xiaokaizip/foc/circuit/candence/DESIGN1.png

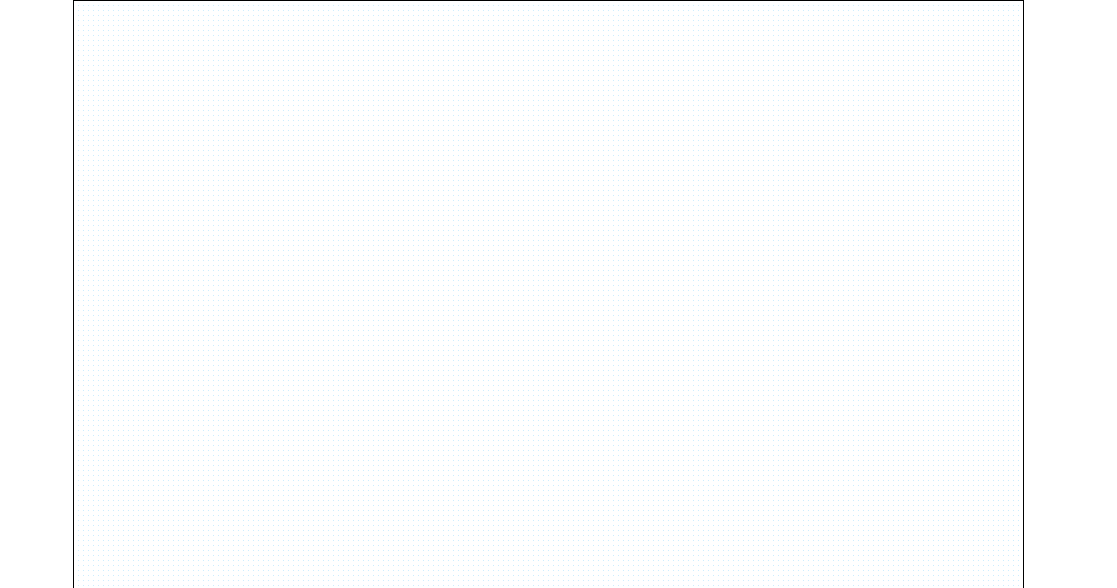
circuit/candence/DESIGN1.png
