xiaokaizip/foc/circuit/candence/hpm/HPM_ECAT_FOC.png

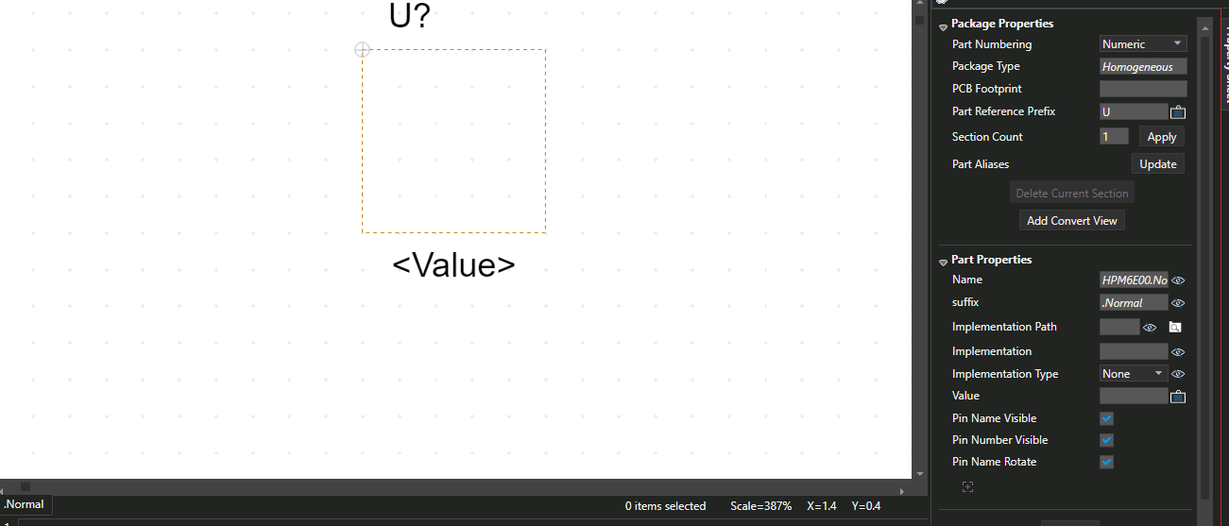
circuit/candence/hpm/HPM_ECAT_FOC.png
