xiaokaizip/foc/circuit/candence/POWER.png

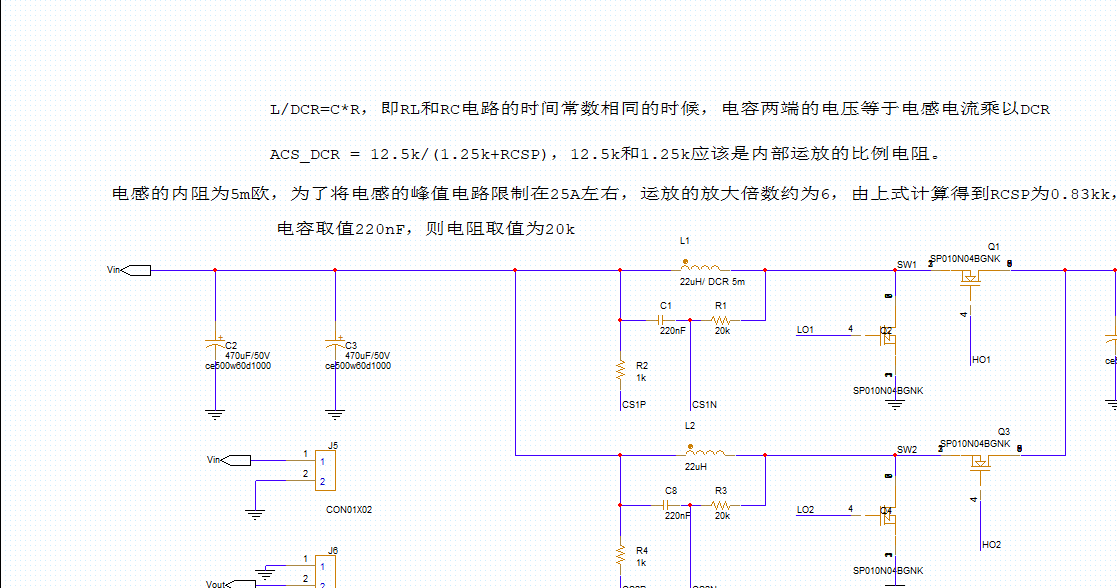
circuit/candence/POWER.png
