xiaokaizip/foc/circuit/candence/stm32/STSPIN32G4_FOC.png

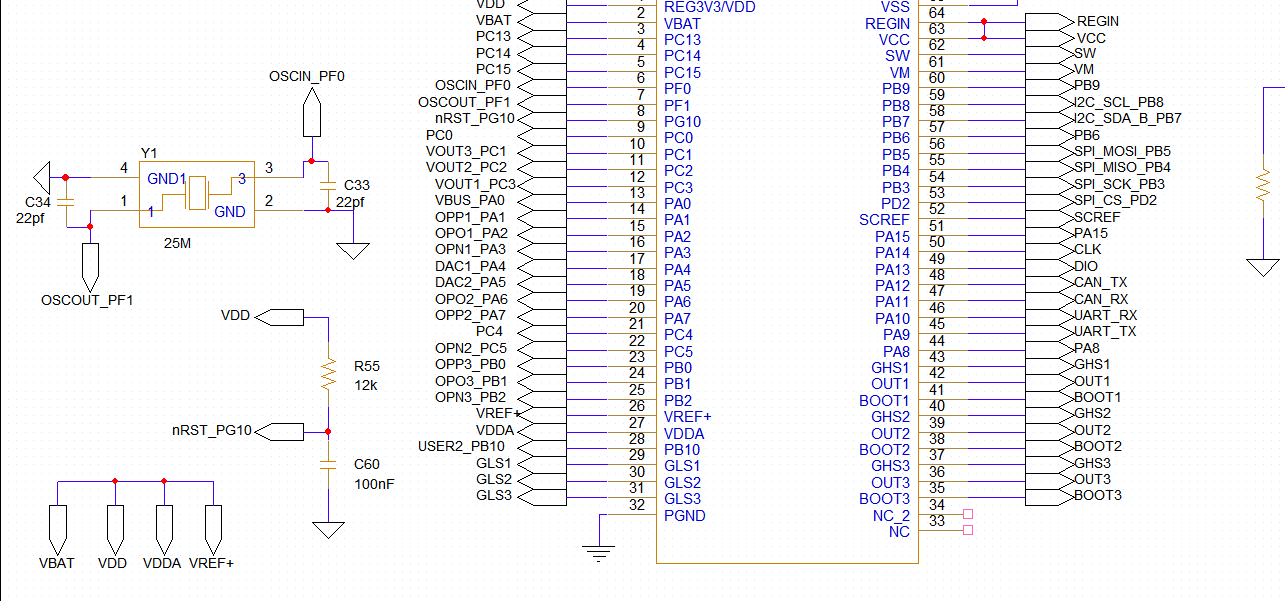
circuit/candence/stm32/STSPIN32G4_FOC.png
