xiaokaizip/foc/circuit/candence/stm32/STSPIN32G4.xlsx

Revised: Thursday, November 20, 2025
Revision:
Bill Of Materials November 20,2025 11:11:35 | Page1
Item | Quantity | Reference | Part | footprint | JLC
______________________________________________
1 | 4 | C1,C2,C3,C4 | 22nF | c0402
2 | 2 | C5,C6 | 22nF | r0402
3 | 14 | C7,C8,C11,C23,C24,C25,C26,C27,C28,C35,C37,C39,C41,C42 | 100nF | c0402
4 | 1 | C13 | 10u | c0805 | C440198
5 | 21 | C14,C15,C16,C17,C18,C19,C20,C21,C22,C48,C49,C50,C51,C52,C53,C54,C55,C56,C57,C58,C59 | 10u | c0805
6 | 1 | C29 | 220nF | c0402
7 | 2 | C30,C31 | 22uF | c1206
8 | 1 | C32 | 22uF | c0805
9 | 2 | C33,C34 | 22pf | c0402
10 | 3 | C36,C38,C40 | 1uF | c0603
11 | 5 | C43,C44,C45,C46,C47 | 10u | c0603
12 | 2 | D1,D2 | LED | led0402
13 | 1 | D7 | B5819WSL | sod_323
14 | 1 | D8 | SMBJ36CA | sod_214
15 | 1 | D9 | JLC | sod123 | C353271
16 | 1 | F1 | fulse | r1206
17 | 1 | J1 | SH_01x03 | SH1_0_3p
18 | 1 | J2 | SH_01x08 | SH1_0_8p
19 | 1 | J3 | hole_01x04 | 4_hole
20 | 3 | J4,J5,J6 | CON_01x01 | SMD50_50
21 | 1 | L1 | DLW21HN900SQ2L | SMD-4P
22 | 1 | L2 | 10uH | R1210
23 | 2 | NTC1,NTC2 | 10k | r0603
24 | 8 | R1,R5,R6,R9,R10,R15,R16,R17 | 24k | r0402
25 | 13 | R2,R7,R8,R11,R12,R18,R19,R20,R44,R46,R47,R48,R49 | 2k | R0402
26 | 2 | R3,R4 | 4.7k | r0402
27 | 8 | R13,R14,R24,R25,R26,R33,R34,R35 | 12k | r0402
28 | 6 | R21,R22,R23,R30,R31,R32 | 10R | r0402
29 | 3 | R39,R40,R41 | 50m | r0805
30 | 2 | R42,R43 | 60 | R0402
31 | 1 | R45 | 2k | c0402
32 | 7 | U1,U2,U3,U4,U5,U6,U11 | CSD18543Q3ADNH | DNH0008A
33 | 1 | U7 | TCAN3403 | SOT-23-THIN-8_DDF_TEX
34 | 1 | U8 | ESD2CAN | sot23-3
35 | 1 | U9 | MT6825 | PW0016A_L
36 | 1 | U10 | STSPIN32G4 | QFN_IN32G4_STM
37 | 1 | Y1 | 25M | x4-3225
