xiaokaizip/foc/circuit/candence/stm32/20251127 -便携式数据采集线材-林凯.xlsx

物品名称 | 用途 | 型号 | 数量 | 参考图片 | 参考链接 | 单价（元） | 总价（元） | 备注
12VPD诱骗线 | 便携式数据采集相机供电用 | Type-C转PD12V3A诱骗线 | 5 |  | https://detail.tmall.com/item.htm?ali_trackid=1_b0a4eecbaa4b6b593b52d8781035511b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 | 19.32 | 96.6 | 深圳收货
扁平网线 | 便携式数据采集网线接口 | 超短体-纯铜七类万兆网线 黑色 0.5m | 5 |  | https://detail.tmall.com/item.htm?ali_trackid=1_3b86c21500981edd2e272d85cf04a002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 | 13.6 | 68
 |  |  |  |  |  | 林凯 2025.11.27
