xiaokaizip/foc/circuit/candence/stm32/STSPIN32G4_FOC.xlsx

Revised: Thursday, November 20, 2025
Revision:
Bill Of Materials November 20,2025 10:31:08 | Page1
Item | Quantity | Reference | Part | JLC
______________________________________________
1 | 6 | C1,C2,C3,C4,C5,C6 | 22nF
2 | 14 | C7,C8,C11,C23,C24,C25,C26,C27,C28,C35,C37,C39,C41,C42 | 100nF
3 | 1 | C13 | 10u | C440198
4 | 26 | C14,C15,C16,C17,C18,C19,C20,C21,C22,C43,C44,C45,C46,C47,C48,C49,C50,C51,C52,C53,C54,C55,C56,C57,C58,C59 | 10u
5 | 1 | C29 | 220nF
6 | 3 | C30,C31,C32 | 22uF
7 | 2 | C33,C34 | 22pf
8 | 3 | C36,C38,C40 | 1uF
9 | 2 | D1,D2 | LED
10 | 1 | D7 | B5819WSL
11 | 1 | D8 | SMBJ36CA
12 | 1 | D9 | JLC | C353271
13 | 1 | F1 | fulse
14 | 1 | J1 | SH_01x03
15 | 1 | J2 | SH_01x08
16 | 1 | J3 | hole_01x04
17 | 3 | J4,J5,J6 | CON_01x01
18 | 1 | L1 | DLW21HN900SQ2L
19 | 1 | L2 | 10uH
20 | 2 | NTC1,NTC2 | 10k
21 | 8 | R1,R5,R6,R9,R10,R15,R16,R17 | 24k
22 | 14 | R2,R7,R8,R11,R12,R18,R19,R20,R44,R45,R46,R47,R48,R49 | 2k
23 | 2 | R3,R4 | 4.7k
24 | 8 | R13,R14,R24,R25,R26,R33,R34,R35 | 12k
25 | 6 | R21,R22,R23,R30,R31,R32 | 10R
26 | 3 | R39,R40,R41 | 50m
27 | 2 | R42,R43 | 60
28 | 7 | U1,U2,U3,U4,U5,U6,U11 | CSD18543Q3ADNH
29 | 1 | U7 | TCAN3403
30 | 1 | U8 | ESD2CAN
31 | 1 | U9 | MT6825
32 | 1 | U10 | STSPIN32G4
33 | 1 | Y1 | 25M
