xiaokaizip/foc/circuit/candence/stm32/DM3510.dxf

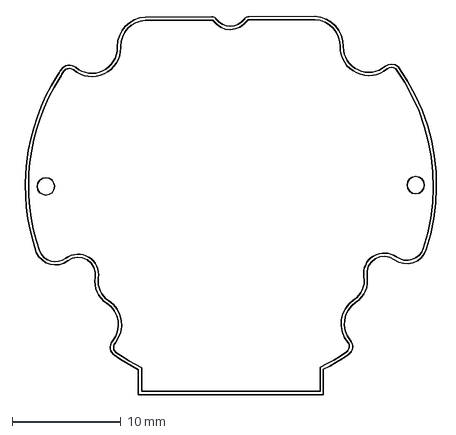
[picture p7: CAD file, 2026-01-14]
circuit/candence/stm32/DM3510.dxf
39.0 x 34.8 mm
