xiaokaizip/foc/circuit/candence/stm32/FILM_SETUP.txt

axlFilmCreate( "all" ?negative nil ?undefineLineWidth 0.1524 ?sequence 1 
	?rotation 0 ?xOffset 0.0000 ?yOffset 0.0000 ?shapeBoundingBox 0.0000 ?mirrored nil ?fullContact nil 
	?suppressUnconnectPads nil ?drawMissingPadApertures nil ?useApertureRotation nil 
	?suppressShapeFill nil ?vectorBasedPad t ?drawHolesOnly nil 
	?domains '(ipc2581 pdf artwork visibility ) ?ipc2581 '() 
	?layers '("PIN/TOP" "PIN/BOTTOM" "PACKAGE GEOMETRY/SILKSCREEN_TOP" "BOARD GEOMETRY/SILKSCREEN_TOP" "PACKAGE GEOMETRY/SILKSCREEN_BOTTOM" "BOARD GEOMETRY/SILKSCREEN_BOTTOM" "BOARD GEOMETRY/OUTLINE" ))
axlFilmCreate( "adt" ?negative nil ?undefineLineWidth 0.1524 ?sequence 2 
	?rotation 0 ?xOffset 0.0000 ?yOffset 0.0000 ?shapeBoundingBox 0.0000 ?mirrored nil ?fullContact nil 
	?suppressUnconnectPads nil ?drawMissingPadApertures nil ?useApertureRotation nil 
	?suppressShapeFill nil ?vectorBasedPad t ?drawHolesOnly nil 
	?domains '(ipc2581 pdf artwork visibility ) ?ipc2581 '() 
	?layers '("BOARD GEOMETRY/SILKSCREEN_TOP" "REF DES/SILKSCREEN_TOP" "PIN/TOP" "BOARD GEOMETRY/OUTLINE" ))
axlFilmCreate( "adb" ?negative nil ?undefineLineWidth 0.1524 ?sequence 3 
	?rotation 0 ?xOffset 0.0000 ?yOffset 0.0000 ?shapeBoundingBox 0.0000 ?mirrored nil ?fullContact nil 
	?suppressUnconnectPads nil ?drawMissingPadApertures nil ?useApertureRotation nil 
	?suppressShapeFill nil ?vectorBasedPad t ?drawHolesOnly nil 
	?domains '(ipc2581 pdf artwork visibility ) ?ipc2581 '() 
	?layers '("REF DES/SILKSCREEN_BOTTOM" "PACKAGE GEOMETRY/SILKSCREEN_BOTTOM" "BOARD GEOMETRY/SILKSCREEN_BOTTOM" "PIN/BOTTOM" "BOARD GEOMETRY/OUTLINE" ))
axlFilmCreate( "top" ?negative nil ?undefineLineWidth 0.1524 ?sequence 4 
	?rotation 0 ?xOffset 0.0000 ?yOffset 0.0000 ?shapeBoundingBox 0.0000 ?mirrored nil ?fullContact nil 
	?suppressUnconnectPads nil ?drawMissingPadApertures nil ?useApertureRotation nil 
	?suppressShapeFill nil ?vectorBasedPad t ?drawHolesOnly nil 
	?domains '(ipc2581 pdf artwork visibility ) ?ipc2581 '() 
	?layers '("VIA CLASS/TOP" "PIN/TOP" "ETCH/TOP" ))
axlFilmCreate( "gnd2" ?negative nil ?undefineLineWidth 0.1524 ?sequence 5 
	?rotation 0 ?xOffset 0.0000 ?yOffset 0.0000 ?shapeBoundingBox 0.0000 ?mirrored nil ?fullContact nil 
	?suppressUnconnectPads nil ?drawMissingPadApertures nil ?useApertureRotation nil 
	?suppressShapeFill nil ?vectorBasedPad t ?drawHolesOnly nil 
	?domains '(ipc2581 pdf artwork visibility ) ?ipc2581 '() 
	?layers '("VIA CLASS/GND2" "PIN/GND2" "ETCH/GND2" ))
axlFilmCreate( "power3" ?negative nil ?undefineLineWidth 0.1524 ?sequence 6 
	?rotation 0 ?xOffset 0.0000 ?yOffset 0.0000 ?shapeBoundingBox 0.0000 ?mirrored nil ?fullContact nil 
	?suppressUnconnectPads nil ?drawMissingPadApertures nil ?useApertureRotation nil 
	?suppressShapeFill nil ?vectorBasedPad t ?drawHolesOnly nil 
	?domains '(ipc2581 pdf artwork visibility ) ?ipc2581 '() 
	?layers '("VIA CLASS/POWER3" "PIN/POWER3" "ETCH/POWER3" ))
axlFilmCreate( "bottom" ?negative nil ?undefineLineWidth 0.1524 ?sequence 7 
	?rotation 0 ?xOffset 0.0000 ?yOffset 0.0000 ?shapeBoundingBox 0.0000 ?mirrored nil ?fullContact nil 
	?suppressUnconnectPads nil ?drawMissingPadApertures nil ?useApertureRotation nil 
	?suppressShapeFill nil ?vectorBasedPad t ?drawHolesOnly nil 
	?domains '(ipc2581 pdf artwork visibility ) ?ipc2581 '() 
	?layers '("VIA CLASS/BOTTOM" "PIN/BOTTOM" "ETCH/BOTTOM" ))
axlFilmCreate( "silktop" ?negative nil ?undefineLineWidth 0.1524 ?sequence 8 
	?rotation 0 ?xOffset 0.0000 ?yOffset 0.0000 ?shapeBoundingBox 0.0000 ?mirrored nil ?fullContact nil 
	?suppressUnconnectPads nil ?drawMissingPadApertures nil ?useApertureRotation nil 
	?suppressShapeFill nil ?vectorBasedPad t ?drawHolesOnly nil 
	?domains '(ipc2581 pdf artwork visibility ) ?ipc2581 '() 
	?layers '("REF DES/SILKSCREEN_TOP" "PACKAGE GEOMETRY/SILKSCREEN_TOP" "BOARD GEOMETRY/SILKSCREEN_TOP" "BOARD GEOMETRY/OUTLINE" ))
axlFilmCreate( "silkbot" ?negative nil ?undefineLineWidth 0.1524 ?sequence 9 
	?rotation 0 ?xOffset 0.0000 ?yOffset 0.0000 ?shapeBoundingBox 0.0000 ?mirrored nil ?fullContact nil 
	?suppressUnconnectPads nil ?drawMissingPadApertures nil ?useApertureRotation nil 
	?suppressShapeFill nil ?vectorBasedPad t ?drawHolesOnly nil 
	?domains '(ipc2581 pdf artwork visibility ) ?ipc2581 '() 
	?layers '("REF DES/SILKSCREEN_BOTTOM" "PACKAGE GEOMETRY/SILKSCREEN_BOTTOM" "BOARD GEOMETRY/SILKSCREEN_BOTTOM" "BOARD GEOMETRY/OUTLINE" ))
axlFilmCreate( "soldtop" ?negative nil ?undefineLineWidth 0.1524 ?sequence 10 
	?rotation 0 ?xOffset 0.0000 ?yOffset 0.0000 ?shapeBoundingBox 0.0000 ?mirrored nil ?fullContact nil 
	?suppressUnconnectPads nil ?drawMissingPadApertures nil ?useApertureRotation nil 
	?suppressShapeFill nil ?vectorBasedPad t ?drawHolesOnly nil 
	?domains '(ipc2581 pdf artwork visibility ) ?ipc2581 '() 
	?layers '("PIN/SOLDERMASK_TOP" "PACKAGE GEOMETRY/SOLDERMASK_TOP" "BOARD GEOMETRY/SOLDERMASK_TOP" "BOARD GEOMETRY/OUTLINE" ))
axlFilmCreate( "soldbot" ?negative nil ?undefineLineWidth 0.1524 ?sequence 11 
	?rotation 0 ?xOffset 0.0000 ?yOffset 0.0000 ?shapeBoundingBox 0.0000 ?mirrored nil ?fullContact nil 
	?suppressUnconnectPads nil ?drawMissingPadApertures nil ?useApertureRotation nil 
	?suppressShapeFill nil ?vectorBasedPad t ?drawHolesOnly nil 
	?domains '(ipc2581 pdf artwork visibility ) ?ipc2581 '() 
	?layers '("PIN/SOLDERMASK_BOTTOM" "PACKAGE GEOMETRY/SOLDERMASK_BOTTOM" "BOARD GEOMETRY/SOLDERMASK_BOTTOM" "BOARD GEOMETRY/OUTLINE" ))
axlFilmCreate( "pasttop" ?negative nil ?undefineLineWidth 0.1524 ?sequence 12 
	?rotation 0 ?xOffset 0.0000 ?yOffset 0.0000 ?shapeBoundingBox 0.0000 ?mirrored nil ?fullContact nil 
	?suppressUnconnectPads nil ?drawMissingPadApertures nil ?useApertureRotation nil 
	?suppressShapeFill nil ?vectorBasedPad t ?drawHolesOnly nil 
	?domains '(ipc2581 pdf artwork visibility ) ?ipc2581 '() 
	?layers '("PIN/PASTEMASK_TOP" "PACKAGE GEOMETRY/PASTEMASK_TOP" "BOARD GEOMETRY/OUTLINE" ))
axlFilmCreate( "pastbot" ?negative nil ?undefineLineWidth 0.1524 ?sequence 13 
	?rotation 0 ?xOffset 0.0000 ?yOffset 0.0000 ?shapeBoundingBox 0.0000 ?mirrored nil ?fullContact nil 
	?suppressUnconnectPads nil ?drawMissingPadApertures nil ?useApertureRotation nil 
	?suppressShapeFill nil ?vectorBasedPad t ?drawHolesOnly nil 
	?domains '(ipc2581 pdf artwork visibility ) ?ipc2581 '() 
	?layers '("PIN/PASTEMASK_BOTTOM" "PACKAGE GEOMETRY/PASTEMASK_BOTTOM" "BOARD GEOMETRY/OUTLINE" ))
axlFilmCreate( "drill" ?negative nil ?undefineLineWidth 0.1524 ?sequence 14 
	?rotation 0 ?xOffset 0.0000 ?yOffset 0.0000 ?shapeBoundingBox 0.0000 ?mirrored nil ?fullContact nil 
	?suppressUnconnectPads nil ?drawMissingPadApertures nil ?useApertureRotation nil 
	?suppressShapeFill t ?vectorBasedPad t ?drawHolesOnly nil 
	?domains '(ipc2581 pdf artwork visibility ) ?ipc2581 '() 
	?layers '("BOARD GEOMETRY/DIMENSION" "BOARD GEOMETRY/OUTLINE" "MANUFACTURING/NCDRILL_LEGEND" "MANUFACTURING/NCDRILL_FIGURE" ))
axlFilmCreate( "outline" ?negative nil ?undefineLineWidth 0.1524 ?sequence 15 
	?rotation 0 ?xOffset 0.0000 ?yOffset 0.0000 ?shapeBoundingBox 0.0000 ?mirrored nil ?fullContact nil 
	?suppressUnconnectPads nil ?drawMissingPadApertures nil ?useApertureRotation nil 
	?suppressShapeFill t ?vectorBasedPad t ?drawHolesOnly nil 
	?domains '(ipc2581 pdf artwork visibility ) ?ipc2581 '() 
	?layers '("BOARD GEOMETRY/OUTLINE" ))
