xiaokaizip/foc/docs/mb1428-g474re-b01_schematic.pdf

Title: Project overview

Size:

Reference:
A4 | Sheet: | of

Revision:

Project: STM32G4 DPOW Discovery

B 01 | MB1428
28-JUNE-19

G474RE

Date:

Variant:

Table of contents | Legend

General comment such as function title, configuration, ...

Text to be added to silkscreen.

Sheet 1: Project overview (this page)

Sheet 2: MB1428_Top

# STM32G4 DPOW Discovery

MB1428

Sheet 3: STM32 microcontroller I/Os

Sheet 4: STM32 microcontroller power

Sheet 10: ST-Link/V3E

Sheet 12: License agreement

Sheet 9: Power

Sheet 8: Extension connectors

Sheet 11: Mechanical

Warning text.

# Open Platform License Agreement

The Open Platform License Agreement (“Agreement”) is a binding legal contract between you ("You")

and STMicroelectronics International N.V. (“ST”), a company incorporated under the laws of the

Netherlands acting for the purpose of this Agreement through its Swiss branch 39, Chemin du

Champ des Filles, 1228 Plan-les-Ouates, Geneva, Switzerland.

By using the enclosed reference designs, schematics, PC board layouts, and documentation, in hardcopy

or CAD tool file format (collectively, the “Reference Material”), You are agreeing to be bound by

the terms and conditions of this Agreement. Do not use the Reference Material until You have read

and agreed to this Agreement terms and conditions. The use of the Reference Material automatically

implies the acceptance of the Agreement terms and conditions.

The complete Open Platform License Agreement can be found on www.st.com/opla.

U_MB1428_Top
MB1428_Top.SchDoc

Sheet 7: Buck Boost Converter

Sheet 6: RGB LED Buck Converters

Sheet 5: USB PD & USB Type-C

Notes to generate the
board layout.

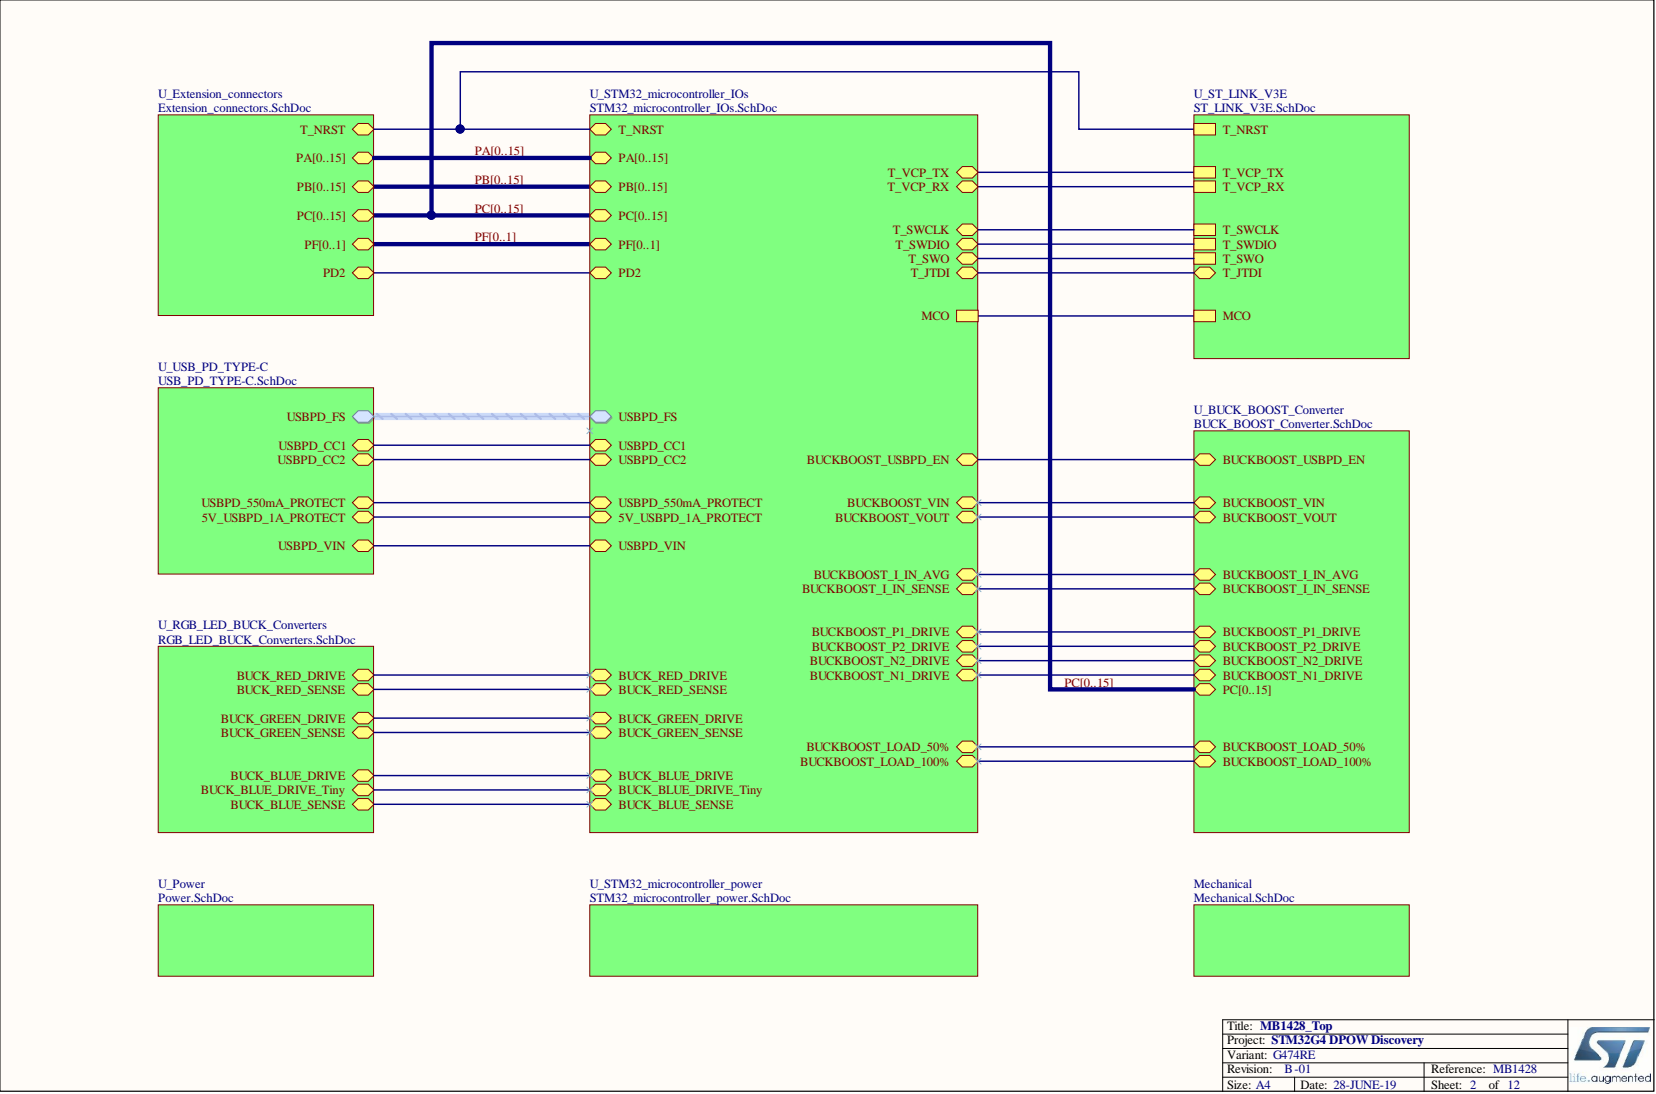
[picture p8: page 2]

Cuttable part on PCB

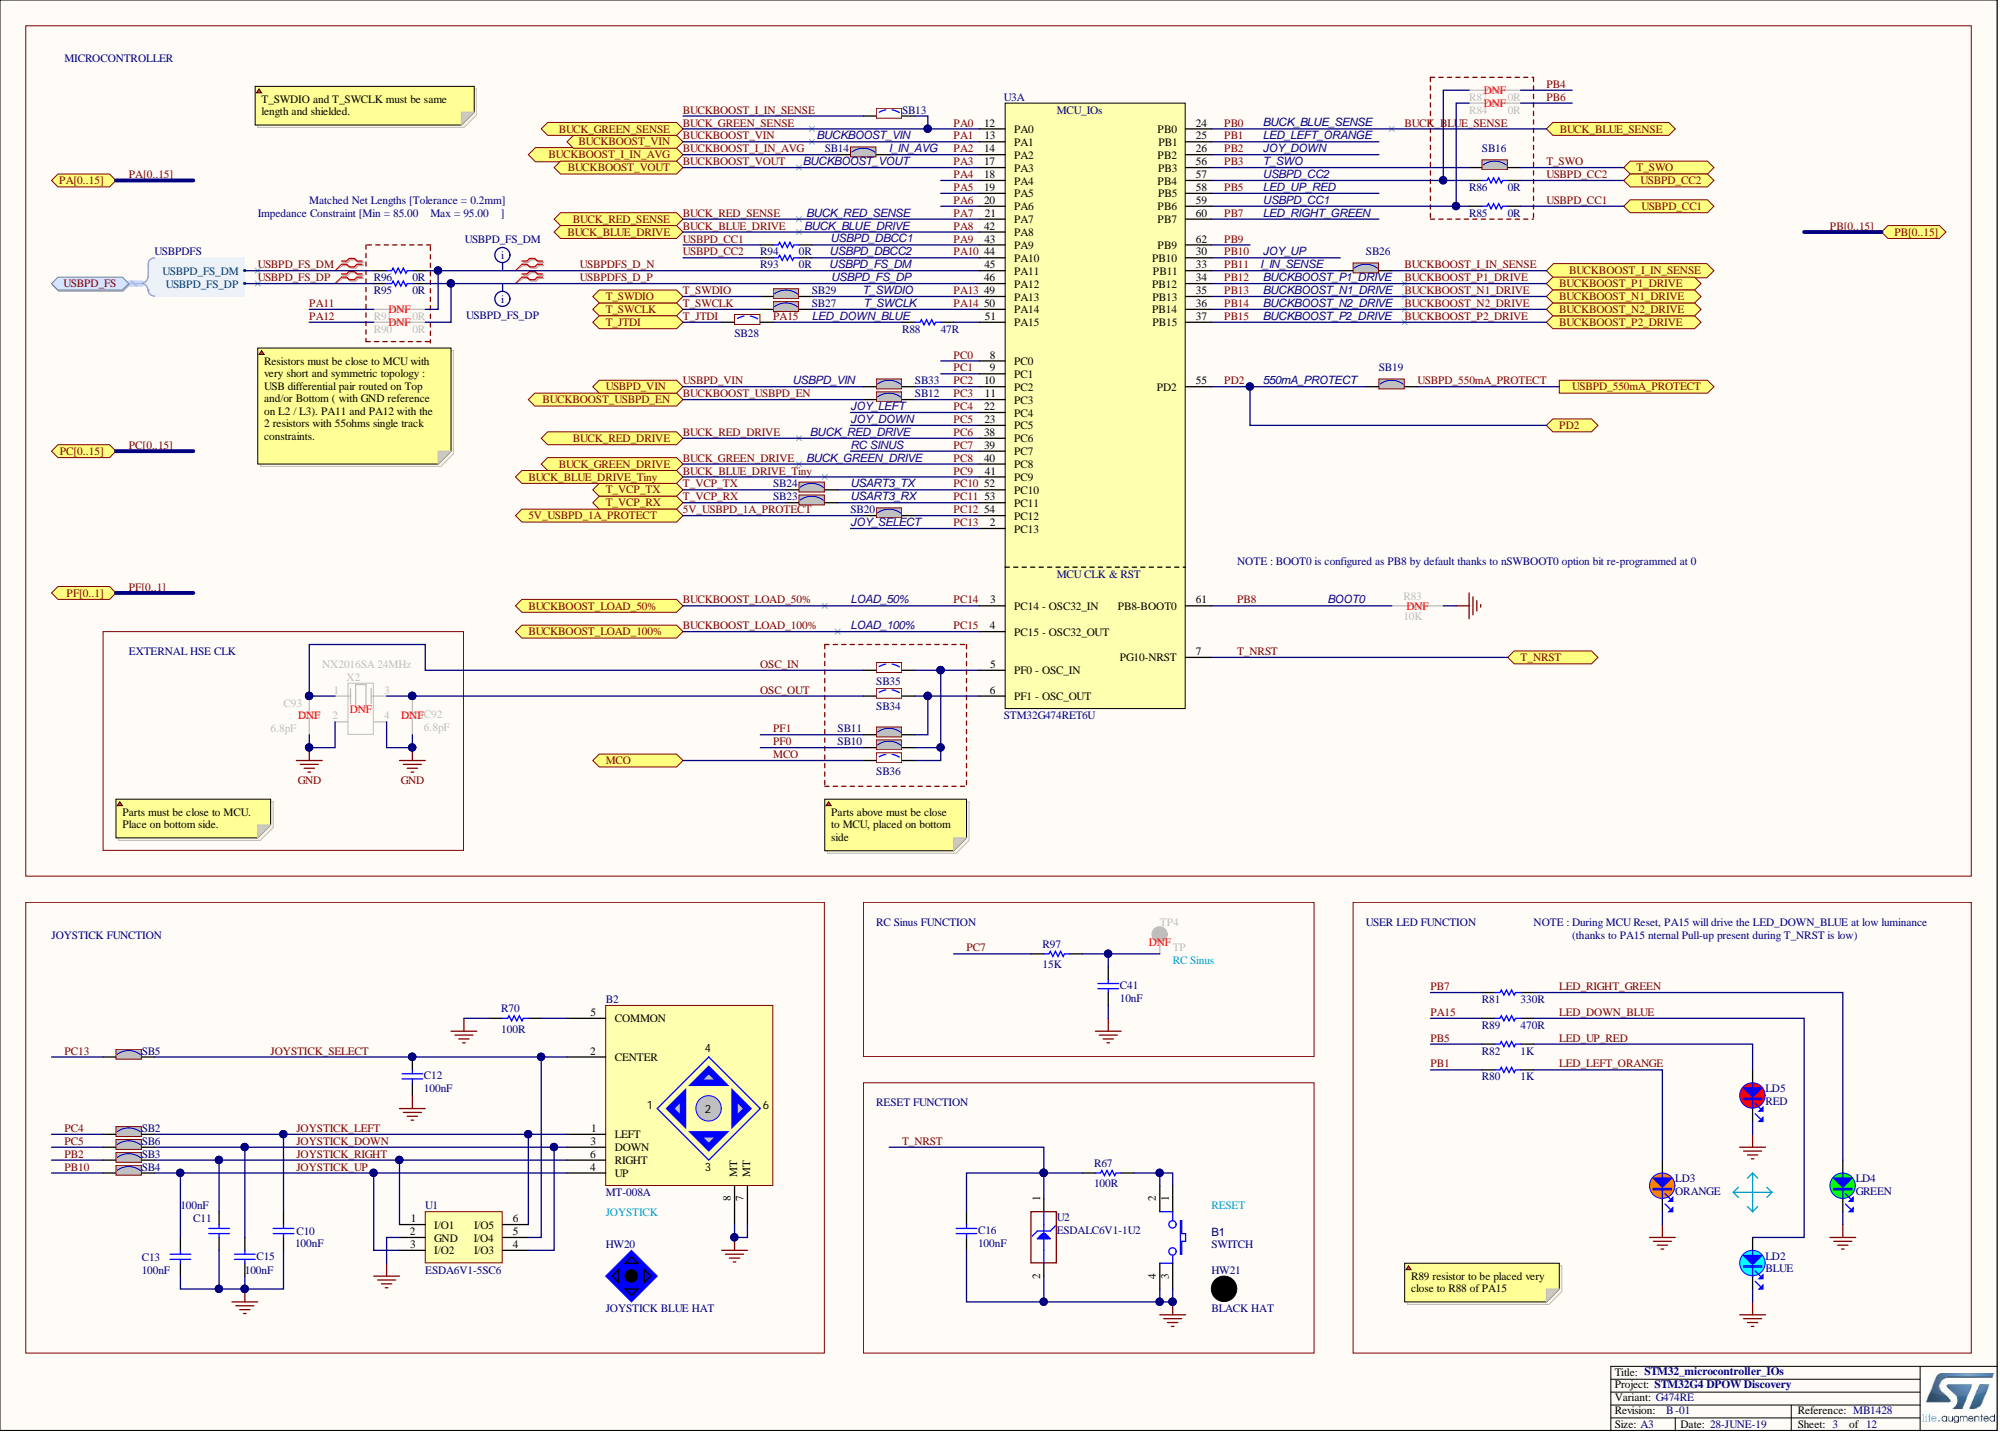
[picture p9: page 3]

T_SWDIO and T_SWCLK must be same
length and shielded.

Matched Net Lengths [Tolerance = 0.2mm]

Impedance Constraint [Min = 85.00 Max = 95.00 ]

Resistors must be close to MCU with
very short and symmetric topology :
USB differential pair routed on Top
and/or Bottom ( with GND reference
on L2 / L3). PA11 and PA12 with the
2 resistors with 55ohms single track
constraints.

NOTE : BOOT0 is configured as PB8 by default thanks to nSWBOOT0 option bit re-programmed at 0

Parts must be close to MCU.
Place on bottom side.

Parts above must be close
to MCU, placed on bottom
side

NOTE : During MCU Reset, PA15 will drive the LED_DOWN_BLUE at low luminance

(thanks to PA15 nternal Pull-up present during T_NRST is low)

CENTER 2

C12 | | | DOWN 3 LEFT 1

SB6 | JOYSTICK_DOWN
SB3 | | JOYSTICK_RIGHT | | RIGHT 6

R89 resistor to be placed very
close to R88 of PA15

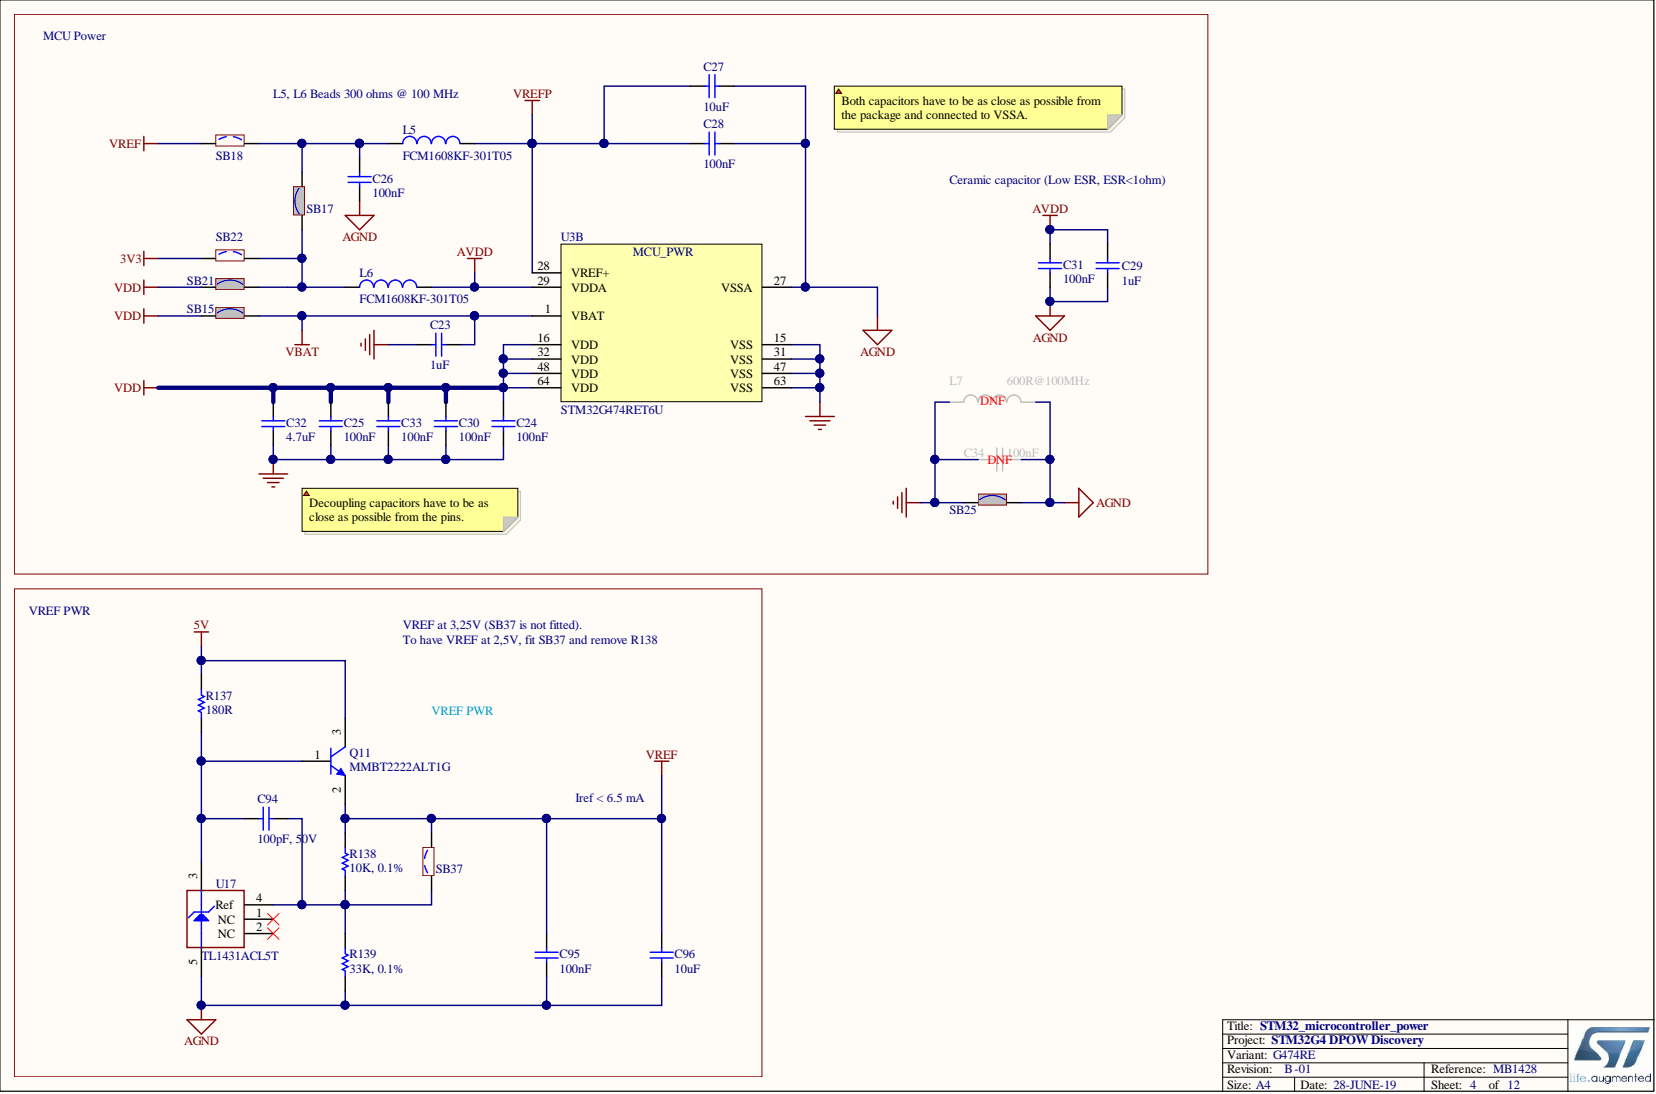
[picture p10: page 4]

Both capacitors have to be as close as possible from
the package and connected to VSSA.

Ceramic capacitor (Low ESR, ESR<1ohm)

Decoupling capacitors have to be as
close as possible from the pins.

To have VREF at 2,5V, fit SB37 and remove R138

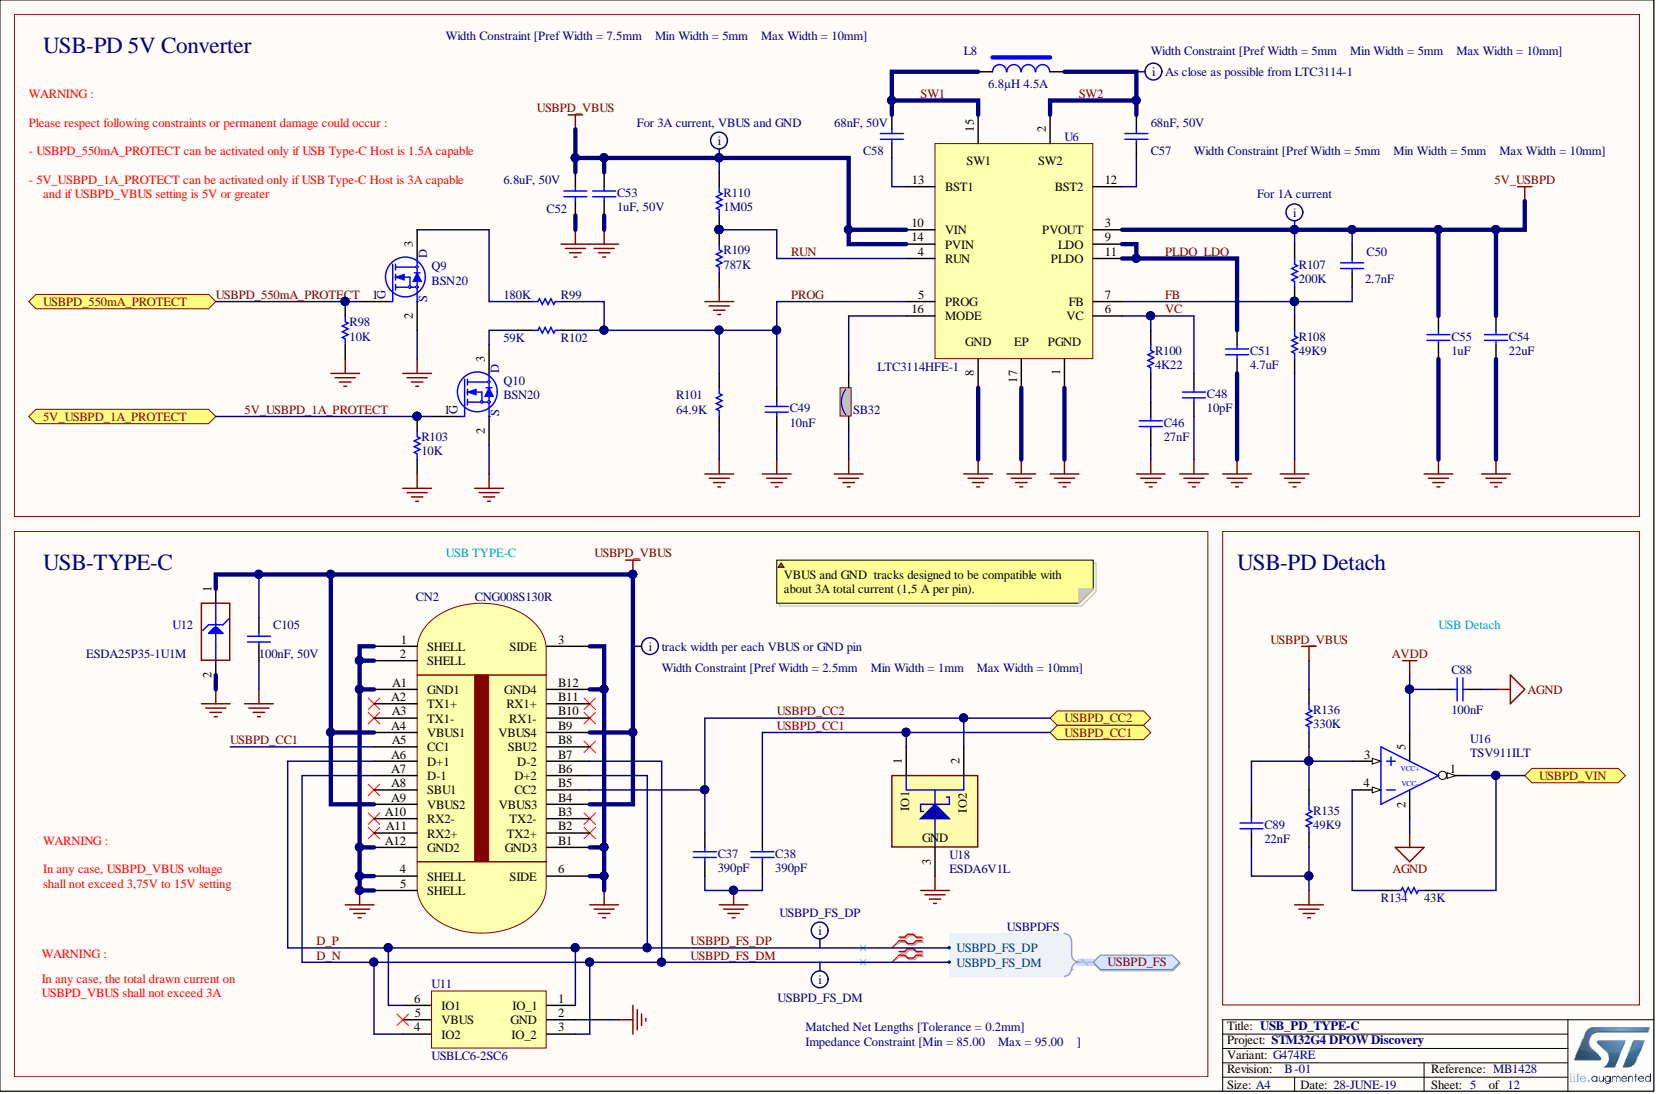
[picture p11: page 5]

Width Constraint [Pref Width = 7.5mm Min Width = 5mm Max Width = 10mm]

Width Constraint [Pref Width = 5mm Min Width = 5mm Max Width = 10mm]

i As close as possible from LTC3114-1

Please respect following constraints or permanent damage could occur :

For 3A current, VBUS and GND

- USBPD_550mA_PROTECT can be activated only if USB Type-C Host is 1.5A capable

Width Constraint [Pref Width = 5mm Min Width = 5mm Max Width = 10mm] i

- 5V_USBPD_1A_PROTECT can be activated only if USB Type-C Host is 3A capable
and if USBPD_VBUS setting is 5V or greater

VBUS and GND tracks designed to be compatible with
about 3A total current (1,5 A per pin).

i track width per each VBUS or GND pin

Width Constraint [Pref Width = 2.5mm Min Width = 1mm Max Width = 10mm]

SBU1 A8

In any case, USBPD_VBUS voltage
shall not exceed 3,75V to 15V setting

In any case, the total drawn current on
USBPD_VBUS shall not exceed 3A

Matched Net Lengths [Tolerance = 0.2mm]
Impedance Constraint [Min = 85.00 Max = 95.00 ]

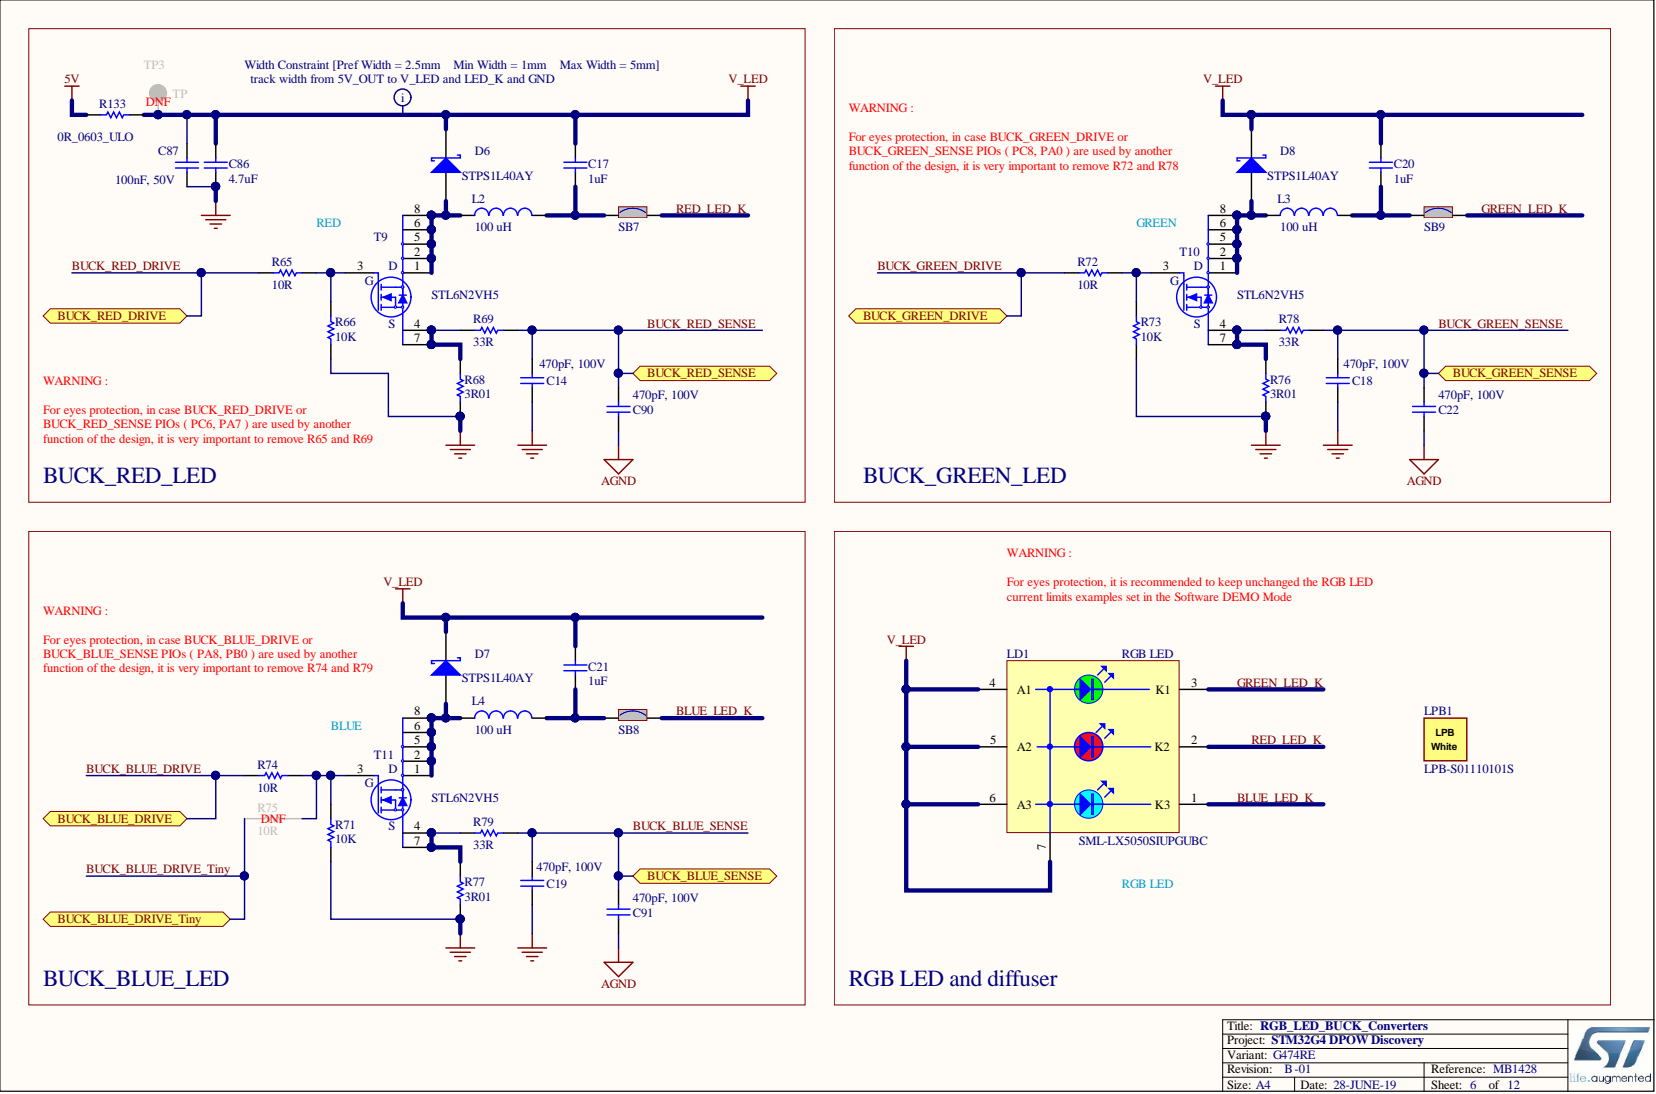
[picture p12: page 6]

Width Constraint [Pref Width = 2.5mm Min Width = 1mm Max Width = 5mm]
track width from 5V_OUT to V_LED and LED_K and GND

For eyes protection, in case BUCK_GREEN_DRIVE or
BUCK_GREEN_SENSE PIOs ( PC8, PA0 ) are used by another
function of the design, it is very important to remove R72 and R78

For eyes protection, in case BUCK_RED_DRIVE or
BUCK_RED_SENSE PIOs ( PC6, PA7 ) are used by another
function of the design, it is very important to remove R65 and R69

For eyes protection, it is recommended to keep unchanged the RGB LED
current limits examples set in the Software DEMO Mode

For eyes protection, in case BUCK_BLUE_DRIVE or
BUCK_BLUE_SENSE PIOs ( PA8, PB0 ) are used by another
function of the design, it is very important to remove R74 and R79

RGB LED and diffuser

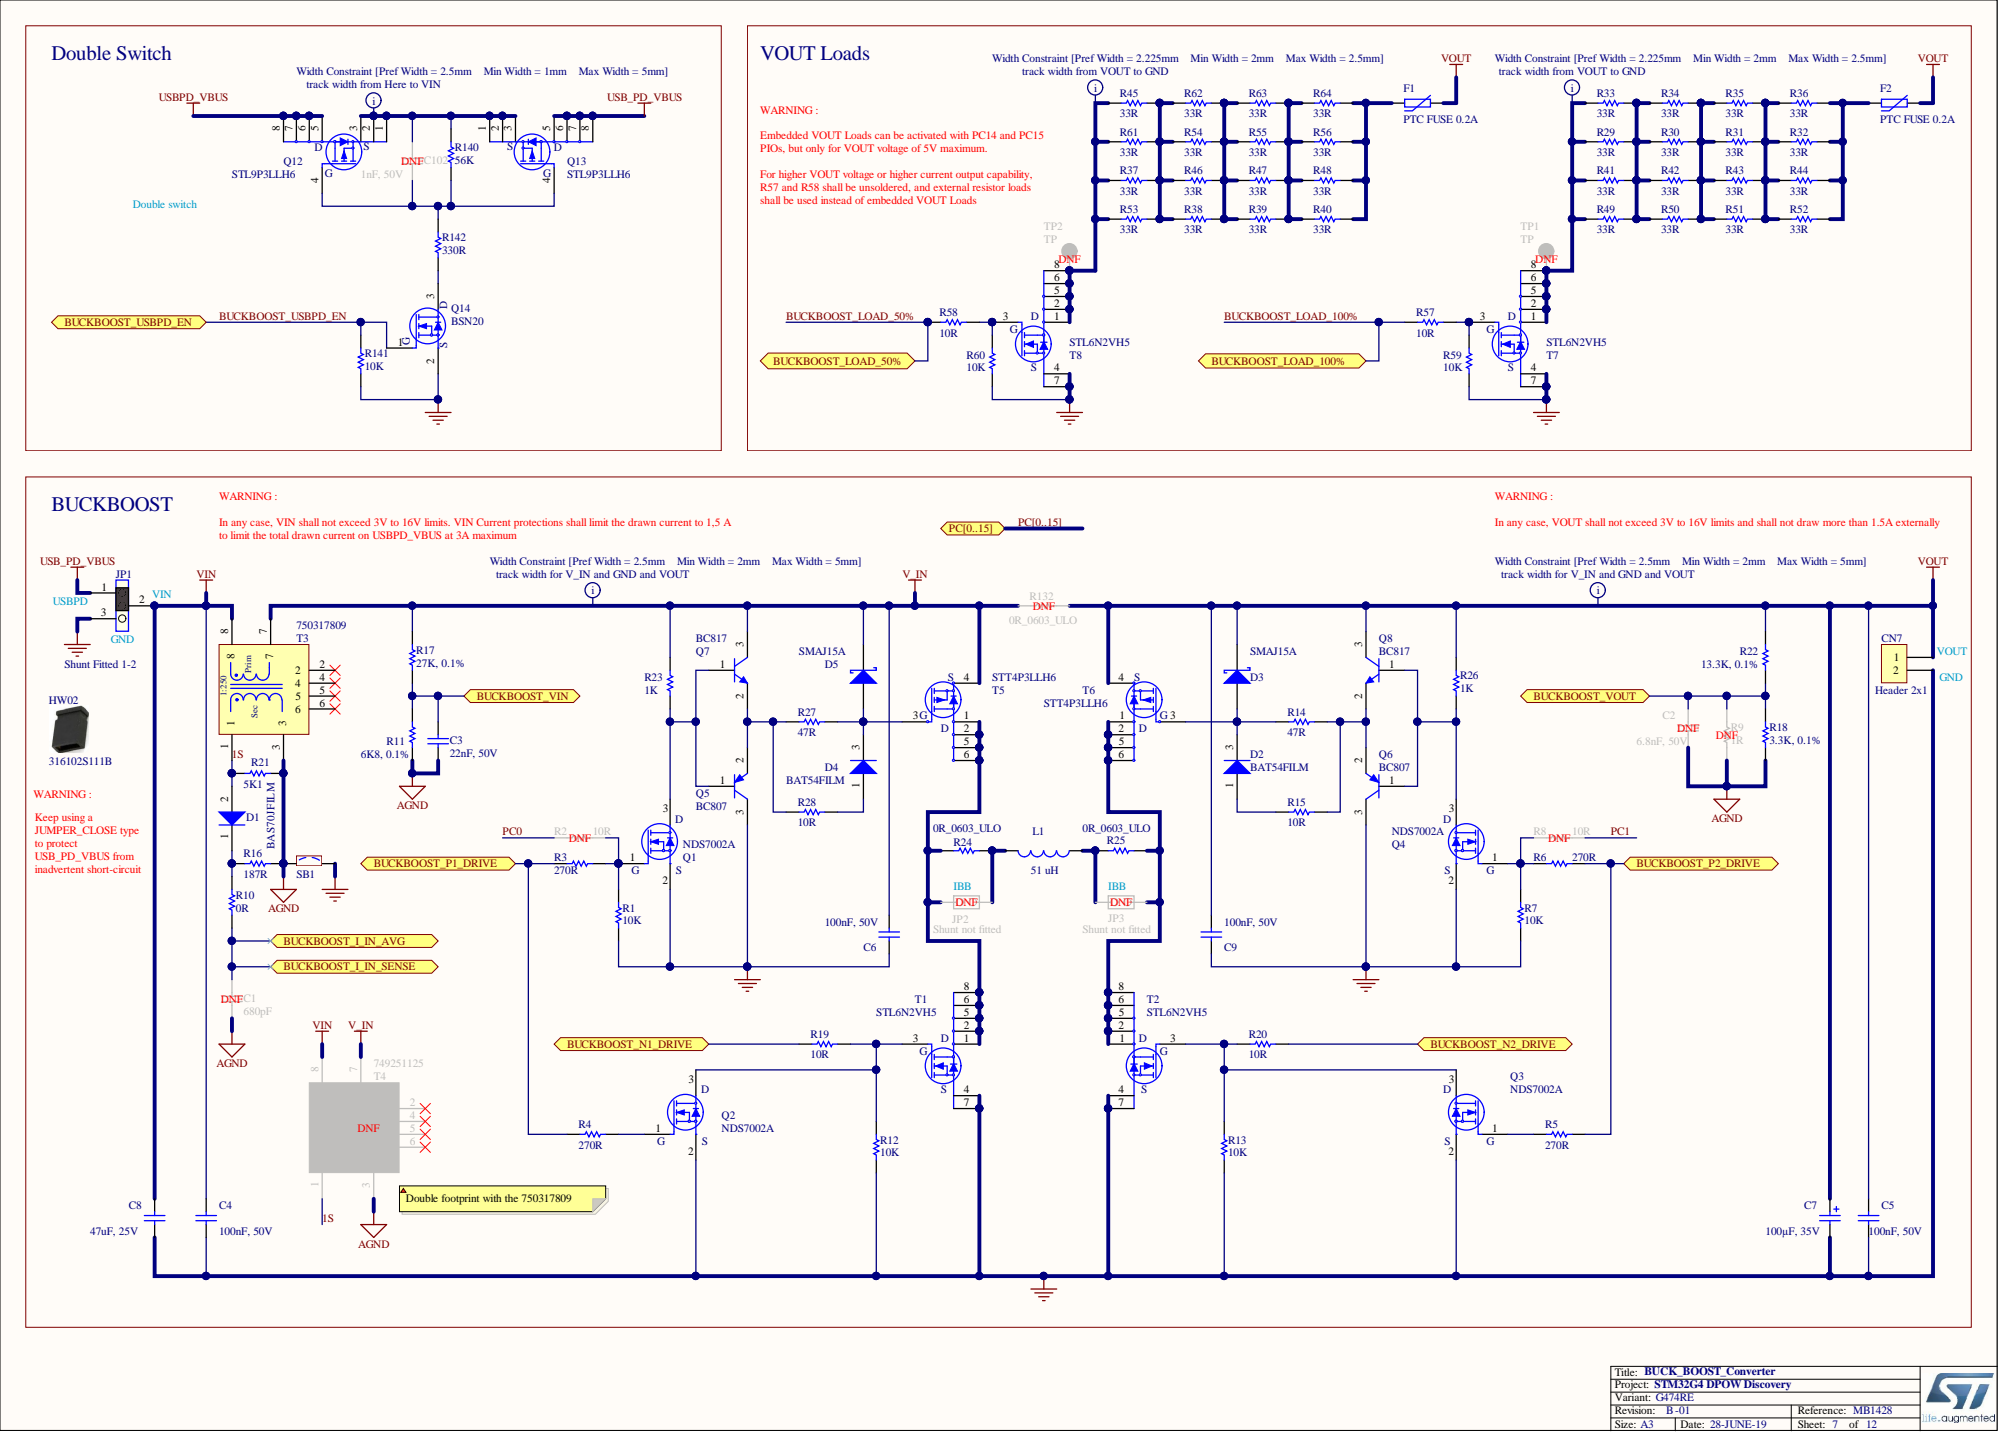
[picture p13: page 7]

Width Constraint [Pref Width = 2.225mm Min Width = 2mm Max Width = 2.5mm]
track width from VOUT to GND

Width Constraint [Pref Width = 2.5mm Min Width = 1mm Max Width = 5mm]
track width from Here to VIN

Embedded VOUT Loads can be activated with PC14 and PC15
PIOs, but only for VOUT voltage of 5V maximum.

For higher VOUT voltage or higher current output capability,
R57 and R58 shall be unsoldered, and external resistor loads
shall be used instead of embedded VOUT Loads

In any case, VIN shall not exceed 3V to 16V limits. VIN Current protections shall limit the drawn current to 1,5 A
to limit the total drawn current on USBPD_VBUS at 3A maximum

In any case, VOUT shall not exceed 3V to 16V limits and shall not draw more than 1.5A externally

Width Constraint [Pref Width = 2.5mm Min Width = 2mm Max Width = 5mm]
track width for V_IN and GND and VOUT

Double footprint with the 750317809

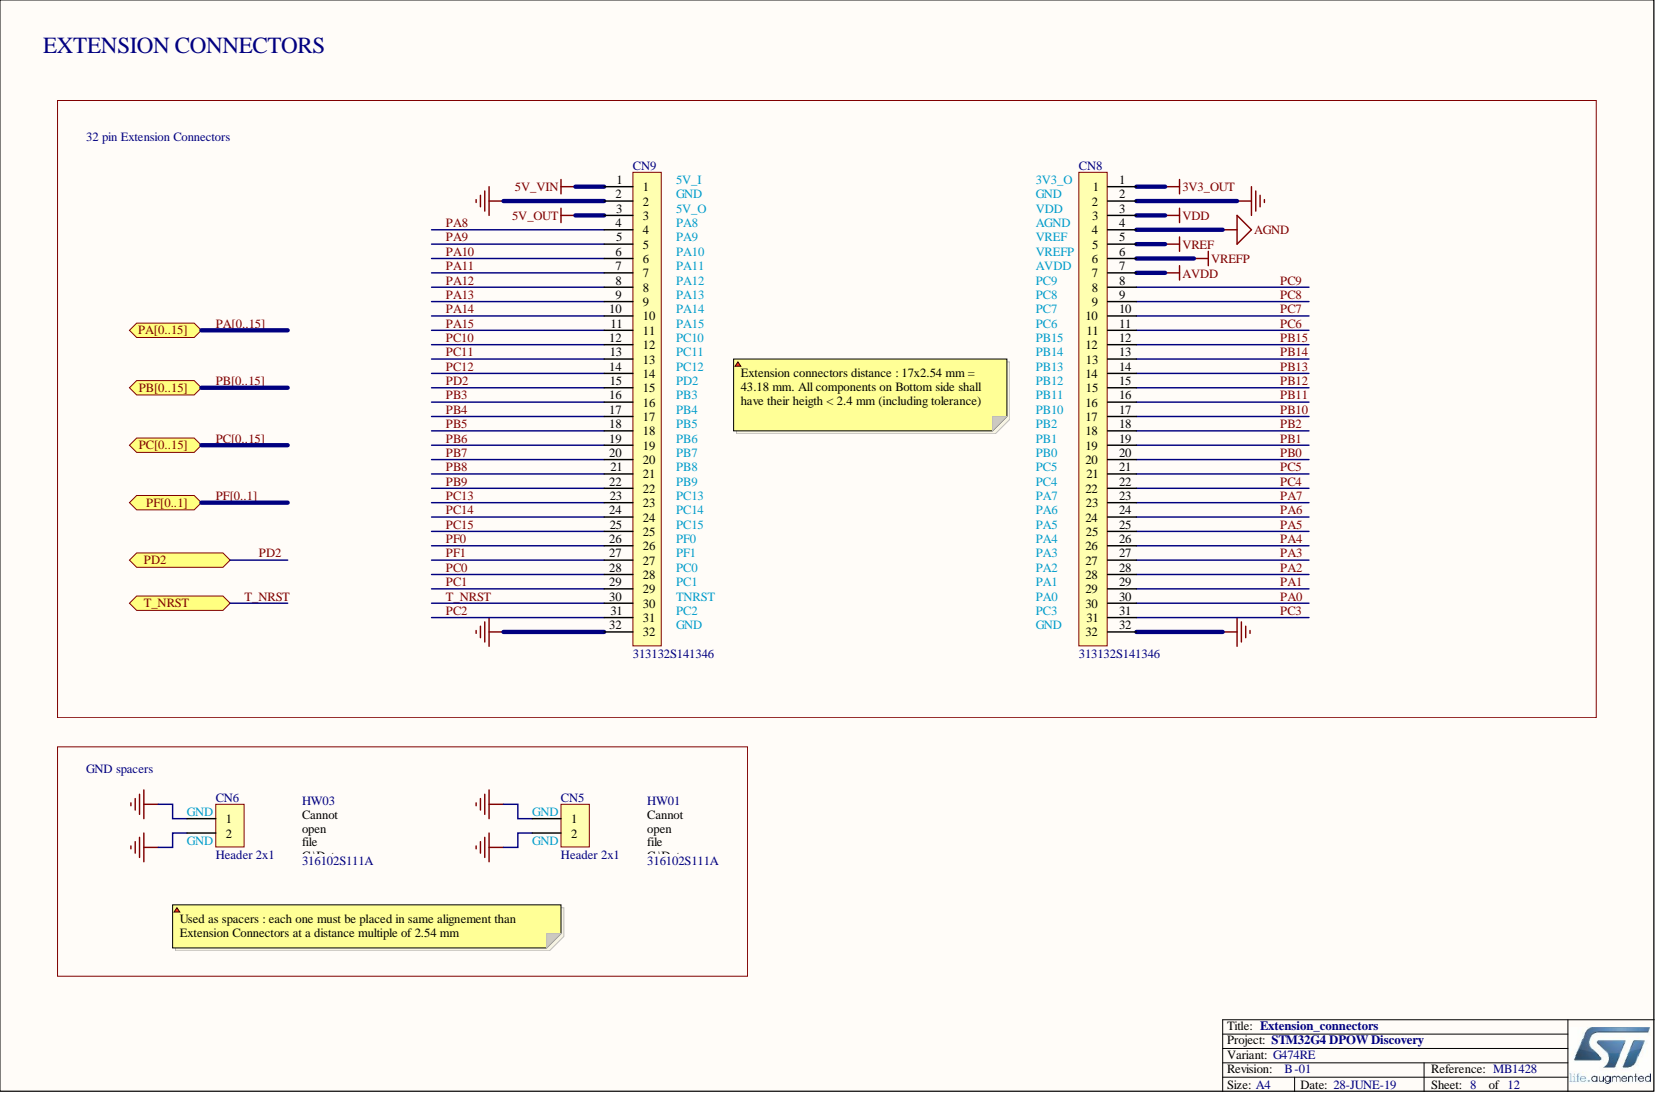
[picture p14: page 8]

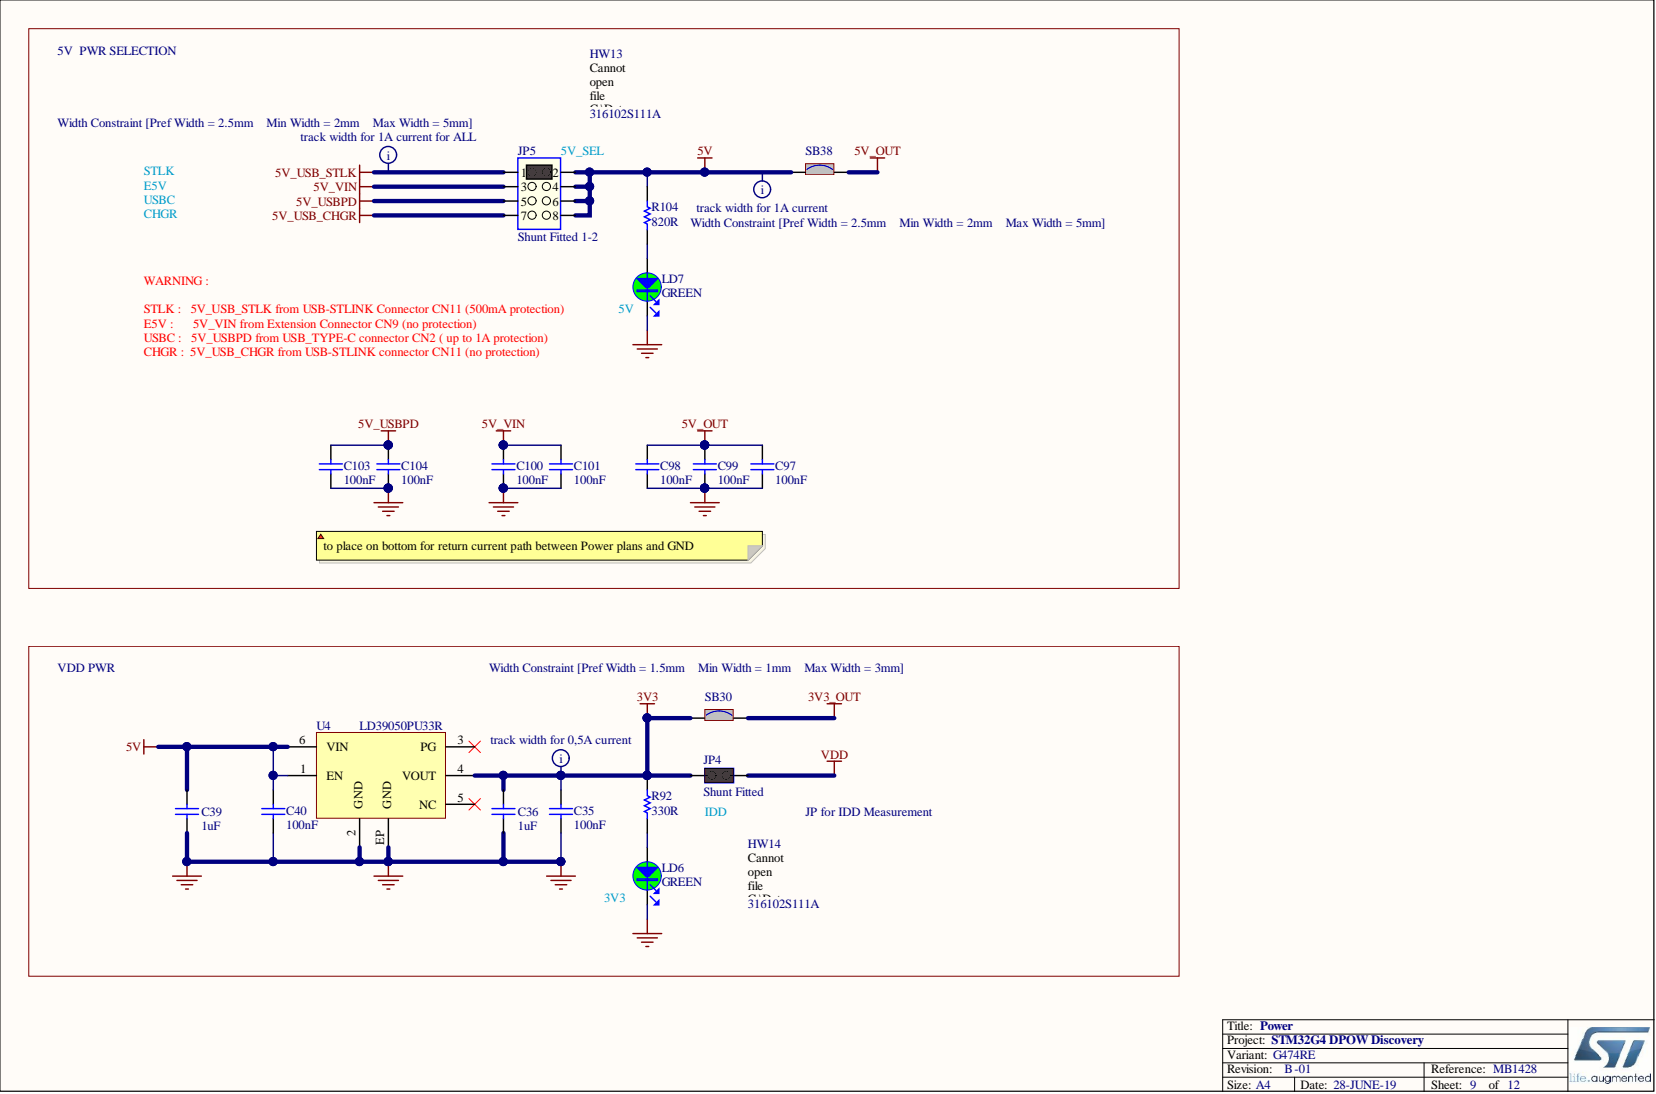
[picture p15: page 9]

Width Constraint [Pref Width = 2.5mm Min Width = 2mm Max Width = 5mm]

track width for 1A current for ALL

track width for 1A current

STLK : 5V_USB_STLK from USB-STLINK Connector CN11 (500mA protection)
USBC : 5V_USBPD from USB_TYPE-C connector CN2 ( up to 1A protection)
CHGR : 5V_USB_CHGR from USB-STLINK connector CN11 (no protection)

to place on bottom for return current path between Power plans and GND

Width Constraint [Pref Width = 1.5mm Min Width = 1mm Max Width = 3mm]

track width for 0,5A current

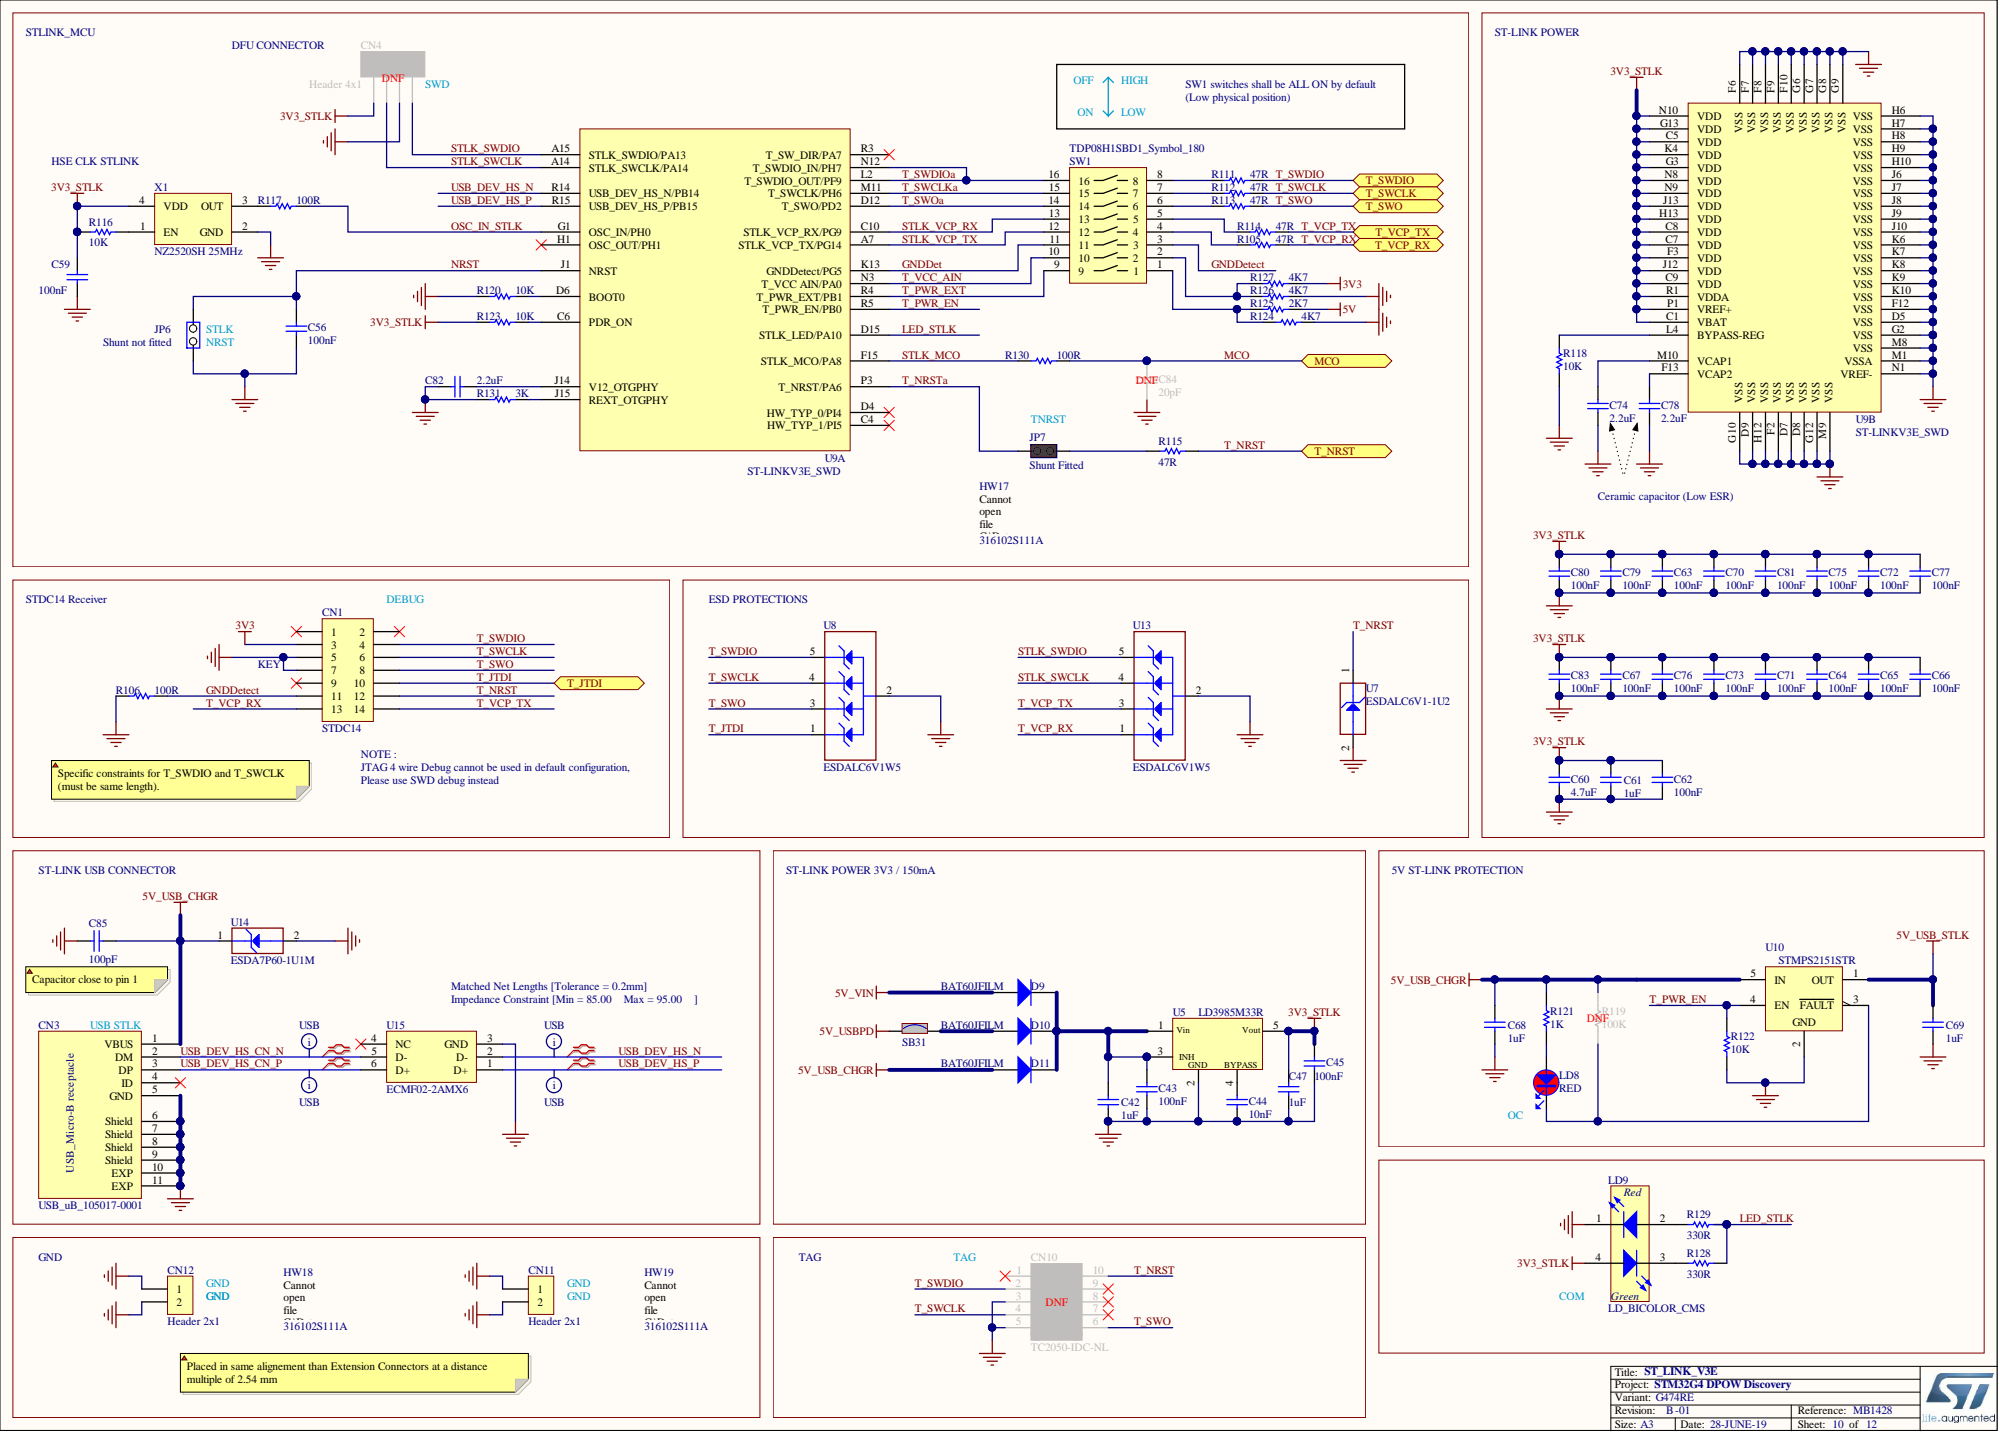
[picture p16: page 10]

VSS M9 VSS G12 VSS D8 VSS D7 VSS F2 VSS H12 VSS D9 VSS F6

Ceramic capacitor (Low ESR)

NOTE :
JTAG 4 wire Debug cannot be used in default configuration,
Please use SWD debug instead

Specific constraints for T_SWDIO and T_SWCLK
(must be same length).

Capacitor close to pin 1

Matched Net Lengths [Tolerance = 0.2mm]
Impedance Constraint [Min = 85.00 Max = 95.00 ]

1K | T_PWR_EN

GND

Placed in same alignement than Extension Connectors at a distance
multiple of 2.54 mm

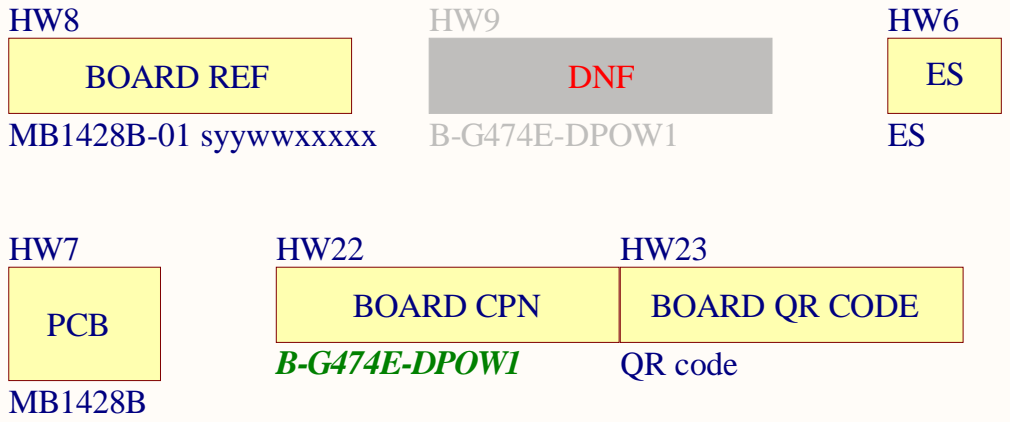
[picture p17: page 11]
