xiaokaizip/foc/circuit/odrive v3.6_56VÔ­ÀíÍ¼PCB.PDF

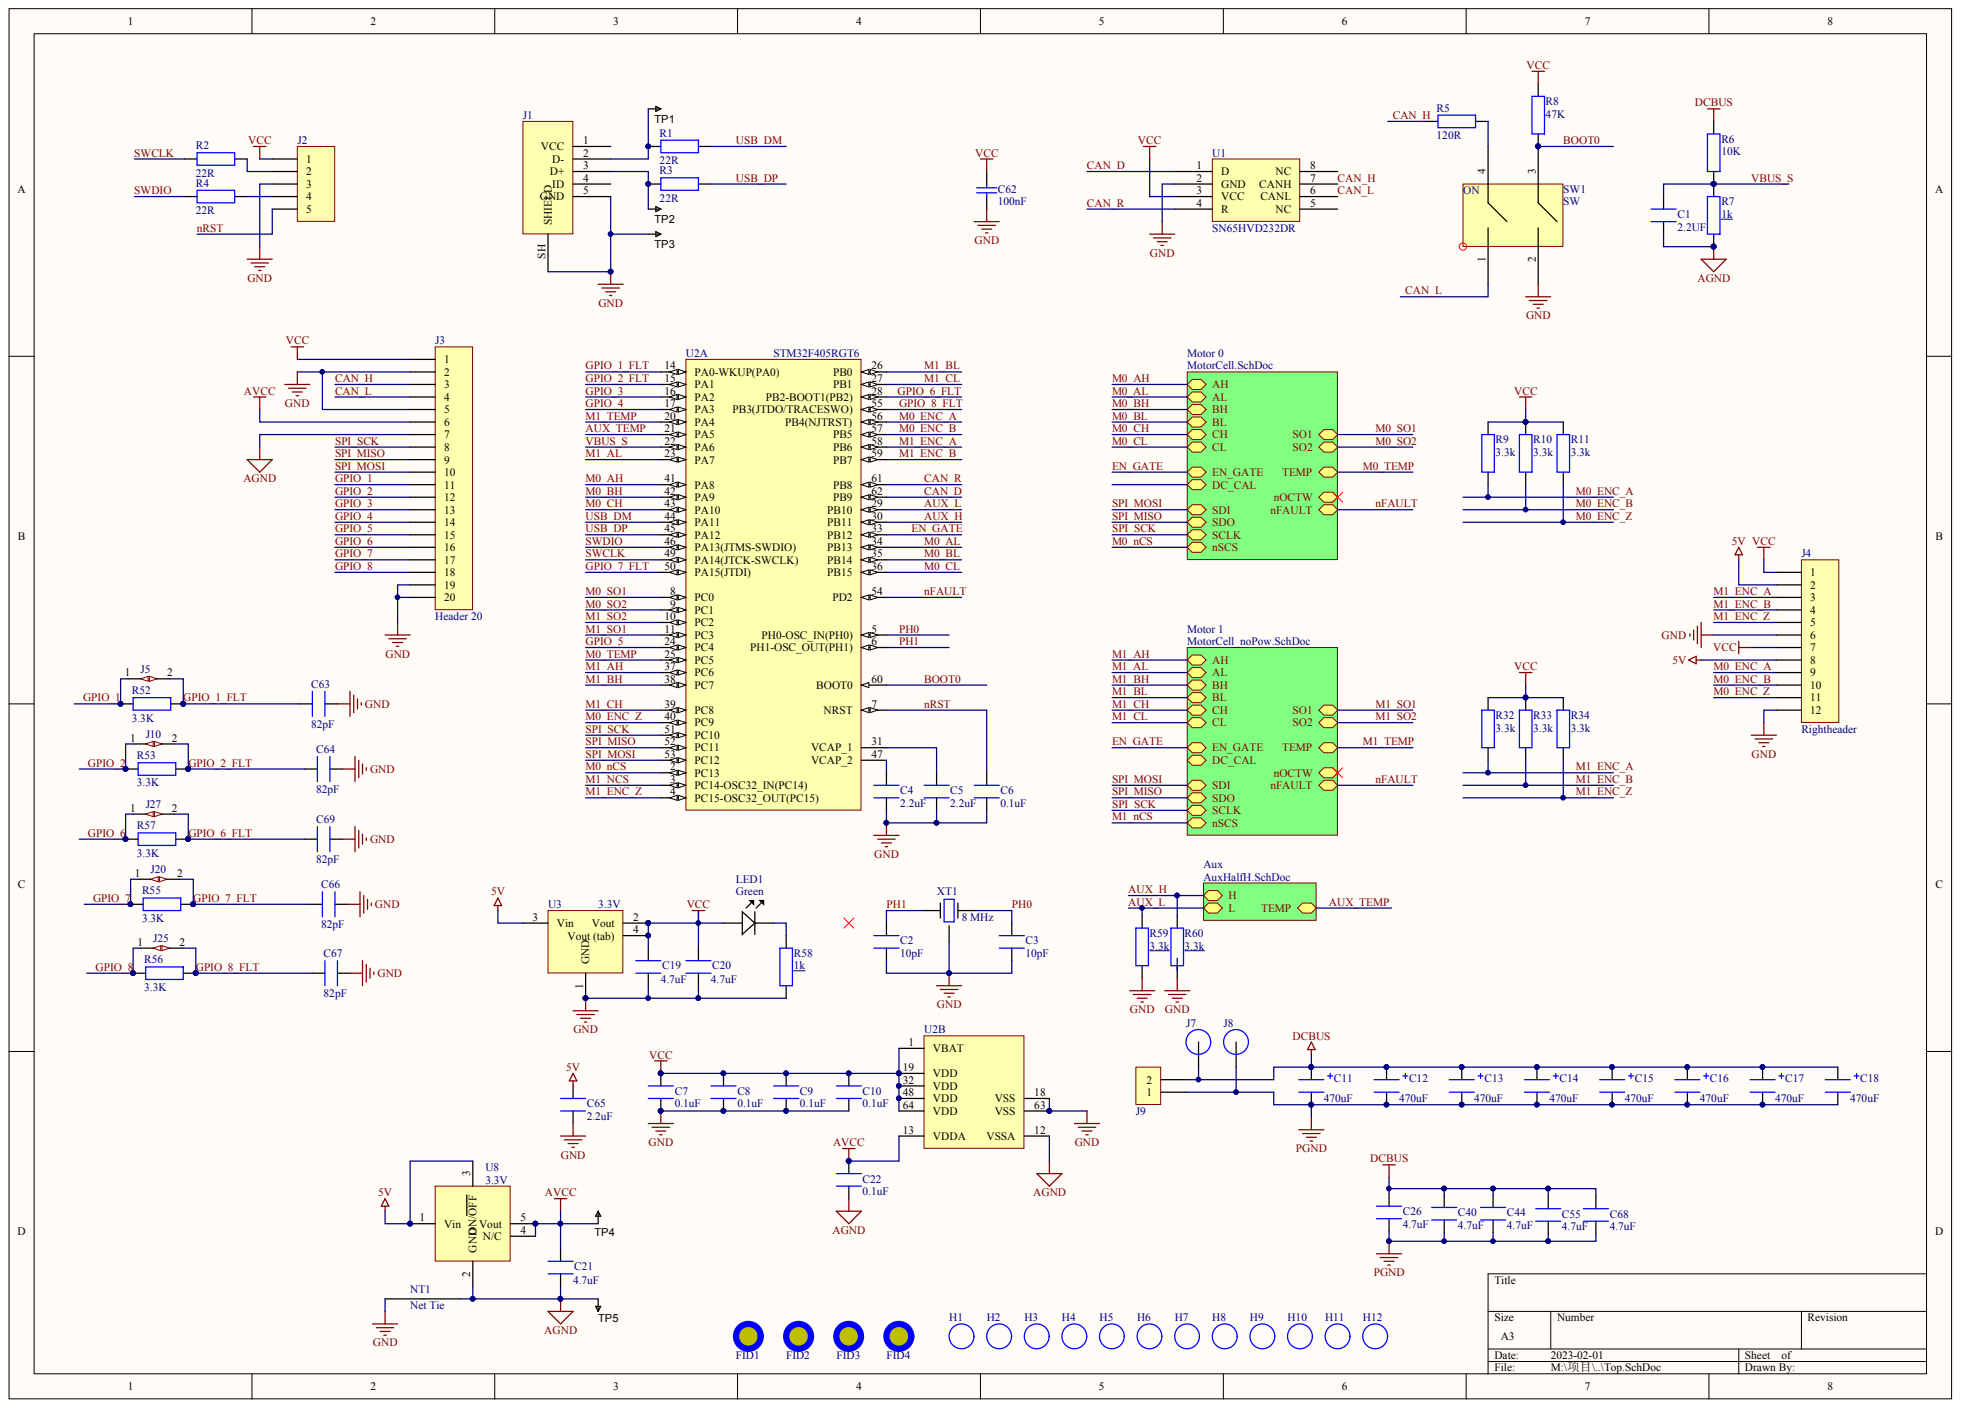
[picture p18: page 1]

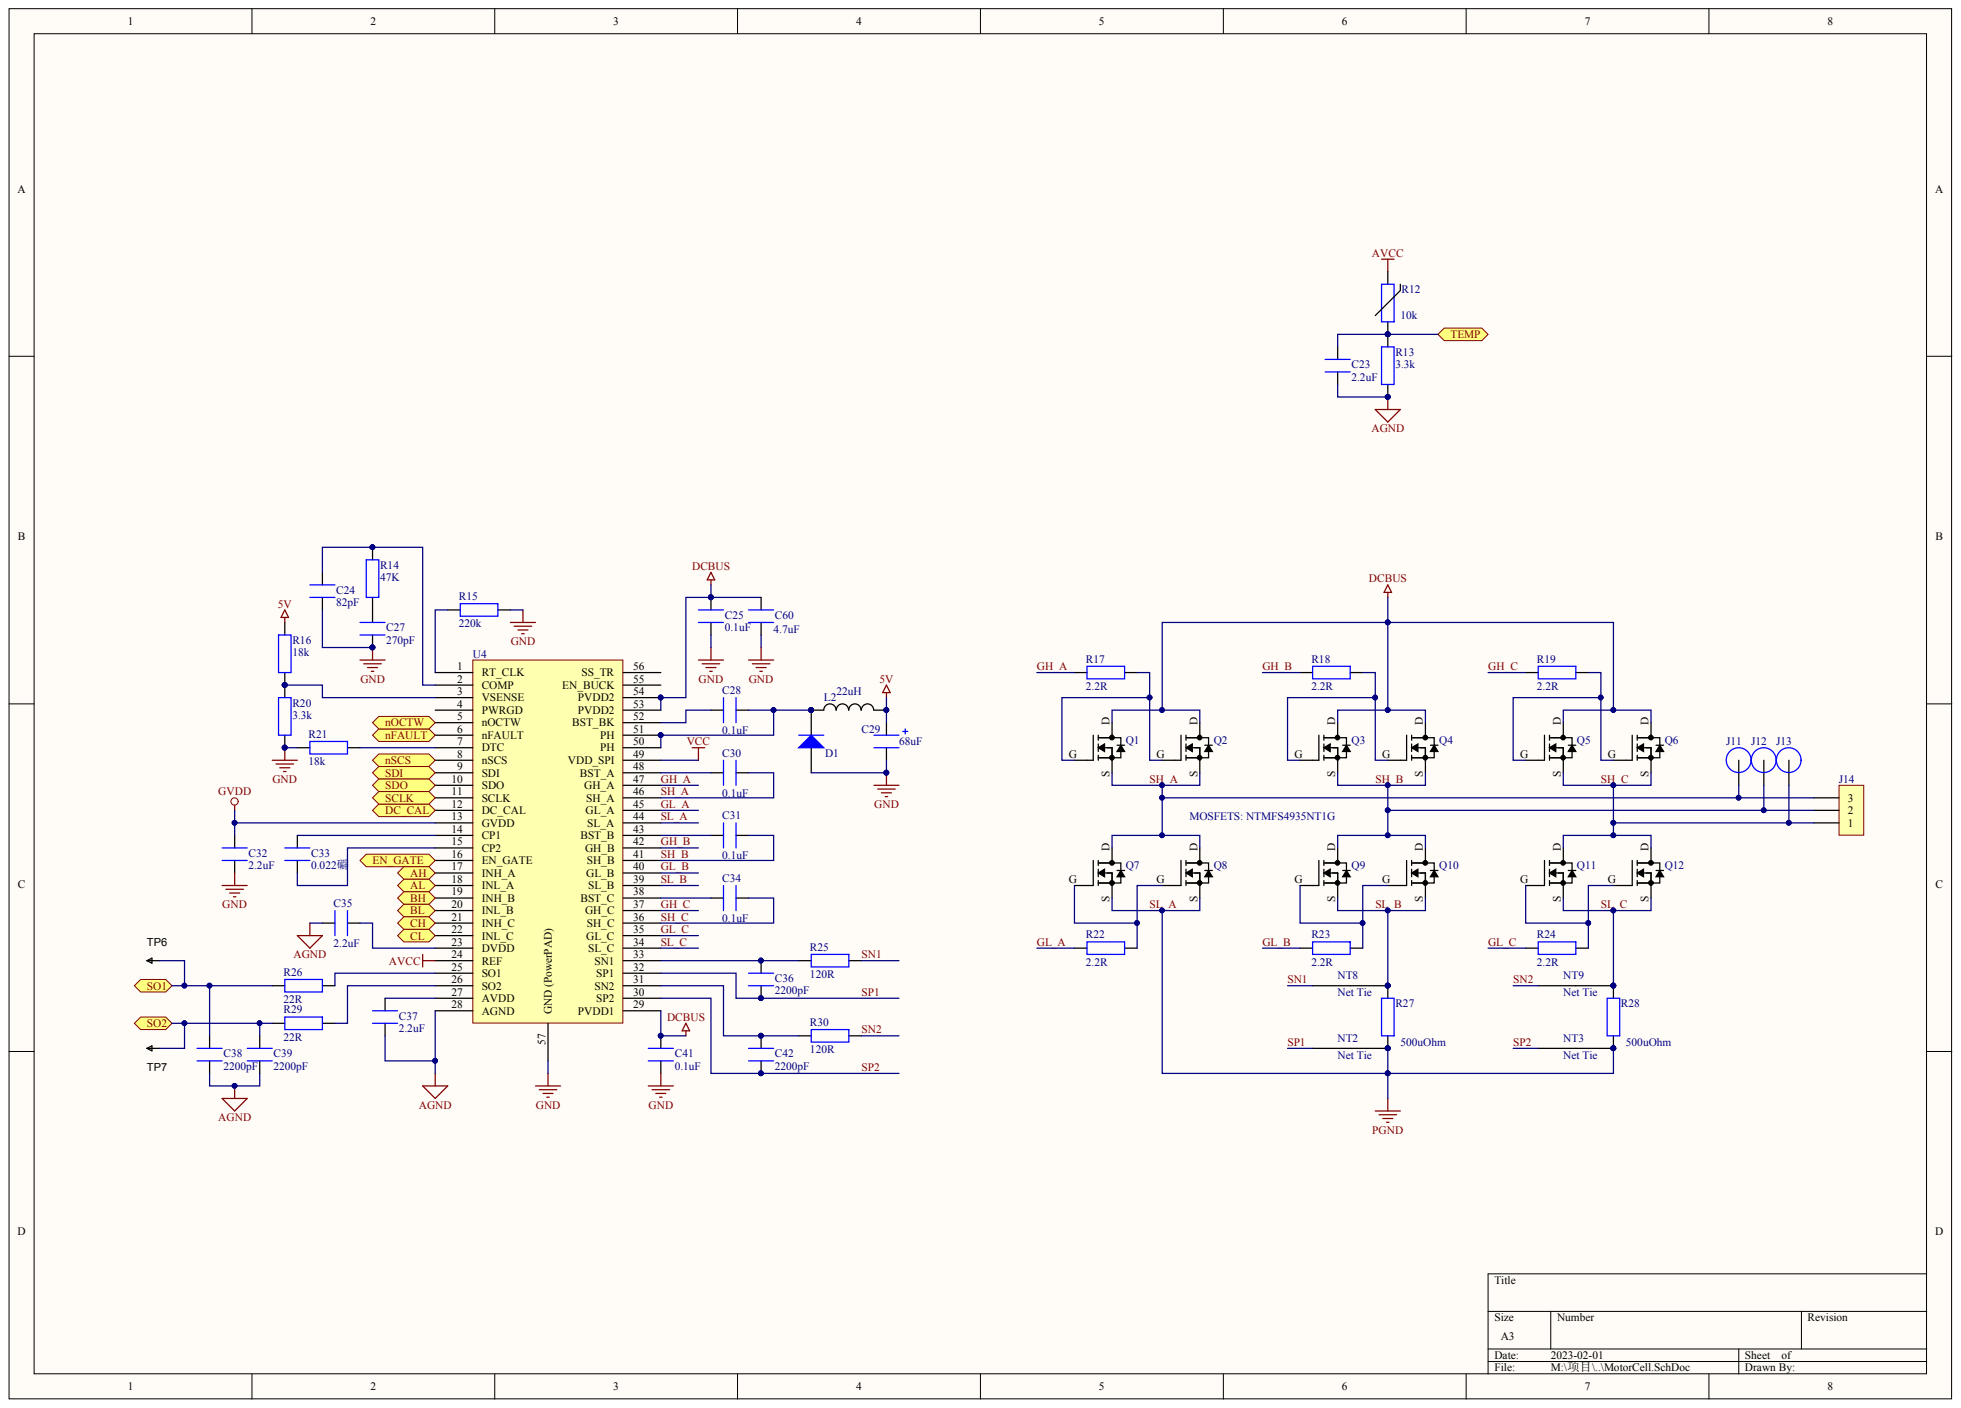
[picture p19: page 2]

C33 EN_GAT E 0.022 礔 AH | | | SH_B

INH_A 17 | GL_B
INL_A 18 | SL_B

C37 | | R30
2.2uF

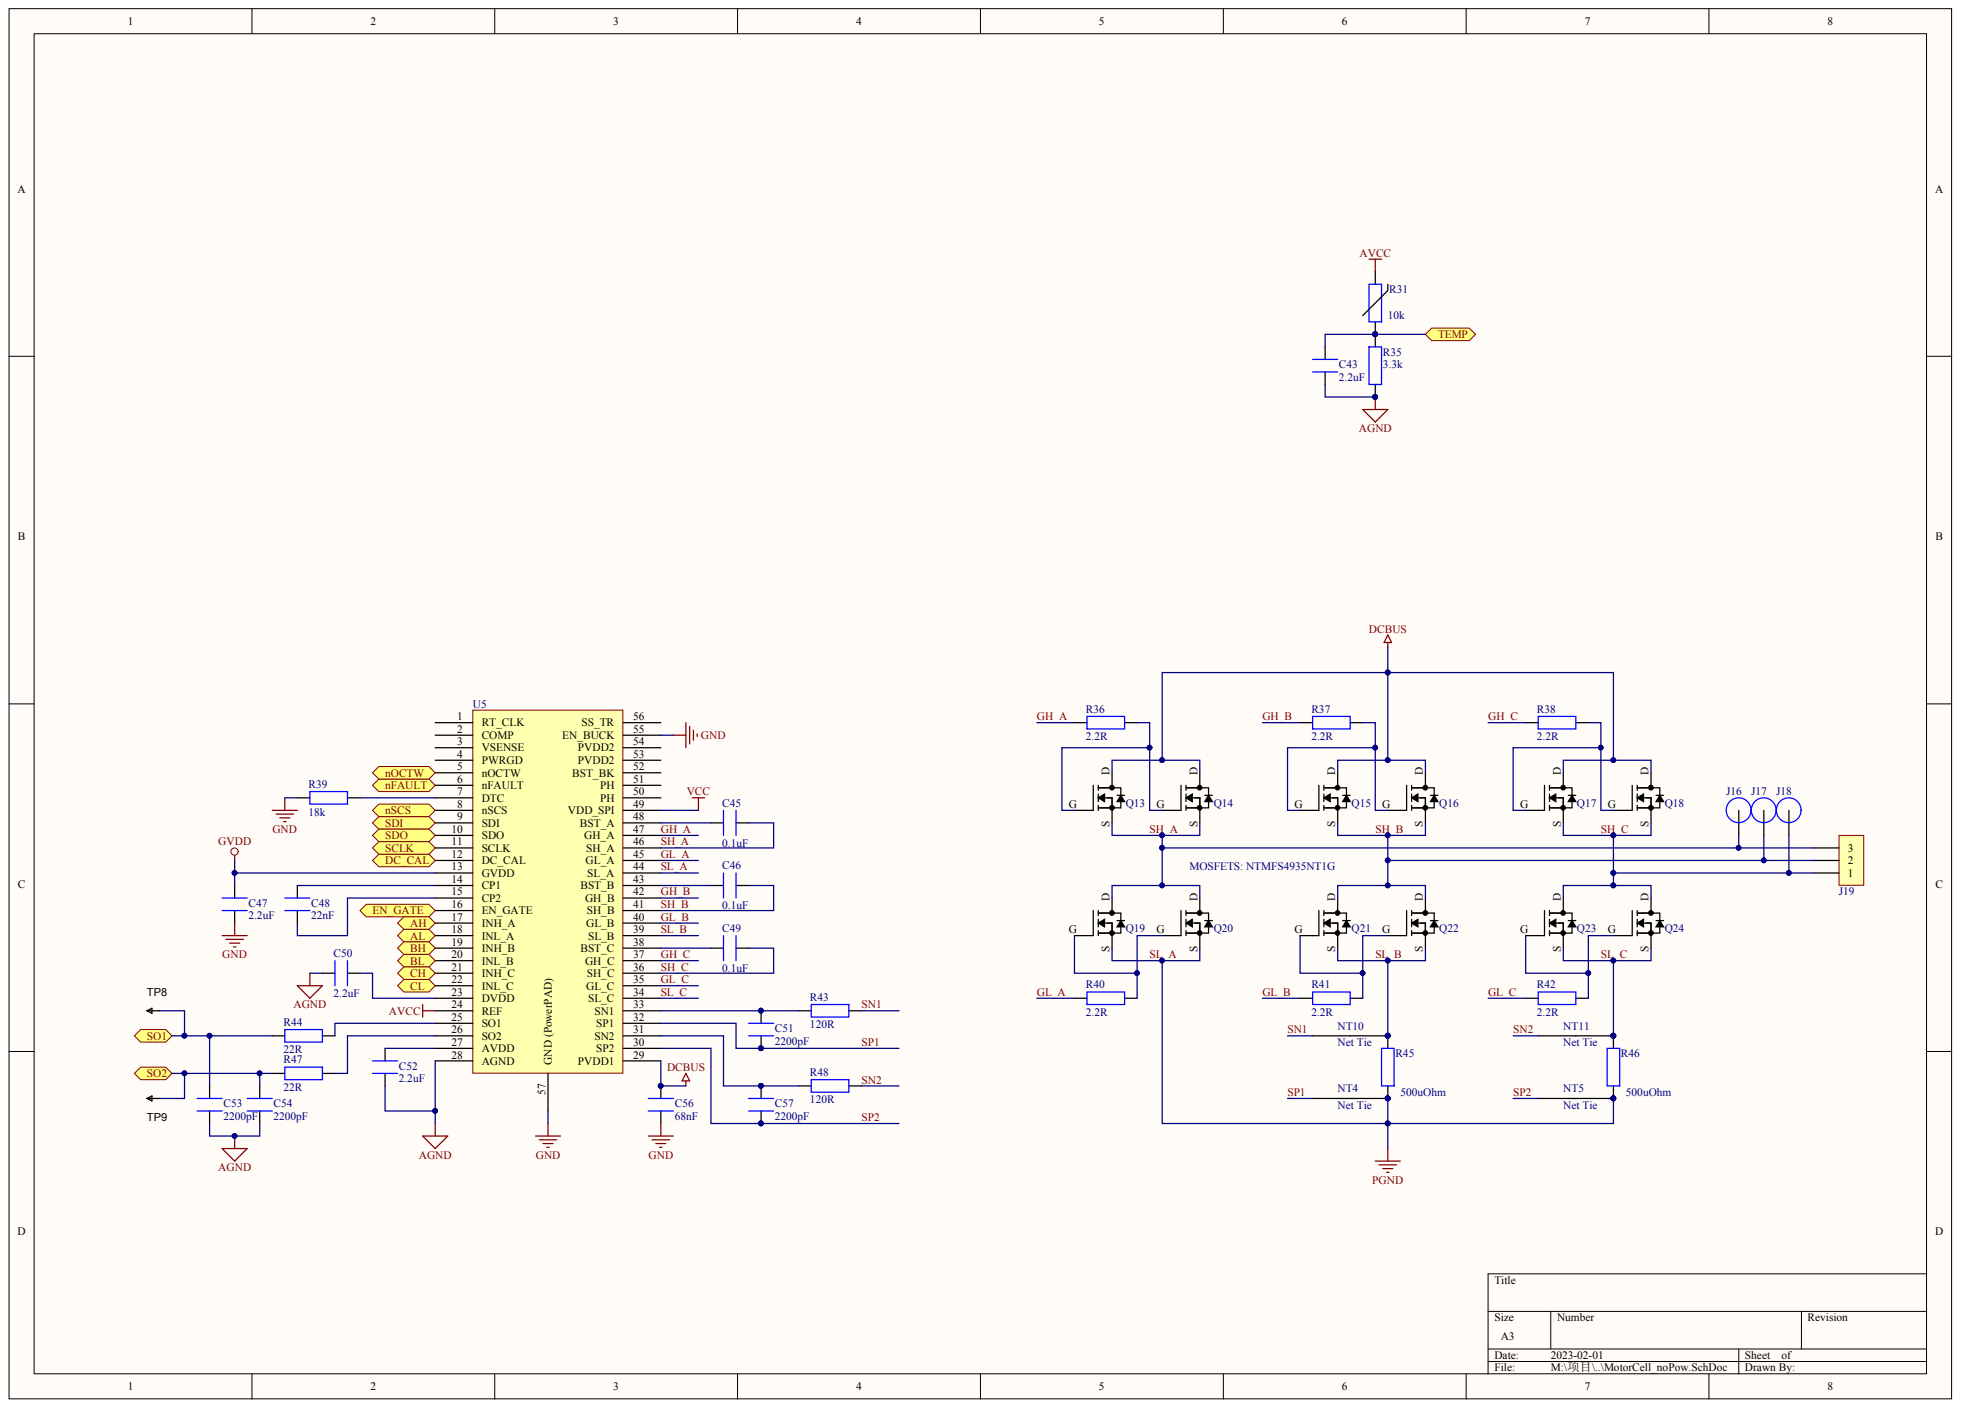
[picture p20: page 3]

GVDD 13 | SL_A
CP1 14
CP2 15 | | GH_B | 0.1uF

C48 EN_GATE 22nF AH | | EN_GATE 16 | | SH_B

INH_A 17 | GL_B
INL_A 18 | SL_B

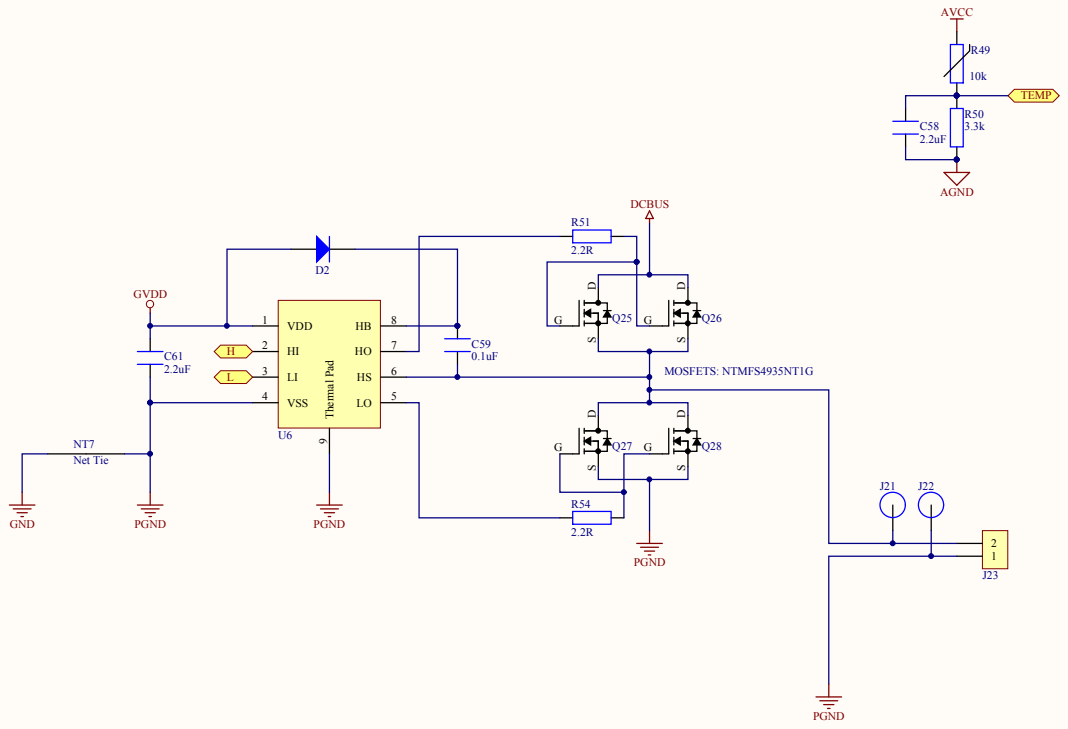
[picture p21: page 4]

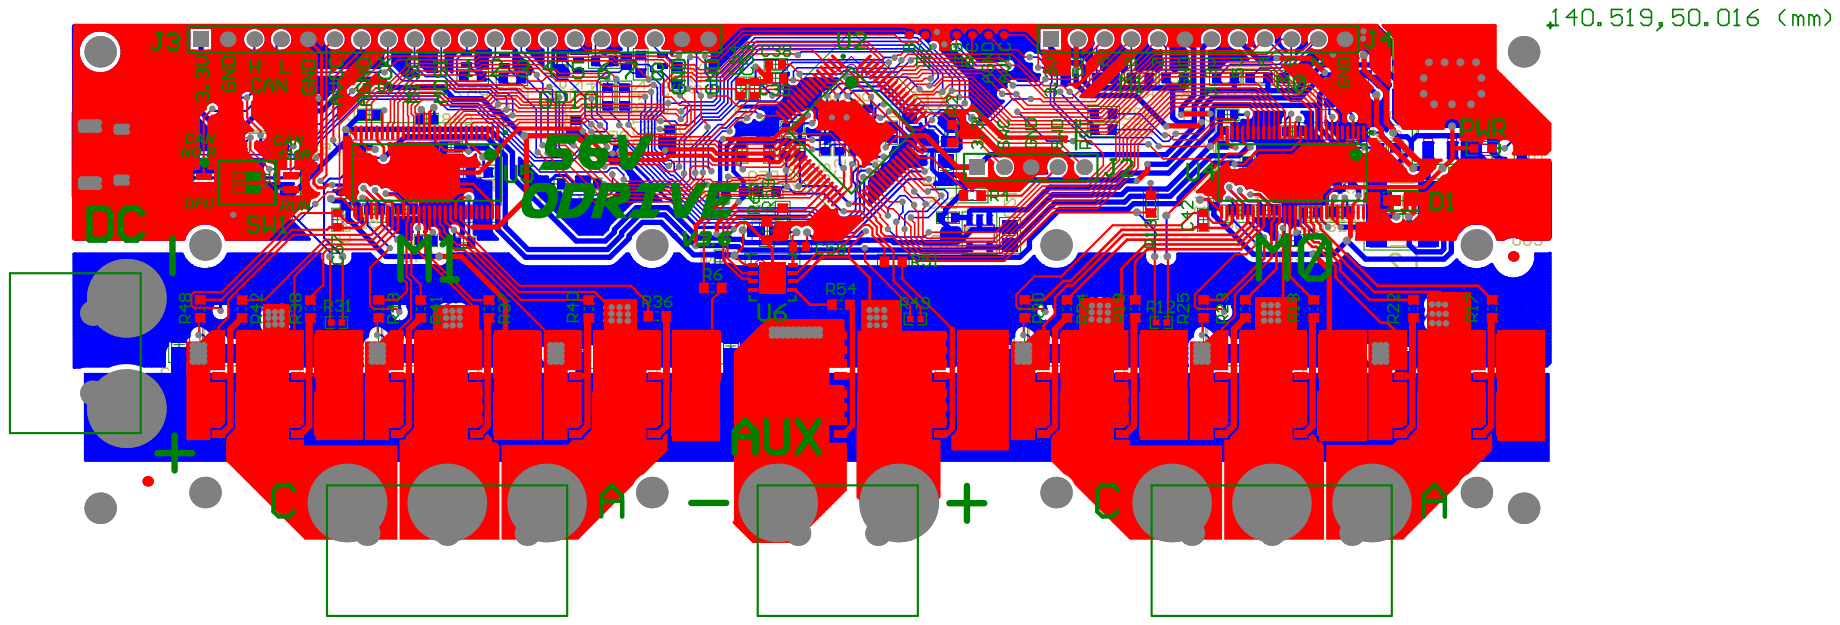
[picture p22: page 5]
