xiaokaizip/foc/(list of files, drawings)

Other design files:
circuit/candence/DESIGN1.DSN
circuit/candence/Design1.opj
circuit/candence/hpm/HPM_ECAT_FOC.DSN
circuit/candence/hpm/hpm_ecat_foc.opj
circuit/candence/POWER.DSN
circuit/candence/POWER.opj
circuit/candence/stm32/STSPIN32G4_FOC.DSN
circuit/candence/stm32/STSPIN32G4_foc.opj
