xiaokaizip/foc/circuit/kicad/ft2232/ft2232.kicad_sch

## KiCad design circuit/kicad/ft2232/ft2232.kicad_sch (2026-01-14)

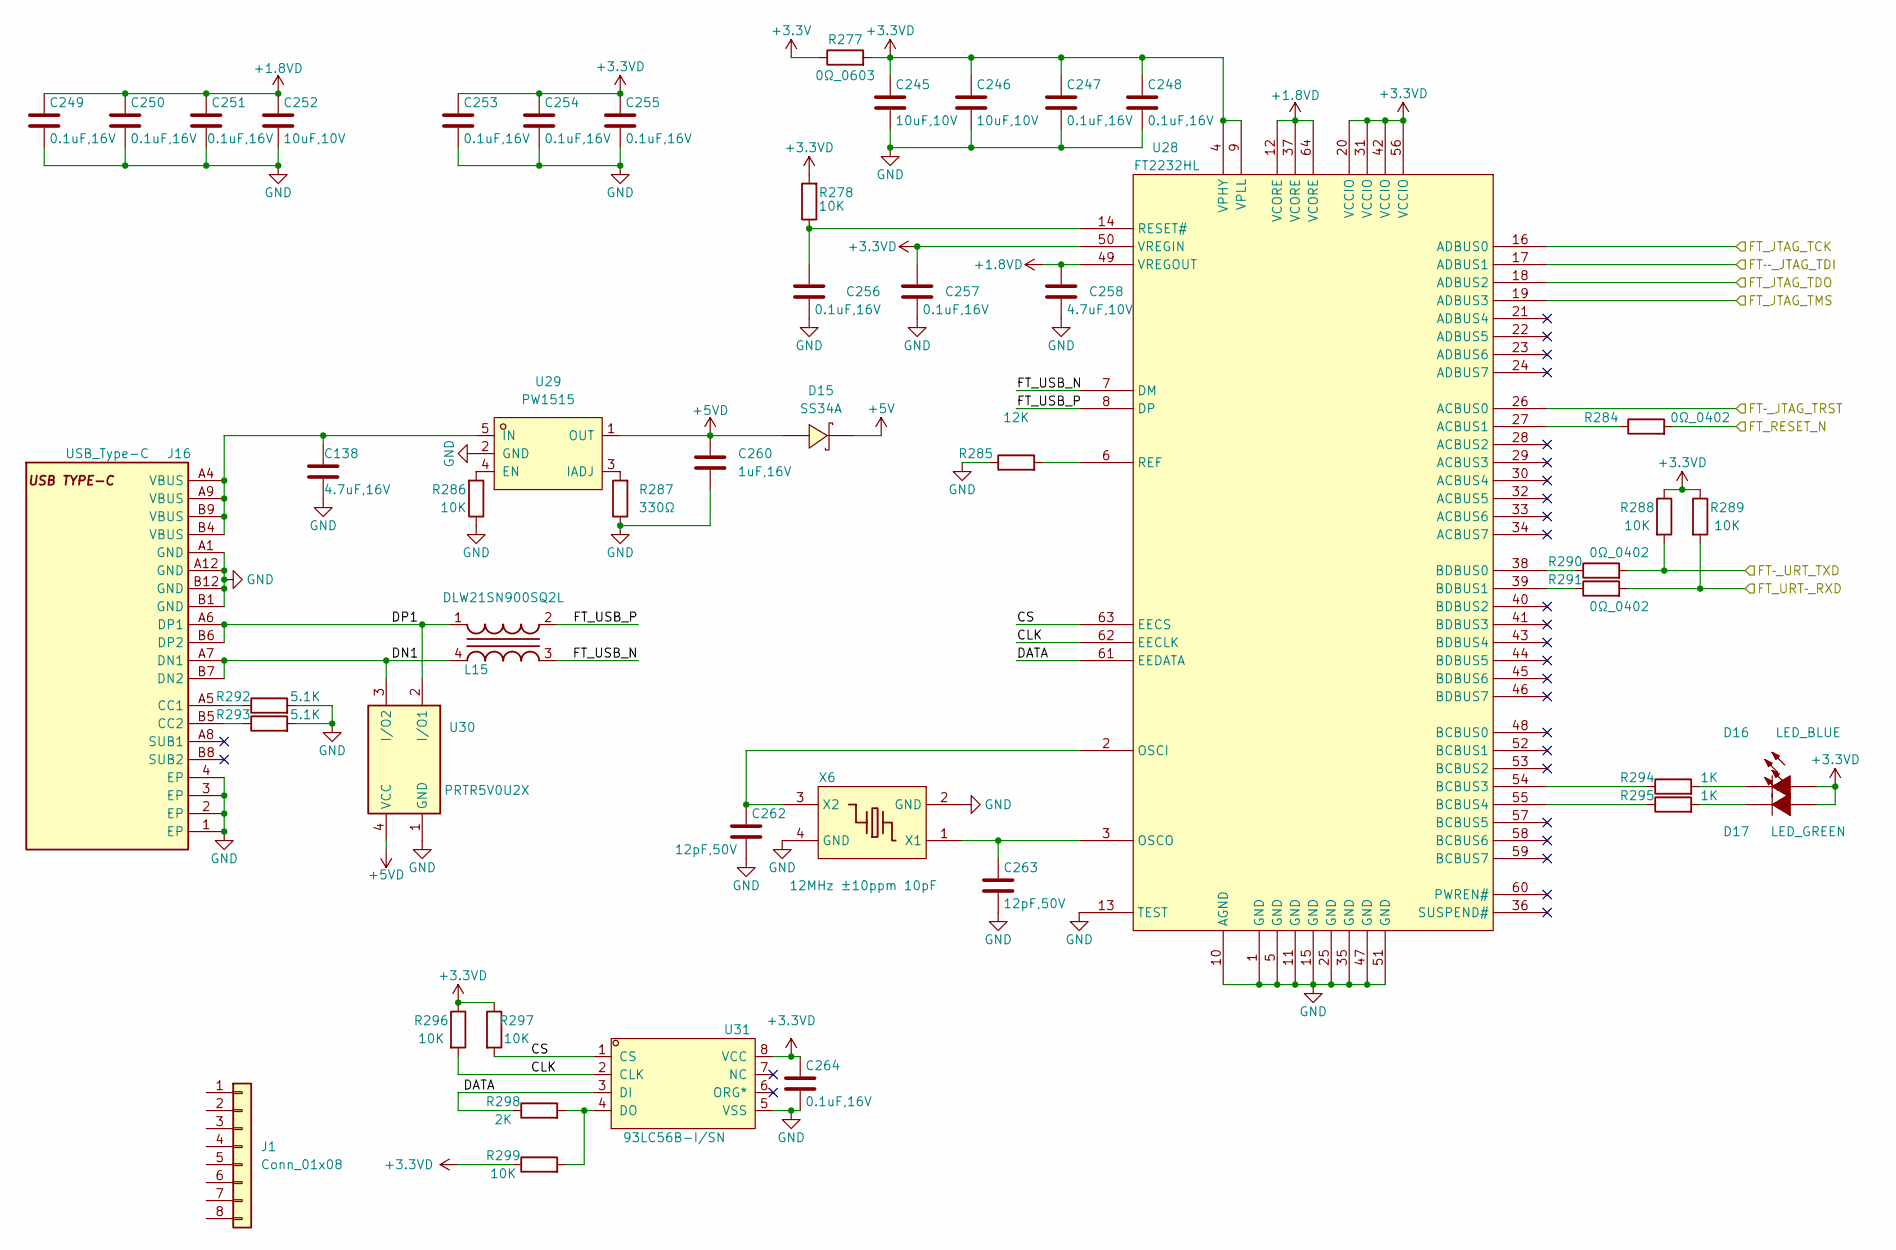
[picture p23: schematic ft2232.kicad_sch]

Parts:
C138: 4.7uF,16V; C_0603_1608Metric
C245, C246, C252: 10uF,10V; C_0402_1005Metric
C247, C248, C249, C250, C251, C253, C254, C255, C256, C257, C264: 0.1uF,16V; C_0402_1005Metric
C258: 4.7uF,10V; C_0402_1005Metric
C260: 1uF,16V; C_0402_1005Metric
C262, C263: 12pF,50V; C_0402_1005Metric
D15: SS34A; D_SMA
D16: LED_BLUE; LED_0603
D17: LED_GREEN; LED_0603
J1: Conn_01x08
J16: USB_Type-C; TYPE-C-16P
L15: DLW21SN900SQ2L; L2012
R277: 0Ω_0603; R_0603_1608Metric
R278, R286, R288, R289, R296, R297, R299: 10K; R_0402_1005Metric
R284, R290, R291: 0Ω_0402; R_0402_1005Metric
R285: 12K; R_0402_1005Metric
R287: 330Ω; R_0402_1005Metric
R292, R293: 5.1K; R_0402_1005Metric
R294, R295: 1K; R_0402_1005Metric
R298: 2K; R_0402_1005Metric
U28: FT2232HL; LQFP-64
U29: PW1515; SOT-23-5
U30: PRTR5V0U2X; SOT-143
U31: 93LC56B-I/SN; SOIC-8
X6: 12MHz ±10ppm 10pF; 3225

Connections:
+1.8VD: C249.1, C250.1, C251.1, C252.1, C258.1, U28.12 (VCORE), U28.37 (VCORE), U28.49 (VREGOUT), U28.64 (VCORE)
+3.3V: R277.1
+3.3VD: C245.1, C246.1, C247.1, C248.1, C253.1, C254.1, C255.1, C257.1, C264.1, D16.2 (A), D17.2 (A), R277.2, R278.2, R288.1, R289.1, R296.1, R297.1, R299.1, U28.4 (VPHY), U28.9 (VPLL), U28.20 (VCCIO), U28.31 (VCCIO), U28.42 (VCCIO), U28.50 (VREGIN), U28.56 (VCCIO), U31.8 (VCC)
+5V: D15.1 (K)
+5VD: C260.1, D15.2 (A), U29.1 (OUT), U30.4 (VCC)
CLK: R296.2, U28.62 (EECLK), U31.2 (CLK)
CS: R297.2, U28.63 (EECS), U31.1 (CS)
DATA: R298.1, U28.61 (EEDATA), U31.3 (DI)
DN1: J16.A7 (DN1), J16.B7 (DN2), L15.4, U30.3 (I/O2)
DP1: J16.A6 (DP1), J16.B6 (DP2), L15.1, U30.2 (I/O1)
FT_JTAG_TCK: U28.16 (ADBUS0)
FT_JTAG_TDO: U28.18 (ADBUS2)
FT_JTAG_TMS: U28.19 (ADBUS3)
FT_RESET_N: R284.2
FT_URT­_RXD: R289.2, R291.2
FT_USB_N: L15.3, U28.7 (DM)
FT_USB_P: L15.2, U28.8 (DP)
FT­_JTAG_TRST: U28.26 (ACBUS0)
FT­_URT_TXD: R288.2, R290.2
FT­­_JTAG_TDI: U28.17 (ADBUS1)
GND: C138.2, C245.2, C246.2, C247.2, C248.2, C249.2, C250.2, C251.2, C252.2, C253.2, C254.2, C255.2, C256.2, C257.2, C258.2, C260.2, C262.2, C263.2, C264.2, J16.1 (EP), J16.2 (EP), J16.3 (EP), J16.4 (EP), J16.A1 (GND), J16.A12 (GND), J16.B1 (GND), J16.B12 (GND), R285.1, R286.1, R287.1, R292.2, R293.2, U28.1 (GND), U28.5 (GND), U28.10 (AGND), U28.11 (GND), U28.13 (TEST), U28.15 (GND), U28.25 (GND), U28.35 (GND), U28.47 (GND), U28.51 (GND), U29.2 (GND), U30.1 (GND), U31.5 (VSS), X6.2 (GND), X6.4 (GND)
unnamed: C138.1, J16.A4 (VBUS), J16.A9 (VBUS), J16.B4 (VBUS), J16.B9 (VBUS), U29.5 (IN)
unnamed: C256.1, R278.1, U28.14 (RESET#)
unnamed: C262.1, U28.2 (OSCI), X6.3 (X2)
unnamed: C263.1, U28.3 (OSCO), X6.1 (X1)
unnamed: D16.1 (K), R294.2
unnamed: D17.1 (K), R295.2
unnamed: J16.A5 (CC1), R292.1
unnamed: J16.B5 (CC2), R293.1
unnamed: R284.1, U28.27 (ACBUS1)
unnamed: R285.2, U28.6 (REF)
unnamed: R286.2, U29.4 (EN)
unnamed: R287.2, U29.3 (IADJ)
unnamed: R290.1, U28.38 (BDBUS0)
unnamed: R291.1, U28.39 (BDBUS1)
unnamed: R294.1, U28.54 (BCBUS3)
unnamed: R295.1, U28.55 (BCBUS4)
unnamed: R298.2, R299.2, U31.4 (DO)
