xiaokaizip/foc/circuit/kicad/hpm_ecat_foc/ETHERCAT_A.kicad_sch

## KiCad design circuit/kicad/hpm_ecat_foc/ETHERCAT_A.kicad_sch (2026-01-14)

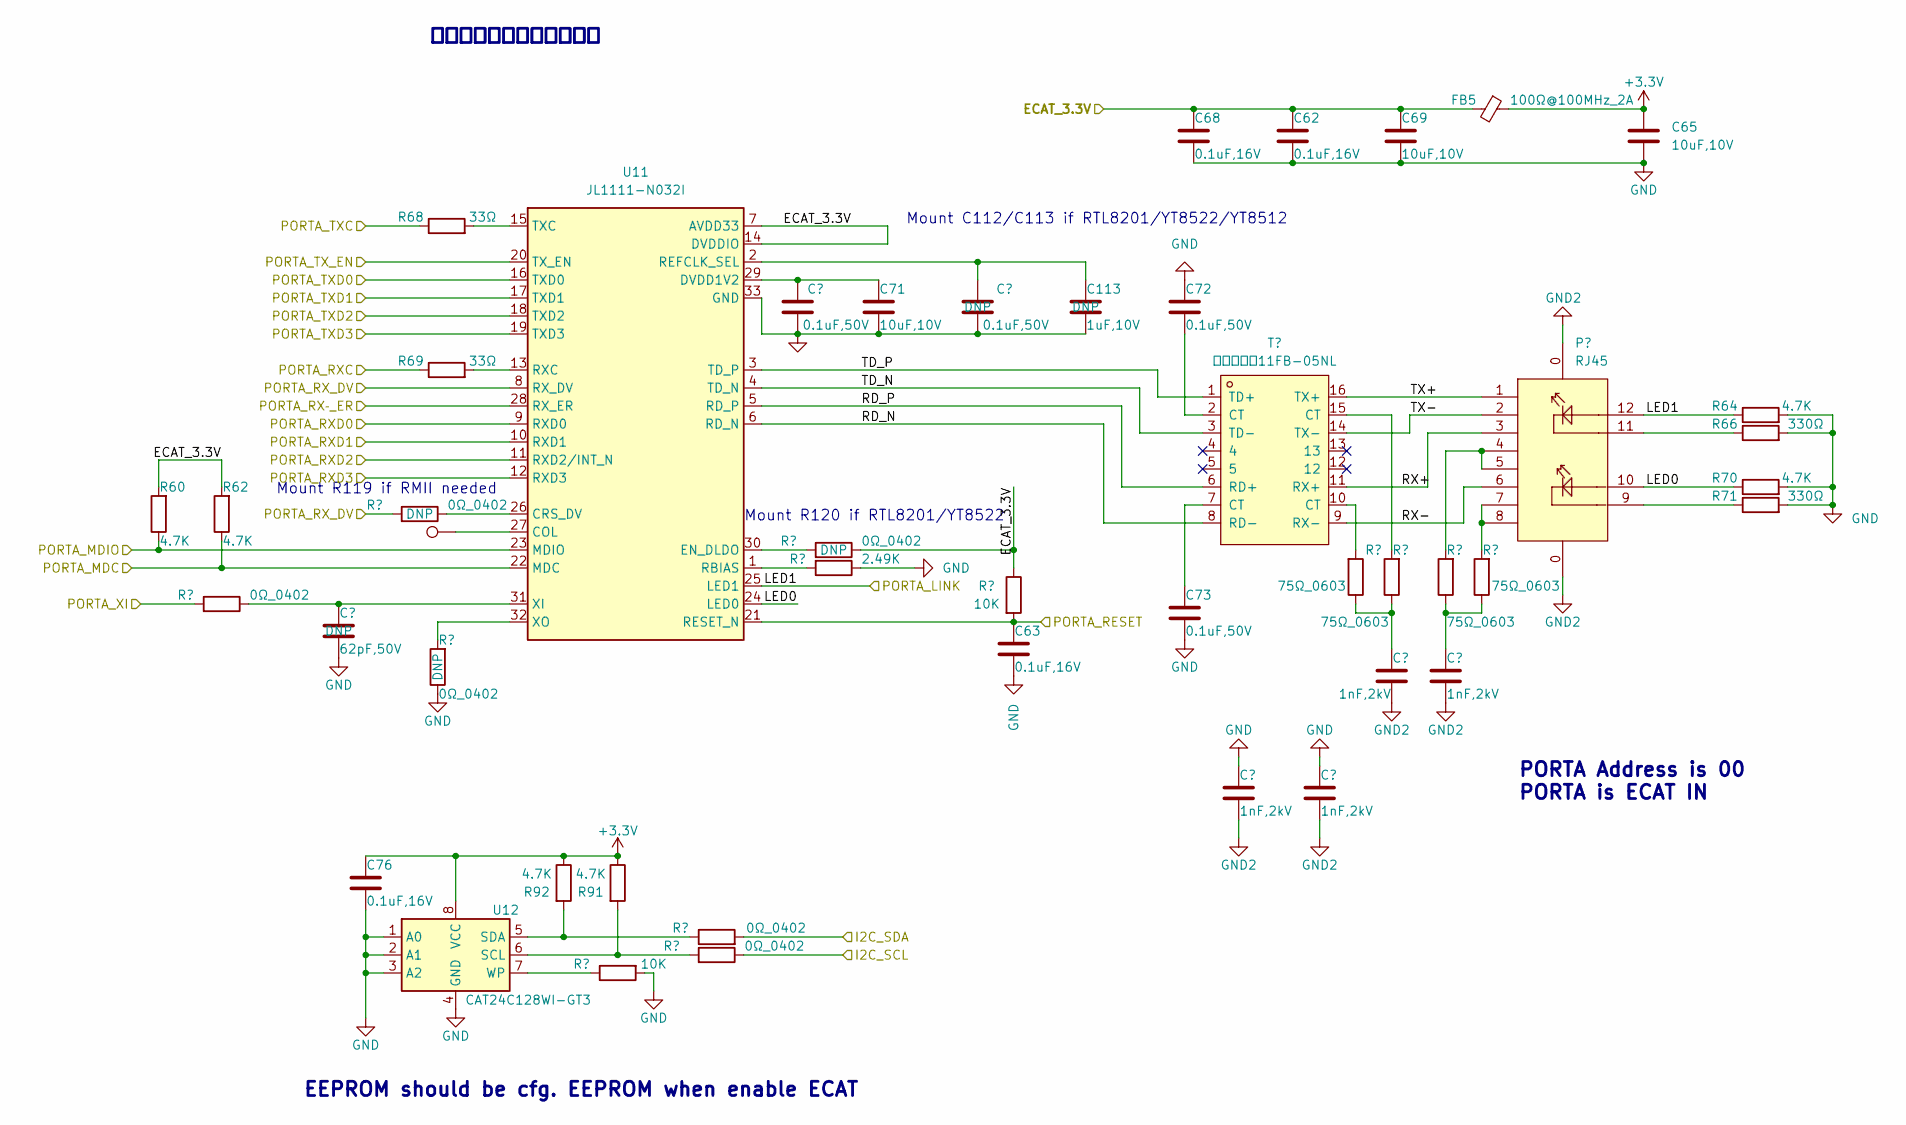
[picture p24: schematic ETHERCAT_A.kicad_sch]

Parts:
C62, C63, C68, C76: 0.1uF,16V; C_0402_1005Metric
C65, C69, C71: 10uF,10V; R_0603_1608Metric
C70, C72, C73, C112: 0.1uF,50V; C_0402_1005Metric
C74, C75, C77, C78: 1nF,2kV; C_1206_3216Metric
C79: 62pF,50V; C_0402_1005Metric
C113: 1uF,10V; C_0402_1005Metric
FB5: 100Ω@100MHz_2A; R_0603_1608Metric
P1: RJ45; RJ45-TH_B-1-1_led-update
R40, R82, R86, R87, R119, R120: 0Ω_0402; R_0402_1005Metric
R60, R62, R64, R70, R91, R92: 4.7K; R_0402_1005Metric
R66, R71: 330Ω; R_0402_1005Metric
R68, R69: 33Ω; R_0402_1005Metric
R76: 2.49K; R_0402_1005Metric
R77, R78, R79, R80: 75Ω_0603; R_0603_1608Metric
R81, R84: 10K; R_0402_1005Metric
T1: 网口变压器11FB-05NL; H1102_XFMR16_SM
T29: 0.5mm; TestPoint_Pad_D0.5mm
U11: JL1111-N032I; QFN-32-1EP_5x5mm_P0.5mm_EP3.1x3.1mm
U12: CAT24C128WI-GT3; SOP-8_3.9x4.9mm_P1.27mm

Connections:
+3.3V: C65.1, C76.1, FB5.1, R91.1, R92.1, U12.8 (VCC)
ECAT_3.3V: C62.1, C68.1, C69.1, FB5.2, R60.2, R62.2, R81.1, R120.1, U11.7 (AVDD33), U11.14 (DVDDIO)
GND: C62.2, C63.2, C65.2, C68.2, C69.2, C70.1, C71.2, C72.1, C73.2, C76.2, C77.1, C78.1, C79.2, C112.1, C113.2, R64.2, R66.2, R70.2, R71.2, R76.1, R82.1, R84.2, U11.33 (GND), U12.1 (A0), U12.2 (A1), U12.3 (A2), U12.4 (GND)
GND2: C74.2, C75.2, C77.2, C78.2, P1.0 (S)
I2C_SCL: R86.1
I2C_SDA: R87.2
LED0: P1.10, R70.1, U11.24 (LED0)
LED1: P1.12, R64.1, U11.25 (LED1)
unnamed: C70.2, C71.1, U11.29 (DVDD1V2)
unnamed: C72.2, T1.2 (CT)
unnamed: C73.1, T1.7 (CT)
unnamed: C74.1, R77.1, R78.1
unnamed: C75.1, R79.1, R80.1
unnamed: C79.1, R40.1, U11.31 (XI)
unnamed: C112.2, C113.1, U11.2 (REFCLK_SEL)
unnamed: P1.4, P1.5, R79.2
unnamed: P1.7, P1.8, R80.2
unnamed: P1.9, R71.1
unnamed: P1.11, R66.1
unnamed: R68.2, U11.15 (TXC)
unnamed: R69.2, U11.13 (RXC)
unnamed: R76.2, U11.1 (RBIAS)
unnamed: R77.2, T1.10 (CT)
unnamed: R78.2, T1.15 (CT)
unnamed: R82.2, U11.32 (XO)
unnamed: R84.1, U12.7 (WP)
unnamed: R86.2, R91.2, U12.6 (SCL)
unnamed: R87.1, R92.2, U12.5 (SDA)
unnamed: R119.1, U11.26 (CRS_DV)
unnamed: R120.2, U11.30 (EN_DLDO)
unnamed: T29.1, U11.27 (COL)
PORTA_MDC: R62.1, U11.22 (MDC)
PORTA_MDIO: R60.1, U11.23 (MDIO)
PORTA_RESET: C63.1, R81.2, U11.21 (RESET_N)
PORTA_RXC: R69.1
PORTA_RXD0: U11.9 (RXD0)
PORTA_RXD1: U11.10 (RXD1)
PORTA_RXD2: U11.11 (RXD2/INT_N)
PORTA_RXD3: U11.12 (RXD3)
PORTA_RX_DV: R119.2, U11.8 (RX_DV)
PORTA_RX­_ER: U11.28 (RX_ER)
PORTA_TXC: R68.1
PORTA_TXD0: U11.16 (TXD0)
PORTA_TXD1: U11.17 (TXD1)
PORTA_TXD2: U11.18 (TXD2)
PORTA_TXD3: U11.19 (TXD3)
PORTA_TX_EN: U11.20 (TX_EN)
PORTA_XI: R40.2
RD_N: T1.8 (RD-), U11.6 (RD_N)
RD_P: T1.6 (RD+), U11.5 (RD_P)
RX+: P1.3, T1.11 (RX+)
RX-: P1.6, T1.9 (RX-)
TD_N: T1.3 (TD-), U11.4 (TD_N)
TD_P: T1.1 (TD+), U11.3 (TD_P)
TX+: P1.1, T1.16 (TX+)
TX-: P1.2, T1.14 (TX-)

Notes on the sheet:
Mount R120 if RTL8201/YT8522
EEPROM should be cfg. EEPROM when enable ECAT
Mount C112/C113 if RTL8201/YT8522/YT8512
建议客户使用景略上述料号
Mount R119 if RMII needed
PORTA Address is 00 PORTA is ECAT IN
