xiaokaizip/foc/circuit/kicad/hpm_ecat_foc/ETHERCAT_B.kicad_sch

## KiCad design circuit/kicad/hpm_ecat_foc/ETHERCAT_B.kicad_sch (2026-01-14)

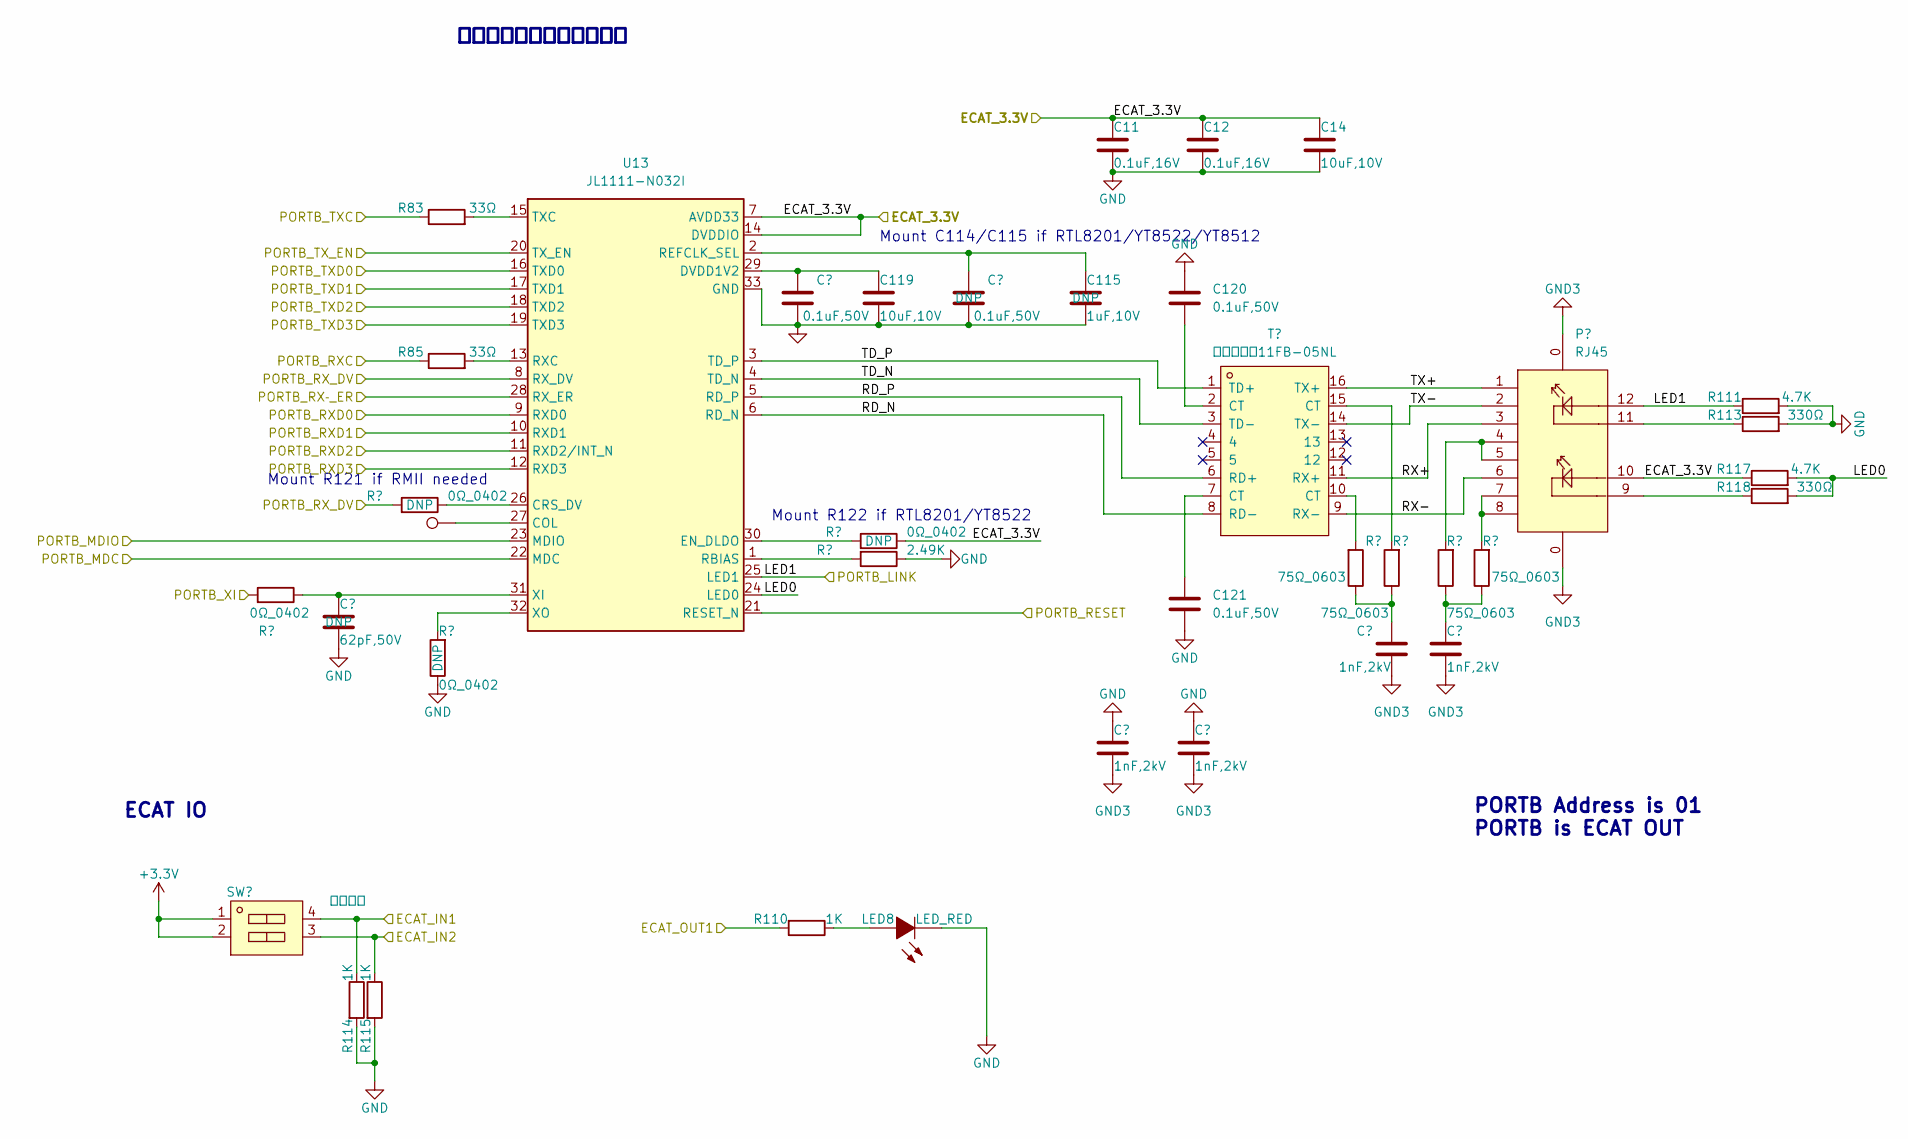
[picture p25: schematic ETHERCAT_B.kicad_sch]

Parts:
C11, C12: 0.1uF,16V; C_0402_1005Metric
C14, C119: 10uF,10V; R_0603_1608Metric
C80: 62pF,50V; C_0402_1005Metric
C114, C118, C120, C121: 0.1uF,50V; C_0402_1005Metric
C115: 1uF,10V; C_0402_1005Metric
C122, C123, C125, C126: 1nF,2kV; C_1206_3216Metric
LED8: LED_RED; LED_0603
P2: RJ45; RJ45-TH_B-1-1_led-update
R41, R121, R122, R129: 0Ω_0402; R_0402_1005Metric
R83, R85: 33Ω; R_0402_1005Metric
R110, R114, R115: 1K; R_0402_1005Metric
R111, R117: 4.7K; R_0402_1005Metric
R113, R118: 330Ω; R_0402_1005Metric
R123: 2.49K; R_0402_1005Metric
R124, R125, R126, R127: 75Ω_0603; R_0603_1608Metric
SW6: 拨码开关; SW-SMD_DM-02-V
T2: 网口变压器11FB-05NL; H1102_XFMR16_SM
T30: 0.5mm; TestPoint_Pad_D0.5mm
U13: JL1111-N032I; QFN-32-1EP_5x5mm_P0.5mm_EP3.1x3.1mm

Connections:
+3.3V: SW6.1 (PIN1), SW6.2 (PIN2)
ECAT_3.3V: C11.1, C12.1, C14.1, P2.10, R117.1, R122.1, U13.7 (AVDD33), U13.14 (DVDDIO)
ECAT_IN1: R114.1, SW6.4 (PIN4)
ECAT_IN2: R115.1, SW6.3 (PIN3)
ECAT_OUT1: R110.2
GND: C11.2, C12.2, C14.2, C80.2, C114.1, C115.2, C118.1, C119.2, C120.1, C121.2, C125.1, C126.1, LED8.1 (K), R111.2, R113.2, R114.2, R115.2, R123.1, R129.1, U13.33 (GND)
GND3: C122.2, C123.2, C125.2, C126.2, P2.0 (S)
LED0: R117.2, R118.2, U13.24 (LED0)
LED1: P2.12, R111.1, U13.25 (LED1)
unnamed: C80.1, R41.1, U13.31 (XI)
unnamed: C114.2, C115.1, U13.2 (REFCLK_SEL)
unnamed: C118.2, C119.1, U13.29 (DVDD1V2)
unnamed: C120.2, T2.2 (CT)
unnamed: C121.1, T2.7 (CT)
unnamed: C122.1, R124.1, R125.1
unnamed: C123.1, R126.1, R127.1
unnamed: LED8.2 (A), R110.1
unnamed: P2.4, P2.5, R126.2
unnamed: P2.7, P2.8, R127.2
unnamed: P2.9, R118.1
unnamed: P2.11, R113.1
unnamed: R83.2, U13.15 (TXC)
unnamed: R85.2, U13.13 (RXC)
unnamed: R121.1, U13.26 (CRS_DV)
unnamed: R122.2, U13.30 (EN_DLDO)
unnamed: R123.2, U13.1 (RBIAS)
unnamed: R124.2, T2.10 (CT)
unnamed: R125.2, T2.15 (CT)
unnamed: R129.2, U13.32 (XO)
unnamed: T30.1, U13.27 (COL)
PORTB_MDC: U13.22 (MDC)
PORTB_MDIO: U13.23 (MDIO)
PORTB_RESET: U13.21 (RESET_N)
PORTB_RXC: R85.1
PORTB_RXD0: U13.9 (RXD0)
PORTB_RXD1: U13.10 (RXD1)
PORTB_RXD2: U13.11 (RXD2/INT_N)
PORTB_RXD3: U13.12 (RXD3)
PORTB_RX_DV: R121.2, U13.8 (RX_DV)
PORTB_RX­_ER: U13.28 (RX_ER)
PORTB_TXC: R83.1
PORTB_TXD0: U13.16 (TXD0)
PORTB_TXD1: U13.17 (TXD1)
PORTB_TXD2: U13.18 (TXD2)
PORTB_TXD3: U13.19 (TXD3)
PORTB_TX_EN: U13.20 (TX_EN)
PORTB_XI: R41.2
RD_N: T2.8 (RD-), U13.6 (RD_N)
RD_P: T2.6 (RD+), U13.5 (RD_P)
RX+: P2.3, T2.11 (RX+)
RX-: P2.6, T2.9 (RX-)
TD_N: T2.3 (TD-), U13.4 (TD_N)
TD_P: T2.1 (TD+), U13.3 (TD_P)
TX+: P2.1, T2.16 (TX+)
TX-: P2.2, T2.14 (TX-)

Notes on the sheet:
Mount R121 if RMII needed
建议客户使用景略上述料号
ECAT IO
Mount R122 if RTL8201/YT8522
Mount C114/C115 if RTL8201/YT8522/YT8512
PORTB Address is 01 PORTB is ECAT OUT
