xiaokaizip/foc/circuit/kicad/hpm_ecat_foc/ETH_RGMII.kicad_sch

## KiCad design circuit/kicad/hpm_ecat_foc/ETH_RGMII.kicad_sch (2026-01-14)

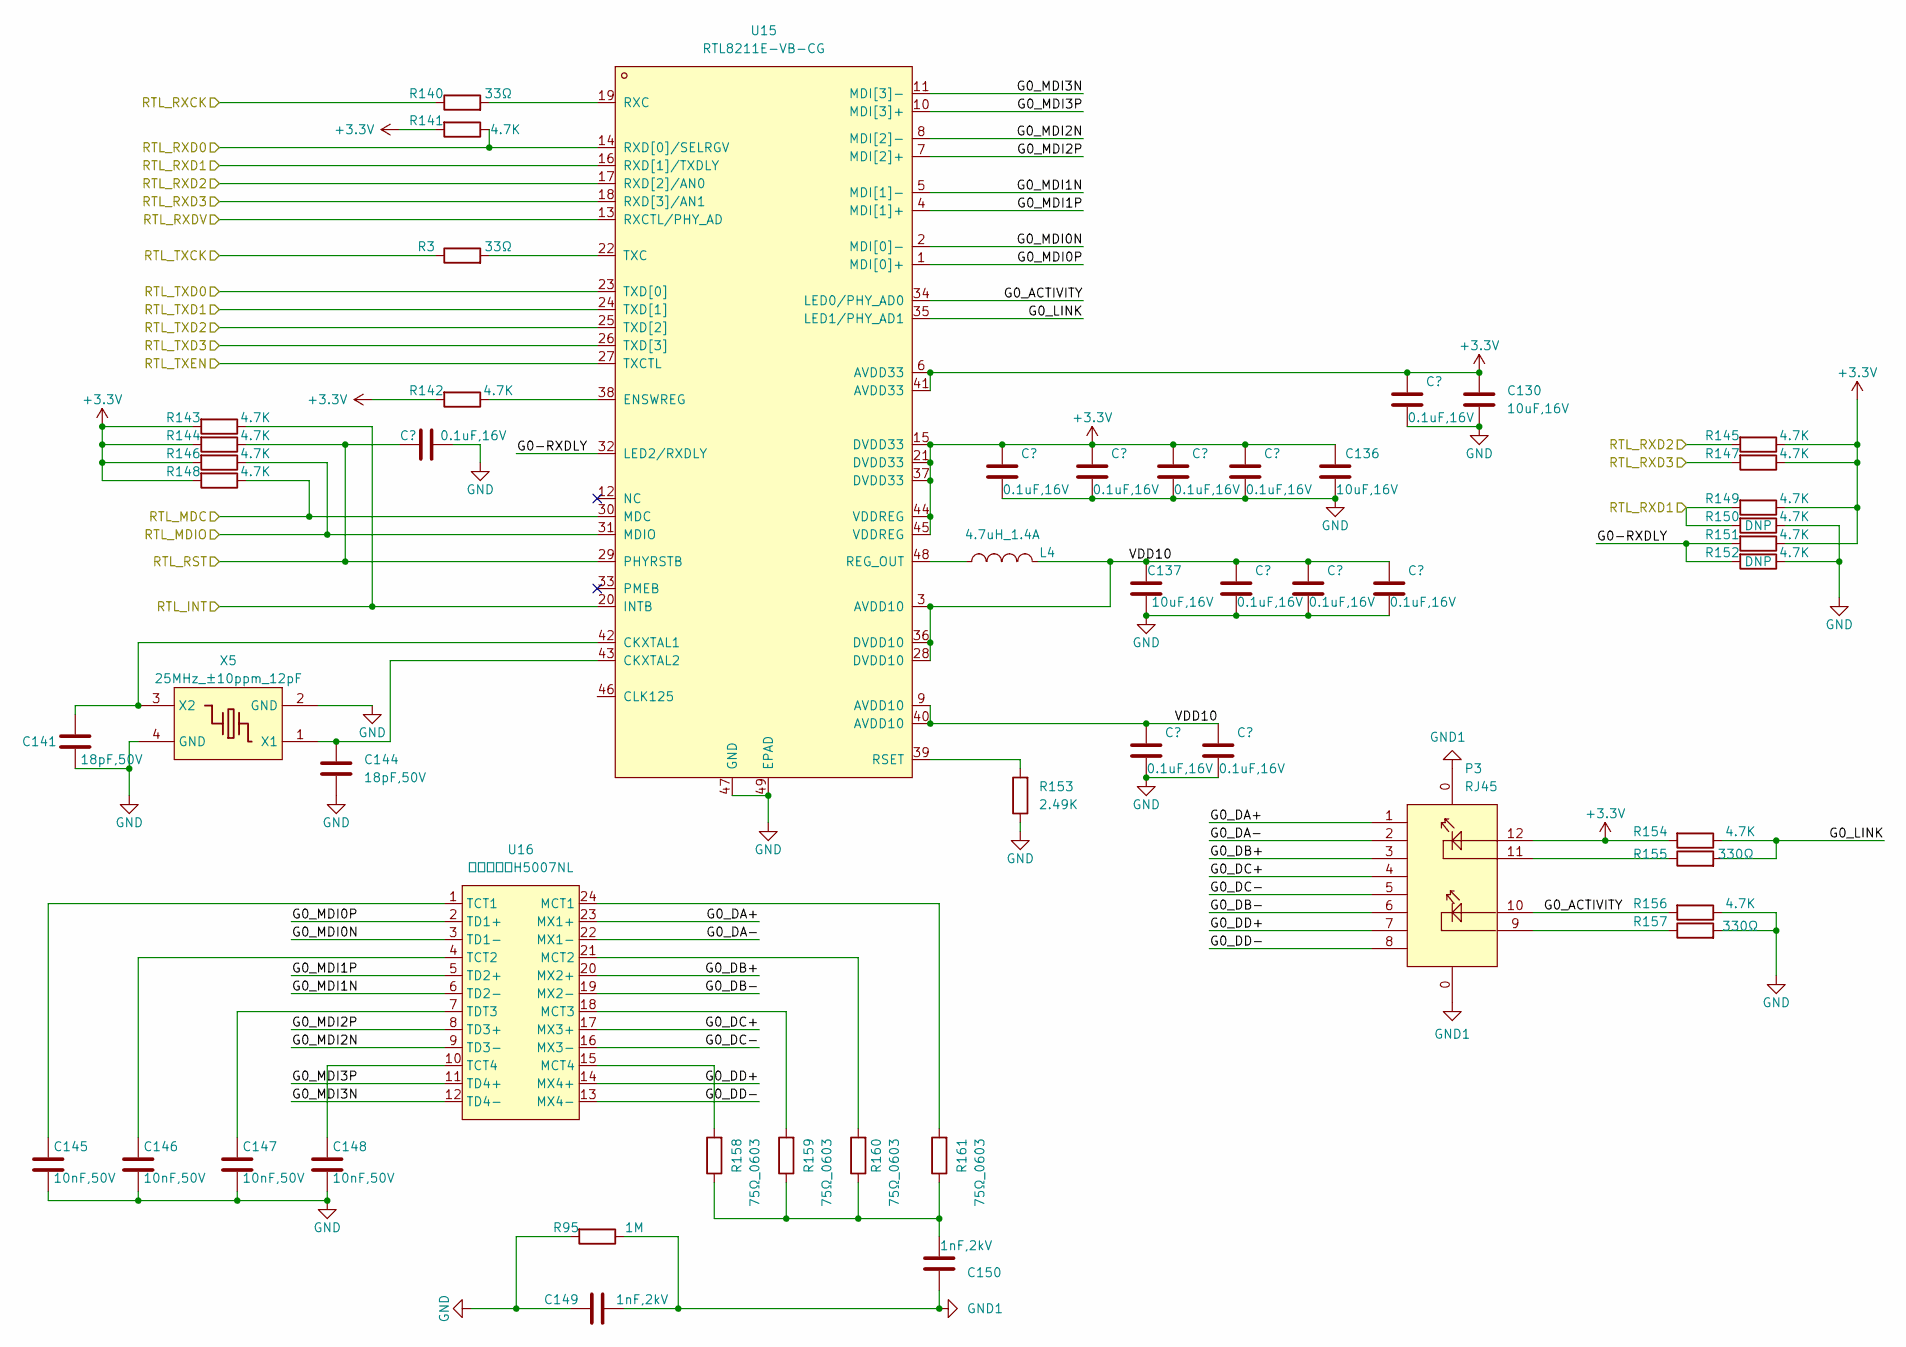
[picture p26: schematic ETH_RGMII.kicad_sch]

Parts:
C15, C129, C131, C132, C133, C134, C135, C139, C140, C142, C143: 0.1uF,16V; C_0402_1005Metric
C130, C136, C137: 10uF,16V; C_0603_1608Metric
C141, C144: 18pF,50V; C_0402_1005Metric
C145, C146, C147, C148: 10nF,50V; C_0402_1005Metric
C149, C150: 1nF,2kV; C_1206_3216Metric
L4: 4.7uH_1.4A; L252010
P3: RJ45; RJ45-TH_B-1-1
R3, R140: 33Ω; R_0402_1005Metric
R95: 1M; R_1206_3216Metric
R141, R142, R143, R144, R145, R146, R147, R148, R149, R150, R151, R152, R154, R156: 4.7K; R_0402_1005Metric
R153: 2.49K; R_0402_1005Metric
R155, R157: 330Ω; R_0402_1005Metric
R158, R159, R160, R161: 75Ω_0603; R_0603_1608Metric
U15: RTL8211E-VB-CG; QFN-48-1EP_6x6mm_P0.4mm_EP4.2x4.2mm
U16: 网口变压器H5007NL; PULSE_H5007NL
X5: 25MHz_±10ppm_12pF; 3225

Connections:
+3.3V: C129.1, C130.1, C132.1, C133.1, C134.1, C135.1, C136.1, P3.12, R141.2, R142.2, R143.2, R144.2, R145.1, R146.2, R147.1, R148.2, R149.1, R151.1, R154.2, U15.6 (AVDD33), U15.15 (DVDD33), U15.21 (DVDD33), U15.37 (DVDD33), U15.41 (AVDD33), U15.44 (VDDREG), U15.45 (VDDREG)
G0-RXDLY: R151.2, R152.2, U15.32 (LED2/RXDLY)
G0_ACTIVITY: P3.10, R156.2, U15.34 (LED0/PHY_AD0)
G0_DA+: P3.1, U16.23 (MX1+)
G0_DA-: P3.2, U16.22 (MX1-)
G0_DB+: P3.3, U16.20 (MX2+)
G0_DB-: P3.6, U16.19 (MX2-)
G0_DC+: P3.4, U16.17 (MX3+)
G0_DC-: P3.5, U16.16 (MX3-)
G0_DD+: P3.7, U16.14 (MX4+)
G0_DD-: P3.8, U16.13 (MX4-)
G0_LINK: R154.1, R155.2, U15.35 (LED1/PHY_AD1)
G0_MDI0N: U15.2 (MDI[0]-), U16.3 (TD1-)
G0_MDI0P: U15.1 (MDI[0]+), U16.2 (TD1+)
G0_MDI1N: U15.5 (MDI[1]-), U16.6 (TD2-)
G0_MDI1P: U15.4 (MDI[1]+), U16.5 (TD2+)
G0_MDI2N: U15.8 (MDI[2]-), U16.9 (TD3-)
G0_MDI2P: U15.7 (MDI[2]+), U16.8 (TD3+)
G0_MDI3N: U15.11 (MDI[3]-), U16.12 (TD4-)
G0_MDI3P: U15.10 (MDI[3]+), U16.11 (TD4+)
GND: C15.2, C129.2, C130.2, C131.2, C132.2, C133.2, C134.2, C135.2, C136.2, C137.2, C139.2, C140.2, C141.2, C142.2, C143.2, C144.2, C145.2, C146.2, C147.2, C148.2, C149.1, R95.2, R150.1, R152.1, R153.1, R156.1, R157.2, U15.47 (GND), U15.49 (EPAD), X5.2 (GND), X5.4 (GND)
GND1: C149.2, C150.1, P3.0 (S), R95.1
unnamed: C141.1, U15.42 (CKXTAL1), X5.3 (X2)
unnamed: C144.1, U15.43 (CKXTAL2), X5.1 (X1)
unnamed: C145.1, U16.1 (TCT1)
unnamed: C146.1, U16.4 (TCT2)
unnamed: C147.1, U16.7 (TDT3)
unnamed: C148.1, U16.10 (TCT4)
unnamed: C150.2, R158.1, R159.1, R160.1, R161.1
unnamed: L4.1, U15.48 (REG_OUT)
unnamed: P3.9, R157.1
unnamed: P3.11, R155.1
unnamed: R3.2, U15.22 (TXC)
unnamed: R140.2, U15.19 (RXC)
unnamed: R142.1, U15.38 (ENSWREG)
unnamed: R153.2, U15.39 (RSET)
unnamed: R158.2, U16.15 (MCT4)
unnamed: R159.2, U16.18 (MCT3)
unnamed: R160.2, U16.21 (MCT2)
unnamed: R161.2, U16.24 (MCT1)
RTL_INT: R143.1, U15.20 (INTB)
RTL_MDC: R148.1, U15.30 (MDC)
RTL_MDIO: R146.1, U15.31 (MDIO)
RTL_RST: C131.1, R144.1, U15.29 (PHYRSTB)
RTL_RXCK: R140.1
RTL_RXD0: R141.1, U15.14 (RXD[0]/SELRGV)
RTL_RXD1: R149.2, R150.2, U15.16 (RXD[1]/TXDLY)
RTL_RXD2: R145.2, U15.17 (RXD[2]/AN0)
RTL_RXD3: R147.2, U15.18 (RXD[3]/AN1)
RTL_RXDV: U15.13 (RXCTL/PHY_AD)
RTL_TXCK: R3.1
RTL_TXD0: U15.23 (TXD[0])
RTL_TXD1: U15.24 (TXD[1])
RTL_TXD2: U15.25 (TXD[2])
RTL_TXD3: U15.26 (TXD[3])
RTL_TXEN: U15.27 (TXCTL)
VDD10: C15.1, C137.1, C139.1, C140.1, C142.1, C143.1, L4.2, U15.3 (AVDD10), U15.9 (AVDD10), U15.28 (DVDD10), U15.36 (DVDD10), U15.40 (AVDD10)
