xiaokaizip/foc/circuit/kicad/hpm_ecat_foc/FOC_DRIVER.kicad_sch

## KiCad design circuit/kicad/hpm_ecat_foc/FOC_DRIVER.kicad_sch (2026-01-14)

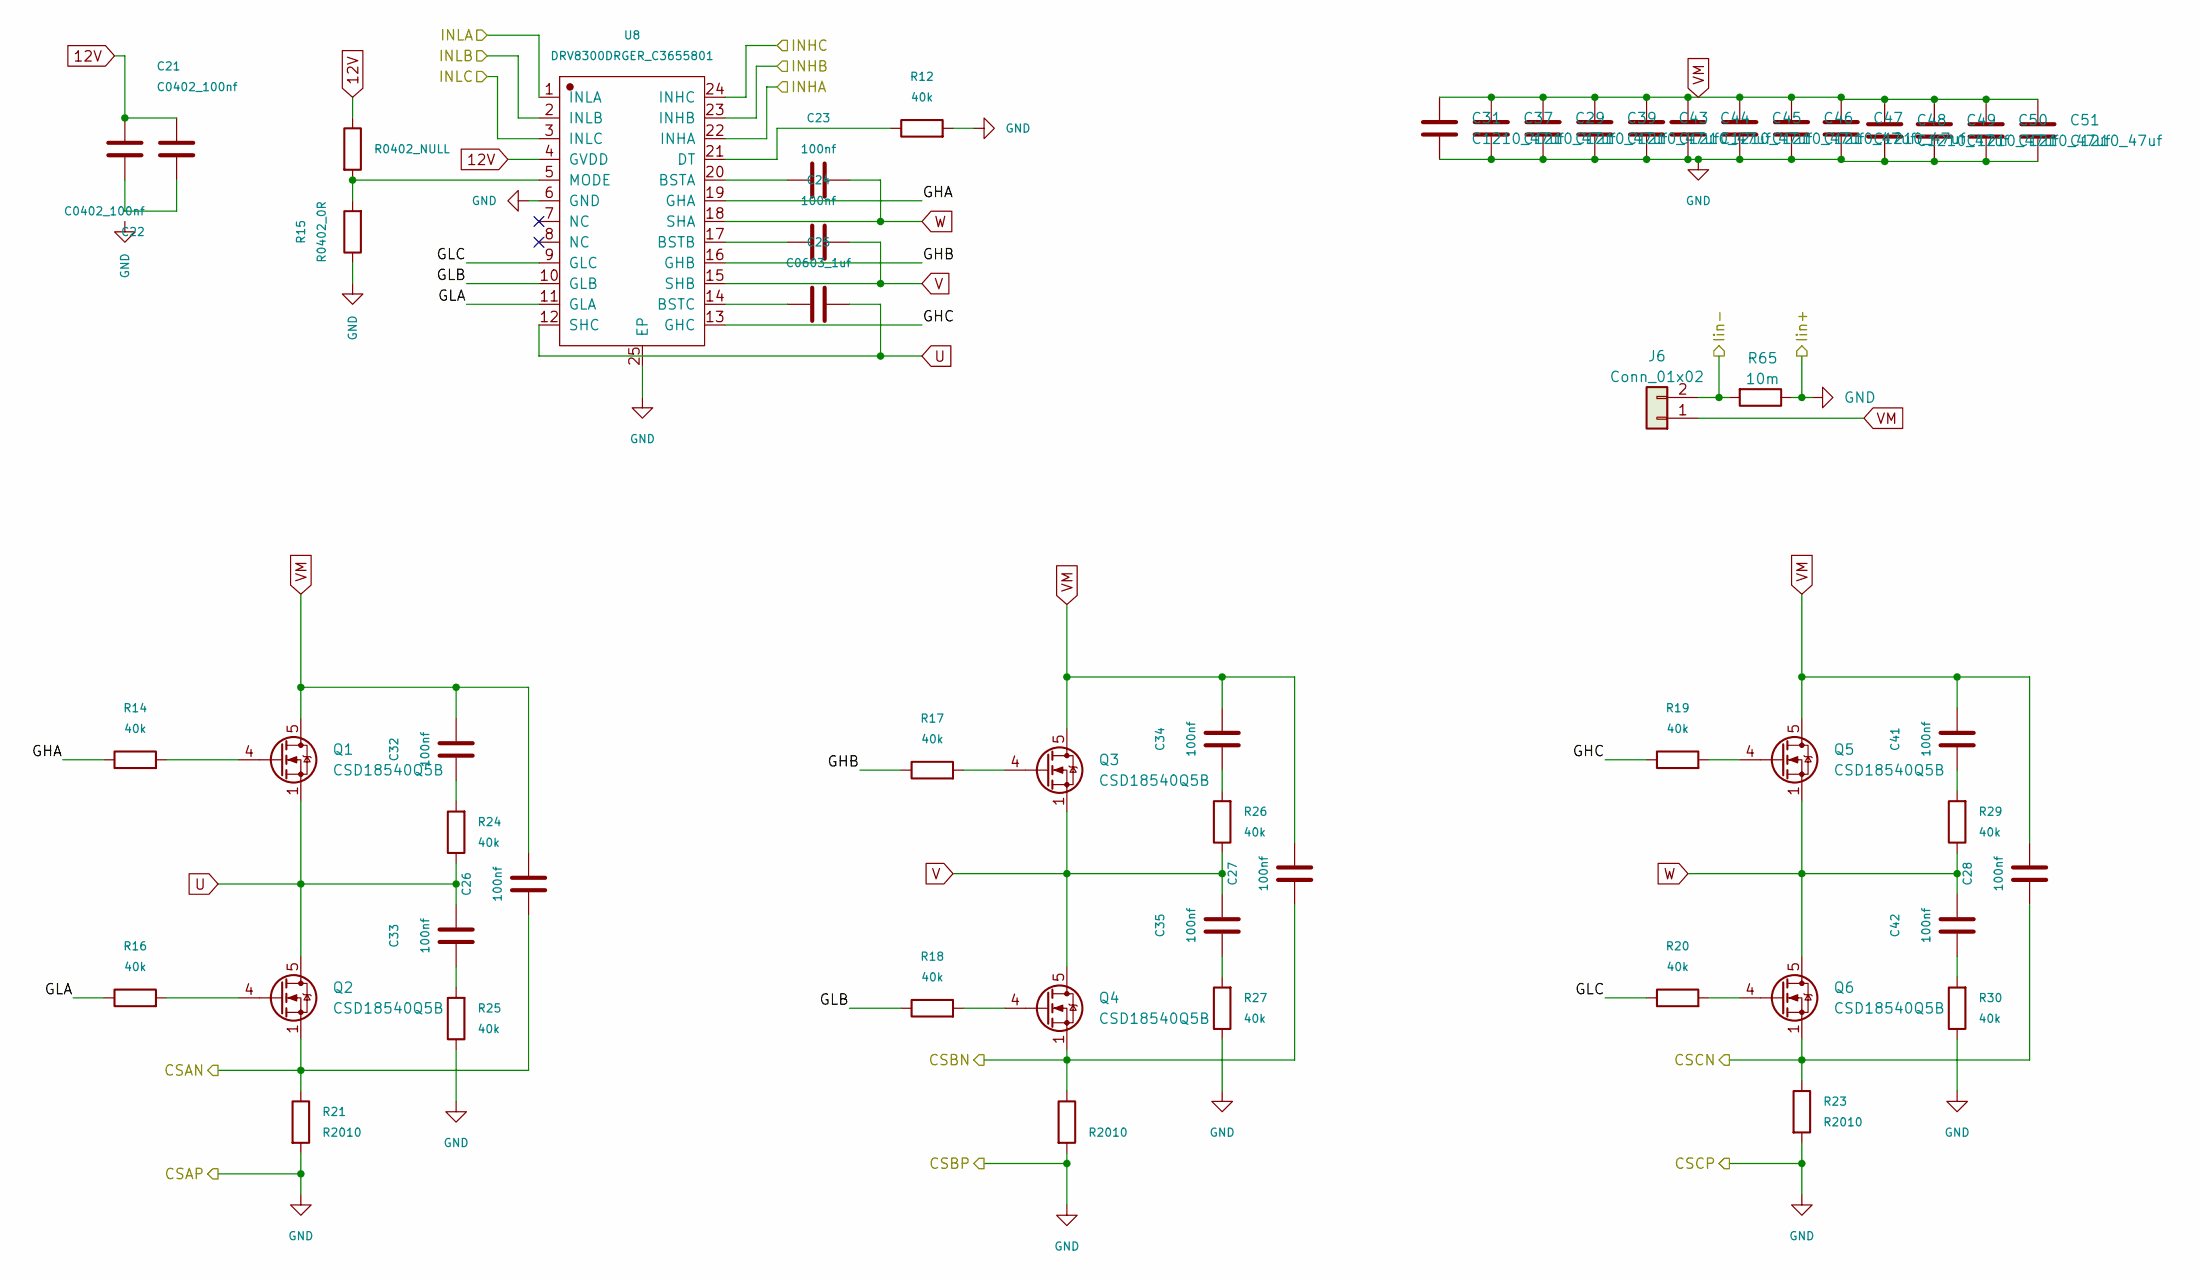
[picture p27: schematic FOC_DRIVER.kicad_sch]

Parts:
C21, C22: C0402_100nf; C_0402_1005Metric
C23, C24, C26, C27, C28, C32, C33, C34, C35, C41, C42: 100nf; C_0603_1608Metric
C25: C0603_1uf; C_0603_1608Metric
C29, C31, C37, C39, C43, C44, C45, C46, C47, C48, C49, C50, C51: C1210_47uf; C_1210_3225Metric
J6: Conn_01x02; XT30PW-M
Q1, Q2, Q3, Q4, Q5, Q6: CSD18540Q5B; TDSON-8-1
R12, R14, R16, R17, R18, R19, R20, R24, R25, R26, R27, R29, R30: 40k; R_0402_1005Metric
R13: R0402_NULL; R_0402_1005Metric
R15: R0402_0R; R_0402_1005Metric
R21, R22, R23: R2010; R_2010_5025Metric
R65: 10m; R_2512_6332Metric
U8: DRV8300DRGER_C3655801; DRV8300

Connections:
12V: C21.1, C22.2, R13.1, U8.4 (GVDD)
CSAN: C26.2, Q2.1 (S), Q2.2 (S), Q2.3 (S), R21.1
CSBN: C27.2, Q4.1 (S), Q4.2 (S), Q4.3 (S), R22.1
CSCN: C28.2, Q6.1 (S), Q6.2 (S), Q6.3 (S), R23.1
GHA: R14.1, U8.19 (GHA)
GHB: R17.1, U8.16 (GHB)
GHC: R19.1, U8.13 (GHC)
GLA: R16.1, U8.11 (GLA)
GLB: R18.1, U8.10 (GLB)
GLC: R20.1, U8.9 (GLC)
GND: C29.2, C31.2, C37.2, C39.2, C43.2, C44.2, C45.2, C46.2, C47.2, C48.2, C49.2, C50.2, C51.2, R12.2, R15.1, R21.2, R22.2, R23.2, R25.1, R27.1, R30.1, R65.1, U8.6 (GND), U8.25 (EP)
INHA: U8.22 (INHA)
INHB: U8.23 (INHB)
INHC: U8.24 (INHC)
INLA: U8.1 (INLA)
INLB: U8.2 (INLB)
INLC: U8.3 (INLC)
Iin-: J6.2, R65.2
unnamed: C21.2, C22.1
unnamed: C23.2, U8.20 (BSTA)
unnamed: C24.2, U8.17 (BSTB)
unnamed: C25.2, U8.14 (BSTC)
unnamed: C32.2, R24.2
unnamed: C33.2, R25.2
unnamed: C34.2, R26.2
unnamed: C35.2, R27.2
unnamed: C41.2, R29.2
unnamed: C42.2, R30.2
unnamed: Q1.4 (G), R14.2
unnamed: Q2.4 (G), R16.2
unnamed: Q3.4 (G), R17.2
unnamed: Q4.4 (G), R18.2
unnamed: Q5.4 (G), R19.2
unnamed: Q6.4 (G), R20.2
unnamed: R12.1, U8.21 (DT)
unnamed: R13.2, R15.2, U8.5 (MODE)
U: C25.1, C33.1, Q1.1 (S), Q1.2 (S), Q1.3 (S), Q2.5 (D), R24.1, U8.12 (SHC)
V: C24.1, C35.1, Q3.1 (S), Q3.2 (S), Q3.3 (S), Q4.5 (D), R26.1, U8.15 (SHB)
VM: C26.1, C27.1, C28.1, C29.1, C31.1, C32.1, C34.1, C37.1, C39.1, C41.1, C43.1, C44.1, C45.1, C46.1, C47.1, C48.1, C49.1, C50.1, C51.1, J6.1, Q1.5 (D), Q3.5 (D), Q5.5 (D)
W: C23.1, C42.1, Q5.1 (S), Q5.2 (S), Q5.3 (S), Q6.5 (D), R29.1, U8.18 (SHA)
