xiaokaizip/foc/circuit/kicad/hpm_ecat_foc/MCU_POWER.kicad_sch

## KiCad design circuit/kicad/hpm_ecat_foc/MCU_POWER.kicad_sch (2026-01-14)

Schematic: MCU_POWER.kicad_sch

Parts:
C18, C30, C90, C96, C102, C111: 22uF,10V; C_0603_1608Metric
C91, C92, C93, C94, C97, C98, C99, C100, C105: 0.1uF,16V; C_0402_1005Metric
C106, C109: 4.7uF,16V; C_0603_1608Metric
C107, C108: 0.01uF,16V; C_0402_1005Metric
C110: 2.2nF,50V; C_0402_1005Metric
FB6, FB7, FB8: 100Ω@100MHz 2A; R_0603_1608Metric
JP3: Jumper_3_Bridged12; PinHeader_1x03_P2.54mm_Vertical
JP21: Jumper_2; PinHeader_1x02_P2.54mm_Vertical
L3: 4.7uH_2A; L_1210_3225Metric
R100: 0Ω; R_0805_2012Metric
R101: 0Ω; R_0603_1608Metric
R109: 10Ω; R_0402_1005Metric
U1: HPM6E00BGA289_BDIF

Connections:
+1V2: JP3.1 (A)
+3.3V: FB6.2, JP21.1 (A)
+3.3VA: FB8.2
DCDC_GND: C90.2, C91.2, C96.2, R100.2, U1.R2 (DCDC_GND), U1.T2 (DCDC_GND), U1.U2 (DCDC_GND)
DCDC_IN: C90.1, C91.1, C96.1, FB6.1, JP21.2 (B), U1.R1 (DCDC_IN), U1.T1 (DCDC_IN)
DCDC_LP: L3.2, R109.2, U1.R3 (DCDC_LP), U1.T3 (DCDC_LP), U1.U3 (DCDC_LP)
DCDC_SNS: C102.1, C105.1, C111.1, FB7.1, JP3.3 (B), L3.1, U1.M6 (DCDC_SNS)
GND: C18.2, C30.2, C92.2, C93.2, C94.2, C97.2, C98.2, C99.2, C100.2, C102.2, C105.2, C110.2, C111.2, R100.1, R101.2
GNDA: C106.2, C107.2, C108.2, C109.2, R101.1, U1.L9 (VREFL), U1.L10 (VSSA)
unnamed: C110.1, R109.1
VANA: C106.1, C107.1, FB8.1, U1.M11 (VANA)
VDD_SOC: C18.1, C30.1, C92.1, C93.1, C94.1, C97.1, C98.1, C99.1, C100.1, FB7.2, JP3.2 (C), U1.F6 (VDD_SOC), U1.F12 (VDD_SOC), U1.G7 (VDD_SOC), U1.G11 (VDD_SOC), U1.H8 (VDD_SOC), U1.H10 (VDD_SOC), U1.J9 (VDD_SOC), U1.K8 (VDD_SOC), U1.K10 (VDD_SOC), U1.L7 (VDD_SOC), U1.L11 (VDD_SOC)
VREF_3.3V: C108.1, C109.1, U1.M10 (VREFH)
