xiaokaizip/foc/circuit/kicad/hpm_ecat_foc/POWER.kicad_sch

## KiCad design circuit/kicad/hpm_ecat_foc/POWER.kicad_sch (2026-01-14)

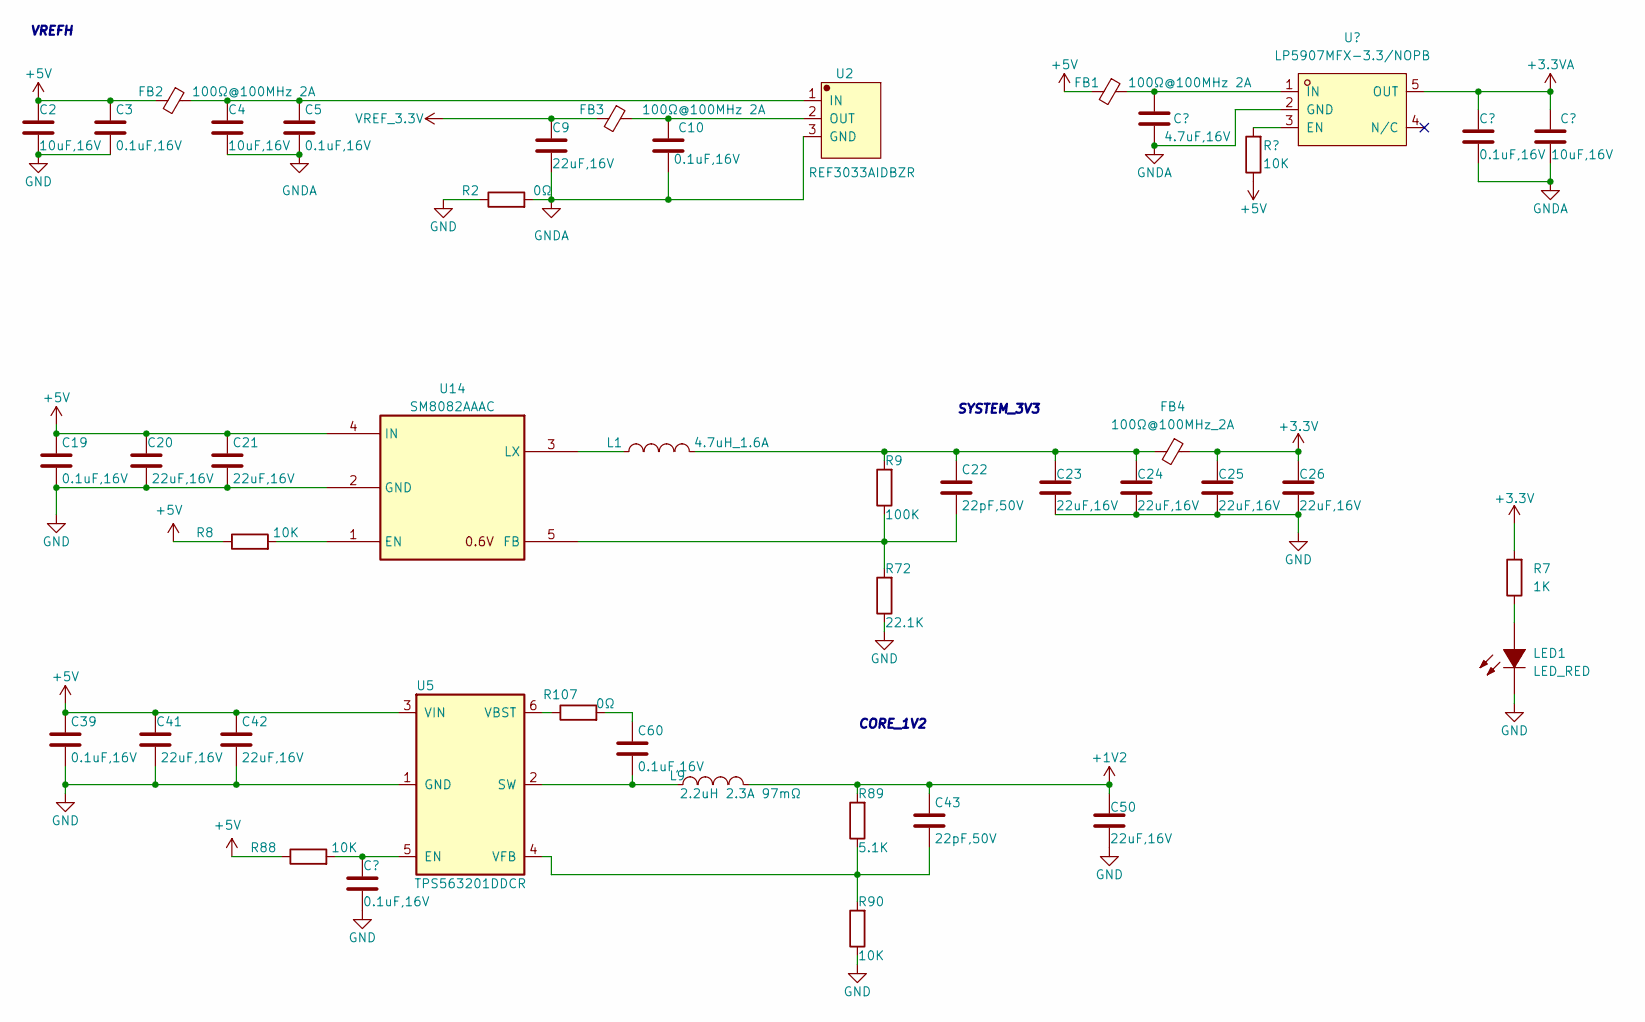
[picture p28: schematic POWER.kicad_sch]

Parts:
C1: 4.7uF,16V; C_0603_1608Metric
C2, C4, C7: 10uF,16V; C_0603_1608Metric
C3, C5, C6, C8, C10, C19, C39, C60: 0.1uF,16V; C_0402_1005Metric
C9, C20, C21, C23, C24, C25, C26, C41, C42, C50: 22uF,16V; C_0805_2012Metric
C22, C43: 22pF,50V; C_0402_1005Metric
FB1, FB2, FB3: 100Ω@100MHz 2A; R_0603_1608Metric
FB4: 100Ω@100MHz_2A; R_0805_2012Metric
L1: 4.7uH_1.6A; L_1210_3225Metric
L9: 2.2uH 2.3A 97mΩ; L252010
LED1: LED_RED; LED_0603
R1, R8, R88, R90: 10K; R_0402_1005Metric
R2: 0Ω; R_0603_1608Metric
R7: 1K; R_0402_1005Metric
R9: 100K; R_0402_1005Metric
R72: 22.1K; R_0402_1005Metric
R89: 5.1K; R_0402_1005Metric
R107: 0Ω; R_0402_1005Metric
U1: LP5907MFX-3.3/NOPB; SOT-23-5
U2: REF3033AIDBZR; SOT-23
U5: TPS563201DDCR; SOT-23-6
U14: SM8082AAAC; SOT-23-5

Connections:
+1V2: C43.1, C50.1, L9.2, R89.2
+3.3V: C25.1, C26.1, FB4.1, R7.2
+3.3VA: C6.1, C7.1, U1.5 (OUT)
+5V: C2.1, C3.1, C19.1, C20.1, C21.1, C39.1, C41.1, C42.1, FB1.2, FB2.2, R1.1, R8.1, R88.1, U5.3 (VIN), U14.4 (IN)
GND: C2.2, C3.2, C8.2, C19.2, C20.2, C21.2, C23.2, C24.2, C25.2, C26.2, C39.2, C41.2, C42.2, C50.2, LED1.1 (K), R2.1, R72.1, R90.1, U5.1 (GND), U14.2 (GND)
GNDA: C1.2, C4.2, C5.2, C6.2, C7.2, C9.2, C10.2, R2.2, U1.2 (GND), U2.3 (GND)
unnamed: C1.1, FB1.1, U1.1 (IN)
unnamed: C4.1, C5.1, FB2.1, U2.1 (IN)
unnamed: C8.1, R88.2, U5.5 (EN)
unnamed: C10.1, FB3.1, U2.2 (OUT)
unnamed: C22.1, C23.1, C24.1, FB4.2, L1.2, R9.2
unnamed: C22.2, R9.1, R72.2, U14.5 (FB)
unnamed: C43.2, R89.1, R90.2, U5.4 (VFB)
unnamed: C60.1, R107.2
unnamed: C60.2, L9.1, U5.2 (SW)
unnamed: L1.1, U14.3 (LX)
unnamed: LED1.2 (A), R7.1
unnamed: R1.2, U1.3 (EN)
unnamed: R8.2, U14.1 (EN)
unnamed: R107.1, U5.6 (VBST)
VREF_3.3V: C9.1, FB3.2

Notes on the sheet:
VREFH
CORE_1V2
SYSTEM_3V3
