xiaokaizip/foc/code/board/odrive/foc.ioc

Mcu.UserName=STM32F405RGTx
PA0-WKUP.Signal=UART4_TX
PA1.Signal=UART4_RX
PA10.Signal=S_TIM1_CH3
PA11.Signal=USB_OTG_FS_DM
PA12.Signal=USB_OTG_FS_DP
PA13.Signal=SYS_JTMS-SWDIO
PA14.Signal=SYS_JTCK-SWCLK
PA3.GPIO_Label=AS5047_CS0
PA3.Signal=GPIO_Output
PA6.Signal=ADCx_IN6
PA8.Signal=S_TIM1_CH1
PA9.Signal=S_TIM1_CH2
PB12.GPIO_Label=EN_GATE
PB12.Signal=GPIO_Output
PB13.Signal=TIM1_CH1N
PB14.Signal=TIM1_CH2N
PB15.Signal=TIM1_CH3N
PB8.Signal=CAN1_RX
PB9.Signal=CAN1_TX
PC0.Signal=ADCx_IN10
PC1.Signal=ADCx_IN11
PC10.Signal=SPI3_SCK
PC11.Signal=SPI3_MISO
PC12.Signal=SPI3_MOSI
PC13-ANTI_TAMP.GPIO_Label=M0_nCS
PC13-ANTI_TAMP.Signal=GPIO_Output
PC14-OSC32_IN.GPIO_Label=M1_nCS
PC14-OSC32_IN.Signal=GPIO_Output
PC2.Signal=ADCx_IN12
PC3.Signal=ADCx_IN13
PD2.GPIO_Label=nfault
PD2.Signal=GPIO_Input
PH0-OSC_IN.Signal=RCC_OSC_IN
PH1-OSC_OUT.Signal=RCC_OSC_OUT
