xiaokaizip/foc/STSPIN32G4_FOC/boards/BLDC/Core/Inc/parameters_conversion.h

#define PARAMETERS_CONVERSION_H
#include "mc_math.h"
#include "parameters_conversion_g4xx.h"
#include "pmsm_motor_parameters.h"
#include "drive_parameters.h"
#include "power_stage_parameters.h"
#define CURRENT_CONV_FACTOR                 (uint16_t)((65536.0 * RSHUNT * AMPLIFICATION_GAIN)/ADC_REFERENCE_VOLTAGE)
#define CURRENT_CONV_FACTOR_INV             (1.0 / ((65536.0 * RSHUNT * AMPLIFICATION_GAIN) / ADC_REFERENCE_VOLTAGE))
#define NOMINAL_CURRENT                     (NOMINAL_CURRENT_A * CURRENT_CONV_FACTOR)
#define ADC_REFERENCE_VOLTAGE               3.3
#define M1_MAX_READABLE_CURRENT  (ADC_REFERENCE_VOLTAGE / (2 * RSHUNT * AMPLIFICATION_GAIN))
#define TF_REGULATION_RATE                  (uint32_t)((uint32_t)(PWM_FREQUENCY) / (REGULATION_EXECUTION_RATE))
#define TF_REGULATION_RATE_SCALED           (uint16_t)((uint32_t)(PWM_FREQUENCY) / (REGULATION_EXECUTION_RATE\
                                            * PWM_FREQ_SCALING))
#define DPP_CONV_FACTOR                     (65536 / PWM_FREQ_SCALING)
#define ID_DEMAG                            (ID_DEMAG_A * CURRENT_CONV_FACTOR)
#define IQMAX                               (IQMAX_A * CURRENT_CONV_FACTOR)
#define DEFAULT_TORQUE_COMPONENT            (DEFAULT_TORQUE_COMPONENT_A * CURRENT_CONV_FACTOR)
#define DEFAULT_FLUX_COMPONENT              (DEFAULT_FLUX_COMPONENT_A * CURRENT_CONV_FACTOR)
#define REP_COUNTER                         (uint16_t)((REGULATION_EXECUTION_RATE * 2u) - 1u)
#define SYS_TICK_FREQUENCY                  (uint16_t)2000
#define UI_TASK_FREQUENCY_HZ                10U
#define PHASE1_FINAL_CURRENT                (PHASE1_FINAL_CURRENT_A * CURRENT_CONV_FACTOR)
#define PHASE2_FINAL_CURRENT                (PHASE2_FINAL_CURRENT_A * CURRENT_CONV_FACTOR)
#define PHASE3_FINAL_CURRENT                (PHASE3_FINAL_CURRENT_A * CURRENT_CONV_FACTOR)
#define PHASE4_FINAL_CURRENT                (PHASE4_FINAL_CURRENT_A * CURRENT_CONV_FACTOR)
#define PHASE5_FINAL_CURRENT                (PHASE5_FINAL_CURRENT_A * CURRENT_CONV_FACTOR)
#define MEDIUM_FREQUENCY_TASK_RATE          (uint16_t)SPEED_LOOP_FREQUENCY_HZ
#define MF_TASK_OCCURENCE_TICKS             (SYS_TICK_FREQUENCY / SPEED_LOOP_FREQUENCY_HZ) - 1u
#define UI_TASK_OCCURENCE_TICKS             (SYS_TICK_FREQUENCY / UI_TASK_FREQUENCY_HZ) - 1u
#define SERIALCOM_TIMEOUT_OCCURENCE_TICKS   (SYS_TICK_FREQUENCY / SERIAL_COM_TIMEOUT_INVERSE) - 1u
#define SERIALCOM_ATR_TIME_TICKS            (uint16_t)(((SYS_TICK_FREQUENCY * SERIAL_COM_ATR_TIME_MS) / 1000u) - 1u)
#define MAX_BEMF_VOLTAGE                    (uint16_t)((MAX_APPLICATION_SPEED_RPM * 1.2 *\
                                            MOTOR_VOLTAGE_CONSTANT * SQRT_2) / (1000u * SQRT_3))
#define MAX_VOLTAGE                         (int16_t)((ADC_REFERENCE_VOLTAGE / SQRT_3) / VBUS_PARTITIONING_FACTOR)
#define MAX_CURRENT                         (ADC_REFERENCE_VOLTAGE / (2 * RSHUNT * AMPLIFICATION_GAIN))
#define OBS_MINIMUM_SPEED_UNIT              (uint16_t)((OBS_MINIMUM_SPEED_RPM * SPEED_UNIT) / U_RPM)
#define MAX_APPLICATION_SPEED_UNIT          ((MAX_APPLICATION_SPEED_RPM * SPEED_UNIT) / U_RPM)
#define MIN_APPLICATION_SPEED_UNIT          ((MIN_APPLICATION_SPEED_RPM * SPEED_UNIT) / U_RPM)
#define C1                                  (int32_t)((((int16_t)F1) * RS) / (LS * TF_REGULATION_RATE))
#define C2                                  (int32_t)GAIN1
#define C3                                  (int32_t)((((int16_t)F1) * MAX_BEMF_VOLTAGE)\
                                            / (LS * MAX_CURRENT * TF_REGULATION_RATE))
#define C4                                  (int32_t)GAIN2
#define C5                                  (int32_t)((((int16_t)F1) * MAX_VOLTAGE)\
                                            / (LS * MAX_CURRENT * TF_REGULATION_RATE))
#define PERCENTAGE_FACTOR                   (uint16_t)(VARIANCE_THRESHOLD*128u)
#define HFI_MINIMUM_SPEED                   (uint16_t) (HFI_MINIMUM_SPEED_RPM/6u)
#define MAX_APPLICATION_SPEED_UNIT2         ((MAX_APPLICATION_SPEED_RPM2 * SPEED_UNIT) / U_RPM)
#define MIN_APPLICATION_SPEED_UNIT2         ((MIN_APPLICATION_SPEED_RPM2 * SPEED_UNIT) / U_RPM)
#define OVERVOLTAGE_THRESHOLD_d             (uint16_t)(OV_VOLTAGE_THRESHOLD_V * 65535 /\
                                            (ADC_REFERENCE_VOLTAGE / VBUS_PARTITIONING_FACTOR))
#define OVERVOLTAGE_THRESHOLD_LOW_d         (uint16_t)(OV_VOLTAGE_THRESHOLD_V * 65535 /\
                                            (ADC_REFERENCE_VOLTAGE / VBUS_PARTITIONING_FACTOR))
#define UNDERVOLTAGE_THRESHOLD_d            (uint16_t)((UD_VOLTAGE_THRESHOLD_V * 65535) /\
                                            ((uint16_t)(ADC_REFERENCE_VOLTAGE / VBUS_PARTITIONING_FACTOR)))
#define INT_SUPPLY_VOLTAGE                  (uint16_t)(65536 / ADC_REFERENCE_VOLTAGE)
#define DELTA_TEMP_THRESHOLD                (OV_TEMPERATURE_THRESHOLD_C - T0_C)
#define DELTA_V_THRESHOLD                   (dV_dT * DELTA_TEMP_THRESHOLD)
#define OV_TEMPERATURE_THRESHOLD_d          ((V0_V + DELTA_V_THRESHOLD) * INT_SUPPLY_VOLTAGE)
#define DELTA_TEMP_HYSTERESIS               (OV_TEMPERATURE_HYSTERESIS_C)
#define DELTA_V_HYSTERESIS                  (dV_dT * DELTA_TEMP_HYSTERESIS)
#define OV_TEMPERATURE_HYSTERESIS_d         (DELTA_V_HYSTERESIS * INT_SUPPLY_VOLTAGE)
#define PWM_PERIOD_CYCLES                   (uint16_t)(((uint32_t)ADV_TIM_CLK_MHz * (uint32_t)1000000u\
                                            / ((uint32_t)(PWM_FREQUENCY))) & (uint16_t)0xFFFE)
#define DEADTIME_NS                         SW_DEADTIME_NS
#define DEAD_TIME_ADV_TIM_CLK_MHz           (ADV_TIM_CLK_MHz * TIM_CLOCK_DIVIDER)
#define DEAD_TIME_COUNTS_1                  (DEAD_TIME_ADV_TIM_CLK_MHz * DEADTIME_NS / 1000uL)
#if (DEAD_TIME_COUNTS_1 <= 255)
#define DEAD_TIME_COUNTS                    (uint16_t)DEAD_TIME_COUNTS_1
#elif (DEAD_TIME_COUNTS_1 <= 508)
#define DEAD_TIME_COUNTS                    (uint16_t)(((DEAD_TIME_ADV_TIM_CLK_MHz * DEADTIME_NS/2) /1000uL) + 128)
#elif (DEAD_TIME_COUNTS_1 <= 1008)
#define DEAD_TIME_COUNTS                    (uint16_t)(((DEAD_TIME_ADV_TIM_CLK_MHz * DEADTIME_NS/8) /1000uL) + 320)
#elif (DEAD_TIME_COUNTS_1 <= 2015)
#define DEAD_TIME_COUNTS                    (uint16_t)(((DEAD_TIME_ADV_TIM_CLK_MHz * DEADTIME_NS/16) /1000uL) + 384)
#else
#define DEAD_TIME_COUNTS 510
#endif
#define DTCOMPCNT                           (uint16_t)((DEADTIME_NS * ADV_TIM_CLK_MHz) / 2000)
#define TON_NS                              500
#define TOFF_NS                             500
#define TON                                 (uint16_t)((TON_NS * ADV_TIM_CLK_MHz)  / 2000)
#define TOFF                                (uint16_t)((TOFF_NS * ADV_TIM_CLK_MHz) / 2000)
#define SAMPLING_TIME                       ((ADC_SAMPLING_CYCLES * ADV_TIM_CLK_MHz) / ADC_CLK_MHz)
#define TRISE                               ((TRISE_NS * ADV_TIM_CLK_MHz)/1000uL)
#define TDEAD                               ((uint16_t)((DEADTIME_NS * ADV_TIM_CLK_MHz)/1000))
#define TNOISE                              ((uint16_t)((TNOISE_NS*ADV_TIM_CLK_MHz)/1000))
#define HTMIN 1
#define TW_AFTER                            ((uint16_t)(((DEADTIME_NS+MAX_TNTR_NS)*ADV_TIM_CLK_MHz)/1000UL))
#define MAX_TWAIT                           ((uint16_t)((TW_AFTER - SAMPLING_TIME)/2))
#define TW_BEFORE                           ((uint16_t)((ADC_TRIG_CONV_LATENCY_CYCLES + ADC_SAMPLING_CYCLES)\
                                            * ADV_TIM_CLK_MHz) / ADC_CLK_MHz  + 1u)
#define TW_BEFORE_R3_1                      ((uint16_t)((ADC_TRIG_CONV_LATENCY_CYCLES + (ADC_SAMPLING_CYCLES * 2)\
                                            + ADC_SAR_CYCLES) * ADV_TIM_CLK_MHz) / ADC_CLK_MHz  + 1u)
#define M1_VIRTUAL_HEAT_SINK_TEMPERATURE_VALUE 25u
#define M1_TEMP_SW_FILTER_BW_FACTOR         250u
#define PQD_CONVERSION_FACTOR               (float_t)(((1.732 * ADC_REFERENCE_VOLTAGE) /\
                                            (RSHUNT * AMPLIFICATION_GAIN)) / 65536.0f)
#define DAC_ENABLE
#define DAC_OP_ENABLE
#define FW_ENABLE
#define DIFFTERM_ENABLE
#define MAIN_SCFG                           UI_SCODE_STO_PLL
#define AUX_SCFG                               0x0
#define PLLTUNING_ENABLE
#define UI_CFGOPT_PFC_ENABLE
#define UI_CONFIG_M1                        (UI_CFGOPT_NONE DAC_OP_ENABLE FW_ENABLE DIFFTERM_ENABLE\
                                            | (MAIN_SCFG << MAIN_SCFG_POS)\
                                            | (AUX_SCFG << AUX_SCFG_POS)\
                                            | UI_CFGOPT_SETIDINSPDMODE PLLTUNING_ENABLE UI_CFGOPT_PFC_ENABLE\
                                            | UI_CFGOPT_PLLTUNING)
#define UI_CONFIG_M2
#define DIN_ACTIVE_LOW                      Bit_RESET
#define DIN_ACTIVE_HIGH                     Bit_SET
#define DOUT_ACTIVE_HIGH                    DOutputActiveHigh
#define DOUT_ACTIVE_LOW                     DOutputActiveLow
#define LPF_FILT_CONST                      ((int16_t)(32767 * 0.5))
#define MAX_MODULE                          (uint16_t)((100* 32767)/100)
#define SAMPLING_CYCLE_CORRECTION           0.5
#define LL_ADC_SAMPLINGTIME_1CYCLES_5       LL_ADC_SAMPLINGTIME_1CYCLE_5
#define LL_ADC_SAMPLING_CYCLE(CYCLE)        LL_ADC_SAMPLINGTIME_ ## CYCLE ## CYCLES_5
