xiaokaizip/foc/code/board/foc/Core/Inc/main.h

#define M0_nCS_Pin GPIO_PIN_13
#define M0_nCS_GPIO_Port GPIOC
#define M1_nCS_Pin GPIO_PIN_14
#define M1_nCS_GPIO_Port GPIOC
#define AS5047_CS0_Pin GPIO_PIN_3
#define AS5047_CS0_GPIO_Port GPIOA
#define EN_GATE_Pin GPIO_PIN_12
#define EN_GATE_GPIO_Port GPIOB
#define nfault_Pin GPIO_PIN_2
#define nfault_GPIO_Port GPIOD
