xiaokaizip/foc/circuit/candence/stm32/nc_param.txt

INTEGER-PLACES         5
DECIMAL-PLACES         5
X-OFFSET               0.000000
Y-OFFSET               0.000000
FEEDRATE               1
COORDINATES            ABSOLUTE
OUTPUT-UNITS           METRIC
TOOL-ORDER             INCREASING
REPEAT-CODES           YES
SUPPRESS-LEAD-ZEROES   YES
SUPPRESS-TRAIL-ZEROES  NO
SUPPRESS-EQUAL         NO
TOOL-SELECT            NO
OPTIMIZE_DRILLING      NO
ENHANCED_EXCELLON      YES
TAPE-FILE              D:/project/foc/circuit/candence/stm32/STSTP32_FOC/stspin32g4_foc-1-4.drl
ROUTE-FILE             D:/project/07_foc/foc/circuit/candence/stm32/gerbar/stspin32g4_foc.rou
HEADER                 none
LEADER                 12
CODE                   ASCII
SEPARATE               NO
SEPARATE-ROUTING       NO
DRILLING               LAYER-PAIR
BACKDRILL              NO
CAVITY                 NO
COUNTER                NO
TOLERANCE_DRILL        YES
TOLERANCE_TRAVEL       YES
TOOL_SIZE              YES
ROTATION               YES
NON_STANDARD           YES
TOTAL_DRILL            NO
SEPARATE_SLOT          NO
SUPPRESS_TOLERANCE     YES
SUPPRESS_TOOLSIZE      YES
SUPPRESS_ROTATION      YES
