xiaokaizip/foc/STSPIN32G4_FOC/boards/BLDC/Core/Inc/mc_math.h

/**
  ******************************************************************************
  * @file    mc_math.h
  * @author  Motor Control SDK Team, ST Microelectronics
  * @brief   This file provides mathematics functions useful for and specific to
  *          Motor Control.
  *
  ******************************************************************************
  * @attention
  *
  * <h2><center>&copy; Copyright (c) 2025 STMicroelectronics.
  * All rights reserved.</center></h2>
  *
  * This software component is licensed by ST under Ultimate Liberty license
  * SLA0044, the "License"; You may not use this file except in compliance with
  * the License. You may obtain a copy of the License at:
  *                             www.st.com/SLA0044
  *
  ******************************************************************************
  * @ingroup MC_Math
  */
/* Define to prevent recursive inclusion -------------------------------------*/
#ifndef MC_MATH_H
#define MC_MATH_H

/* Includes ------------------------------------------------------------------*/
#include "mc_type.h"

/** @addtogroup MCSDK
  * @{
  */

/** @addtogroup MC_Math
  * @{
  */
#define SQRT_2  1.4142
#define SQRT_3  1.732

/* CORDIC coprocessor configuration register settings */

/* CORDIC FUNCTION: PHASE q1.31 (Electrical Angle computation) */
#define CORDIC_CONFIG_PHASE     (LL_CORDIC_FUNCTION_PHASE | LL_CORDIC_PRECISION_6CYCLES | LL_CORDIC_SCALE_0 |\
         LL_CORDIC_NBWRITE_2 | LL_CORDIC_NBREAD_1 |\
         LL_CORDIC_INSIZE_32BITS | LL_CORDIC_OUTSIZE_32BITS)

/* CORDIC FUNCTION: SQUAREROOT q1.31 */
#define CORDIC_CONFIG_SQRT      (LL_CORDIC_FUNCTION_SQUAREROOT | LL_CORDIC_PRECISION_6CYCLES | LL_CORDIC_SCALE_1 |\
         LL_CORDIC_NBWRITE_1 | LL_CORDIC_NBREAD_1 |\
         LL_CORDIC_INSIZE_32BITS | LL_CORDIC_OUTSIZE_32BITS)

/* CORDIC FUNCTION: COSINE q1.15 */
#define CORDIC_CONFIG_COSINE    (LL_CORDIC_FUNCTION_COSINE | LL_CORDIC_PRECISION_6CYCLES | LL_CORDIC_SCALE_0 |\
         LL_CORDIC_NBWRITE_1 | LL_CORDIC_NBREAD_1 |\
         LL_CORDIC_INSIZE_16BITS | LL_CORDIC_OUTSIZE_16BITS)

/* CORDIC FUNCTION: MODULUS q1.15 */
#define CORDIC_CONFIG_MODULUS   (LL_CORDIC_FUNCTION_MODULUS | LL_CORDIC_PRECISION_6CYCLES | LL_CORDIC_SCALE_0 |\
         LL_CORDIC_NBWRITE_1 | LL_CORDIC_NBREAD_1 |\
         LL_CORDIC_INSIZE_16BITS | LL_CORDIC_OUTSIZE_16BITS)

/**
  * @brief  Macro to compute logarithm of two
  */
#define LOG2(x) \
  (((x) == 65535 ) ? 16 : \
   (((x) == (2*2*2*2*2*2*2*2*2*2*2*2*2*2*2)) ? 15 : \
    (((x) == (2*2*2*2*2*2*2*2*2*2*2*2*2*2)) ? 14 : \
     (((x) == (2*2*2*2*2*2*2*2*2*2*2*2*2)) ? 13 : \
      (((x) == (2*2*2*2*2*2*2*2*2*2*2*2)) ? 12 : \
       (((x) == (2*2*2*2*2*2*2*2*2*2*2)) ? 11 : \
        (((x) == (2*2*2*2*2*2*2*2*2*2)) ? 10 : \
         (((x) == (2*2*2*2*2*2*2*2*2)) ? 9 : \
          (((x) == (2*2*2*2*2*2*2*2)) ? 8 : \
           (((x) == (2*2*2*2*2*2*2)) ? 7 : \
            (((x) == (2*2*2*2*2*2)) ? 6 : \
             (((x) == (2*2*2*2*2)) ? 5 : \
              (((x) == (2*2*2*2)) ? 4 : \
               (((x) == (2*2*2)) ? 3 : \
                (((x) == (2*2)) ? 2 : \
                 (((x) == 2) ? 1 : \
                  (((x) == 1) ? 0 : -1)))))))))))))))))

/**
  * @brief  Trigonometrical functions type definition
  */
typedef struct
{
  int16_t hCos;
  int16_t hSin;
} Trig_Components;

/**
  * @brief  This function transforms stator currents Ia and qIb (which are
  *         directed along axes each displaced by 120 degrees) into currents
  *         Ialpha and Ibeta in a stationary qd reference frame.
  *                               Ialpha = Ia
  *                       Ibeta = -(2*Ib+Ia)/sqrt(3)
  * @param  Input: stator current Ia and Ib in ab_t format.
  * @retval Stator current Ialpha and Ibeta in alphabeta_t format.
  */
alphabeta_t MCM_Clarke(ab_t Input);

/**
  * @brief  This function transforms stator values alpha and beta, which
  *         belong to a stationary qd reference frame, to a rotor flux
  *         synchronous reference frame (properly oriented), so as Iq and Id.
  *                   Id= Ialpha *sin(theta)+qIbeta *cos(Theta)
  *                   Iq=qIalpha *cos(Theta)-qIbeta *sin(Theta)
  * @param  Input: stator values alpha and beta in alphabeta_t format.
  * @param  Theta: rotating frame angular position in q1.15 format.
  * @retval Stator current q and d in qd_t format.
  */
qd_t MCM_Park(alphabeta_t Input, int16_t Theta);

/**
  * @brief  This function transforms stator voltage qVq and qVd, that belong to
  *         a rotor flux synchronous rotating frame, to a stationary reference
  *         frame, so as to obtain qValpha and qVbeta:
  *                  Valfa= Vq*Cos(theta)+ Vd*Sin(theta)
  *                  Vbeta=-Vq*Sin(theta)+ Vd*Cos(theta)
  * @param  Input: stator voltage Vq and Vd in qd_t format.
  * @param  Theta: rotating frame angular position in q1.15 format.
  * @retval Stator values alpha and beta in alphabeta_t format.
  */
alphabeta_t MCM_Rev_Park(qd_t Input, int16_t Theta);

/**
  * @brief  This function returns cosine and sine functions of the angle fed in input.
  * @param  hAngle: angle in q1.15 format.
  * @retval Trig_Components Cos(angle) and Sin(angle) in Trig_Components format.
  */
Trig_Components MCM_Trig_Functions(int16_t hAngle);

/**
  * @brief  It calculates the square root of a non-negative s32. It returns 0 for negative s32.
  * @param  wInput int32_t number.
  * @retval int32_t Square root of Input (0 if Input<0).
  */
int32_t MCM_Sqrt(int32_t wInput);

/**
  * @brief  Sqrt table used by Circle Limitation function
  *         used for STM32F0/STM32G0 series only
  */
#define SQRT_CIRCLE_LIMITATION {\
     0 , 1023 , 1448 , 1773 , 2047 , 2289 , 2508 , 2709,\
     2896 , 3071 , 3238 , 3396 , 3547 , 3691 , 3831 , 3965,\
     4095 , 4221 , 4344 , 4463 , 4579 , 4692 , 4802 , 4910,\
     5016 , 5119 , 5221 , 5320 , 5418 , 5514 , 5608 , 5701,\
     5792 , 5882 , 5970 , 6057 , 6143 , 6228 , 6312 , 6394,\
     6476 , 6556 , 6636 , 6714 , 6792 , 6868 , 6944 , 7019,\
     7094 , 7167 , 7240 , 7312 , 7383 , 7454 , 7524 , 7593,\
     7662 , 7730 , 7798 , 7865 , 7931 , 7997 , 8062 , 8127,\
     8191 , 8255 , 8318 , 8381 , 8443 , 8505 , 8567 , 8628,\
     8688 , 8748 , 8808 , 8867 , 8926 , 8985 , 9043 , 9101,\
     9158 , 9215 , 9272 , 9328 , 9384 , 9440 , 9495 , 9550,\
     9605 , 9660 , 9714 , 9768 , 9821 , 9874 , 9927 , 9980,\
     10032 , 10084 , 10136 , 10188 , 10239 , 10290 , 10341 , 10392,\
     10442 , 10492 , 10542 , 10592 , 10641 , 10690 , 10739 , 10788,\
     10836 , 10884 , 10932 , 10980 , 11028 , 11075 , 11123 , 11170,\
     11217 , 11263 , 11310 , 11356 , 11402 , 11448 , 11494 , 11539,\
     11584 , 11630 , 11675 , 11719 , 11764 , 11808 , 11853 , 11897,\
     11941 , 11985 , 12028 , 12072 , 12115 , 12158 , 12201 , 12244,\
     12287 , 12330 , 12372 , 12414 , 12457 , 12499 , 12541 , 12582,\
     12624 , 12665 , 12707 , 12748 , 12789 , 12830 , 12871 , 12911,\
     12952 , 12992 , 13032 , 13073 , 13113 , 13153 , 13192 , 13232,\
     13272 , 13311 , 13350 , 13390 , 13429 , 13468 , 13507 , 13545,\
     13584 , 13623 , 13661 , 13699 , 13737 , 13776 , 13814 , 13851,\
     13889 , 13927 , 13965 , 14002 , 14039 , 14077 , 14114 , 14151,\
     14188 , 14225 , 14262 , 14298 , 14335 , 14372 , 14408 , 14444,\
     14481 , 14517 , 14553 , 14589 , 14625 , 14661 , 14696 , 14732,\
     14767 , 14803 , 14838 , 14874 , 14909 , 14944 , 14979 , 15014,\
     15049 , 15084 , 15118 , 15153 , 15187 , 15222 , 15256 , 15291,\
     15325 , 15359 , 15393 , 15427 , 15461 , 15495 , 15529 , 15562,\
     15596 , 15630 , 15663 , 15697 , 15730 , 15763 , 15797 , 15830,\
     15863 , 15896 , 15929 , 15962 , 15994 , 16027 , 16060 , 16092,\
     16125 , 16157 , 16190 , 16222 , 16254 , 16287 , 16319 , 16351,\
     16383 , 16415 , 16447 , 16479 , 16510 , 16542 , 16574 , 16605,\
     16637 , 16669 , 16700 , 16731 , 16763 , 16794 , 16825 , 16856,\
     16887 , 16918 , 16949 , 16980 , 17011 , 17042 , 17072 , 17103,\
     17134 , 17164 , 17195 , 17225 , 17256 , 17286 , 17316 , 17347,\
     17377 , 17407 , 17437 , 17467 , 17497 , 17527 , 17557 , 17587,\
     17617 , 17646 , 17676 , 17706 , 17735 , 17765 , 17794 , 17824,\
     17853 , 17882 , 17912 , 17941 , 17970 , 17999 , 18028 , 18057,\
     18086 , 18115 , 18144 , 18173 , 18202 , 18231 , 18259 , 18288,\
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

#define ATAN1DIV1     (int16_t)8192
#define ATAN1DIV2     (int16_t)4836
#define ATAN1DIV4     (int16_t)2555
#define ATAN1DIV8     (int16_t)1297
#define ATAN1DIV16    (int16_t)651
#define ATAN1DIV32    (int16_t)326
#define ATAN1DIV64    (int16_t)163
#define ATAN1DIV128   (int16_t)81
#define ATAN1DIV256   (int16_t)41
#define ATAN1DIV512   (int16_t)20
#define ATAN1DIV1024  (int16_t)10
#define ATAN1DIV2048  (int16_t)5
#define ATAN1DIV4096  (int16_t)3
#define ATAN1DIV8192  (int16_t)1

/**
  * @brief  It executes Modulus algorithm.
  * @param  alpha component,
  *         beta component.
  * @retval int16_t Modulus.
  */
// static inline int16_t MCM_Modulus(int16_t alpha, int16_t beta)
// {
//   uint32_t temp_val;
//   __disable_irq();
//   /* Configure and call to CORDIC- */
//   WRITE_REG(CORDIC->CSR,CORDIC_CONFIG_MODULUS);
//   LL_CORDIC_WriteData(CORDIC, (((uint32_t)beta << 16U) | (((uint32_t)alpha) & 0x0000FFFFU)));
//   /* Wait for result */
//   while(LL_CORDIC_IsActiveFlag_RRDY(CORDIC) == 0U)
//   {
//     /* Nothing to do */
//   }
//   /* Read computed modulus */
//   temp_val = ((LL_CORDIC_ReadData(CORDIC) << 16U) >> 16U); /* Avoid Over/underflow when cast to int16_t */
//   __enable_irq();
//   return ((int16_t)temp_val);
//
// }

/**
  * @brief  It executes CORDIC algorithm for rotor position extraction from B-emf alpha and beta.
  * @param  wBemf_alfa_est estimated Bemf alpha on the stator reference frame.
  *         wBemf_beta_est estimated Bemf beta on the stator reference frame.
  * @retval int16_t rotor electrical angle (s16degrees).
  */
// static inline int16_t MCM_PhaseComputation(int32_t wBemf_alfa_est, int32_t wBemf_beta_est)
// {
//
//   /* Configure and call to CORDIC */
//   WRITE_REG(CORDIC->CSR,CORDIC_CONFIG_PHASE);
//   LL_CORDIC_WriteData(CORDIC, (uint32_t)wBemf_alfa_est);
//   LL_CORDIC_WriteData(CORDIC, (uint32_t)wBemf_beta_est);
//
//   /* Read computed angle */
//   uint32_t result;
//   result = LL_CORDIC_ReadData(CORDIC) >> 16U;
//   return ((int16_t)result);
//
// }

/**
  * @brief  This function codify a floting point number into the relative 32bit integer.
  * @param  x Floting point number to be coded.
  * @retval uint32_t Coded 32bit integer.
  */
uint32_t MCM_floatToIntBit(float_t x);

/**
  * @}
  */

/**
  * @}
  */
#endif /* MC_MATH_H*/
/******************* (C) COPYRIGHT 2025 STMicroelectronics *****END OF FILE****/
