xiaokaizip/foc/code/drivers/AS5047/AS5047.c

#include "AS5047.h"
#include "main.h"

//按datasheet中的说到的步骤进行，配置SPI为双全工主机，2字节模式，时钟极性低，相位2，软件使能
//CSN为SPI片选使能信号，低电平使能，配置为输出模式，可以按自己需要修改引脚号。
AS5047_TypeDef Devs[] =
{
	{&hspi3,AS5047_CS0_GPIO_Port,AS5047_CS0_Pin}
};

#define assert_idx(__devidx)   if(__devidx<0 && __devidx >sizeof(Devs)/sizeof(AS5047_TypeDef) ) error_inf_loop();
#define CS_1(__devidx) HAL_GPIO_WritePin(Devs[__devidx].CSNport,Devs[__devidx].CSNpin,GPIO_PIN_SET)
#define CS_0(__devidx) HAL_GPIO_WritePin(Devs[__devidx].CSNport,Devs[__devidx].CSNpin,GPIO_PIN_RESET)

void error_inf_loop() {
	while (1);
}


uint16_t Parity_bit_Calculate(uint16_t data_2_cal) {
	uint16_t parity_bit_value = 0;
	//自低位开始统计奇偶
	while (data_2_cal != 0) {
		//(((⑤^④)^③)^②)^①——表达式1假设⑤和④不同，则⑤^④运算结果为1，表示有一个1。表达式1可以化成：((1^③)^②)^①——表达式2
		parity_bit_value ^= data_2_cal;
		data_2_cal >>= 1;
	}
	return (parity_bit_value & 0x1);
}


uint16_t SPI_ReadWrite_OneByte(int devidx, uint16_t _txdata) {
	assert_idx(devidx);
	CS_0(devidx);
	uint16_t rxdata;
	//waring不用管,传进去的是地址数据不会被截断，HAL库根据配置，按16字节的数据格式将16字节的发送出去
	if (HAL_SPI_TransmitReceive(Devs[devidx].hspin, (uint8_t *) &_txdata, (uint8_t *) &rxdata, 1, 100) != HAL_OK)
		rxdata = 0;
	CS_1(devidx);
	return rxdata;
}

uint16_t AS5047_WriteData(int devidx, uint16_t addr, uint16_t data) {
	//发送地址指令
	// & 0x3fff 得到 13:0位 data数据 进行奇偶校验位计算
	if (Parity_bit_Calculate(addr & 0x3fff) == 1)
		addr |= 0x8000; //将15bit 置1  偶校验
	CS_0(devidx);
	SPI_ReadWrite_OneByte(devidx, addr);
	CS_1(devidx);

	//发送数据指令
	if (Parity_bit_Calculate(data & 0x3fff) == 1)
		data |= 0x8000;

	uint16_t feedback;
	CS_0(devidx);
	feedback = SPI_ReadWrite_OneByte(devidx, data);
	CS_1(devidx);

	return feedback;
}

uint16_t AS5047_ReadData(int devidx, uint16_t addr) {
	uint16_t data;
	if (Parity_bit_Calculate(addr) == 0)
		addr |= 0x8000; //1000 0000 0000 0000
	addr |= AS5047_COMMAND_READ; //0100 0000 0000 0000
	SPI_ReadWrite_OneByte(devidx, addr);
	data = SPI_ReadWrite_OneByte(devidx,NOP_AS5047P_VOL_REG_ADD); //ANGLECOM_AS5047P_VOL_REG_ADD=11 1111 1111
	data &= 0x3fff;

	//	SPI_ReadWrite_OneByte(devidx,addr);
	//	data = SPI_ReadWrite_OneByte(devidx,addr);
	//此处可以做奇偶校验判断是否接收到正确数据，但是也可以不做，直接去掉15，14bit
	data &= 0x3fff;
	return data;
}


void AS5047_Init(void) {
	//设置ABI模式，输出分辨1024.
	for (int i = 0; i < sizeof(Devs) / sizeof(AS5047_TypeDef); i++) {
		AS5047_WriteData(i,SETTINGS1_AS5047P_nVOL_REG_ADD, 5); //0000 0101
		AS5047_WriteData(i,SETTINGS2_AS5047P_nVOL_REG_ADD, 0);
	}
}

void AS5047_SetZeroPosition(int devidx) {
	uint16_t DIAAGC = AS5047_ReadData(devidx,DIAAGC_AS5047P_VOL_REG_ADD);
	//获取当前角度
	uint16_t ANGLEUNC = AS5047_ReadData(devidx,ANGLEUNC_AS5047P_VOL_REG_ADD);
	//												ANGLEUNC是13:0 14个有效数字，右移6获取高8位。
	AS5047_WriteData(devidx,ZPOSM_AS5047P_nVOL_REG_ADD, (ANGLEUNC >> 6) & 0x00ff);
	//																							得到低6位 & 11 1111
	AS5047_WriteData(devidx,ZPOSL_AS5047P_nVOL_REG_ADD, ANGLEUNC & 0x003f);
}

void AS5047_Diagnostics(void) {
	;
}


uint16_t AS5047D_Get_MAGCORDIC_Value(int devidx) {
	unsigned int CORDICMAG = AS5047_ReadData(devidx,MAG_AS5047P_VOL_REG_ADD);
	return CORDICMAG;
}

unsigned int AS5047P_Get_AGC_Value(int devidx) {
	unsigned int DIAAGC = AS5047_ReadData(devidx,DIAAGC_AS5047P_VOL_REG_ADD);
	return (unsigned char) ((DIAAGC >> 8) & 0x00FF);
}


uint16_t AS5047_Get_ZeroPosition(int devidx) {
	uint16_t ZPOSM = AS5047_ReadData(devidx,ZPOSM_AS5047P_nVOL_REG_ADD);
	uint16_t ZPOSL = AS5047_ReadData(devidx,ZPOSL_AS5047P_nVOL_REG_ADD);
	//将高八位和低6位拼起来
	return (ZPOSM << 6) & (ZPOSL & 0x003f);
}

uint16_t AS5047_Get_ERRFL(int devidx) {
	return AS5047_ReadData(devidx,ERRFL_AS5047P_VOL_REG_ADD);
}
