xiaokaizip/foc/STSPIN32G4_FOC/applications/foc/math_ops.h

#ifndef MATH_OPS_H
#define MATH_OPS_H

#ifdef __cplusplus
extern "C" {
#endif

#include "math.h"


#define PI 3.14159265359f
#define SQRT3 1.73205080757f

float fmaxf(float x, float y);

float fminf(float x, float y);

float fmaxf3(float x, float y, float z);

float fminf3(float x, float y, float z);

float roundf(float x);

void limit_norm(float *x, float *y, float limit);

void limit(float *x, float min, float max);

int float_to_uint(float x, float x_min, float x_max, int bits);

float uint_to_float(int x_int, float x_min, float x_max, int bits);

float FastSin(float theta);

float FastCos(float theta);

#ifdef __cplusplus
}
#endif

#endif
