xiaokaizip/foc/(commit log)

2025-09-24 Finish angle loop.
    [board.cfg]
2025-09-24 Add serial communication, but the reception function have some problem which need to add flag bits.
    [foc.cpp, foc.h, foc.ioc, main.c, main.cpp, velocityPositionLoopController.h]
2025-09-25 Finish the modbus with serial.The next step need to finish the calibration.
2025-09-25 Fix the position_sensor.cpp, add zero position. Finish the velocity position loop, but the param need to perfect.
    [LUT.h, foc.h, main.cpp, math_ops.c, math_ops.h, open_loop_controller.cpp]
2025-09-26 Finish the position velocity current loop.But the param need to be better.
2025-09-27 Add cadence project.
    [HPM_ECAT_FOC.DSN, hpm_ecat_foc.opj]
2025-09-28 Fix the currentControl loop.
    [currentControl.cpp, currentControl.h, main.cpp, math_ops.h]
2025-09-29 Add phase calibration.But the calibrated function didn't add to fsm.The next time need to add fsm and flash to write the calibrated param.
    [calibrationPhase.cpp, calibrationPhase.h, currentControl.cpp, currentControl.h, main.cpp, open_loop_controller.cpp, open_loop_controller.h, position_sensor.cpp]
2025-10-15 I ported the ODrive code, but the CMake files weren't configured properly, and after porting, the control loop won't run.
    [LUT.h, adc.c, calibrationPhase.cpp, calibrationPhase.h]
2025-10-16 Porting the ODrive code, currently performing serial debugging.
2025-10-21 Add USB device.Add velocity loop and position velocity loop.
2025-10-22 The schematic for the STM32 FOC has been completed, but the component selection needs to be redone.
    [HPM_ECAT_FOC.DSN, STSPIN32G4_FOC.DSN, STSPIN32G4_foc.opj, cases.cfg, hpm_ecat_foc.opj, stspin32g4_foc.brd]
2025-10-23 Using can to control motor.
2025-11-12 The hardware design of the motor driver based on STM32G4 has been basically completed.
    [DM3510.dxf, STSPIN32G4_FOC.DSN, STSPIN32G4_foc.opj, art_param.txt, nc_param.txt, stspin32g4_foc.brd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]
2025-11-13 Fix silkscreen.
    [art_param.txt, stspin32g4_foc.brd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]
2025-12-11 Finished PCB.
    [20251127 -便携式数据采集线材-林凯.xlsx, HPM_ECAT_FOC.DSN, STSPIN32G4.xlsx, STSPIN32G4_FOC.DSN, STSPIN32G4_FOC.xlsx, STSPIN32G4_foc.opj, hpm_ecat_foc.opj, nc_param.txt]
2025-12-11 Fixed the footprint.
    [STSPIN32G4_FOC.DSN, STSPIN32G4_foc.opj, stspin32g4_foc.brd]
2025-12-29 Add reset circuit
    [ETHERCAT_A.kicad_sch, ETHERCAT_B.kicad_sch, ETH_RGMII.kicad_sch, FOC_DRIVER.kicad_sch, MCU_POWER.kicad_sch, POWER.kicad_sch, STSPIN32G4_FOC.DSN, STSPIN32G4_FOC.xlsx]
2026-01-06 Add boot circuit
    [STSPIN32G4_FOC.DSN, STSPIN32G4_FOC.xlsx, STSPIN32G4_foc.opj, board.cfg, stspin32g4_foc.brd]
2026-01-14 Add STSPING4 code.
    [board.cfg]
2026-01-26 Add bootloader.
    [DESIGN1.DSN, Design1.opj, POWER.DSN, POWER.opj, STSPIN32G4_foc.opj]
2026-02-06 Add mt6825.
    [STSPIN32G4_foc.opj]
2026-02-06 Add encoder.
