xiaokaizip/foc/(notices)

Notices in the files:
code/board/odrive/Core/Inc/main.h:
This software is licensed under terms that can be found in the LICENSE file
STSPIN32G4_FOC/boards/foc/Core/Src/adc.c:
Copyright (c) 2026 STMicroelectronics.
All rights reserved.
